orpheus016/sg13cmos5l_spma_ip__instramp/xschem/gain_network/README.md

# coarse_gain

<!-- AUTO:schematic:gain_network -->
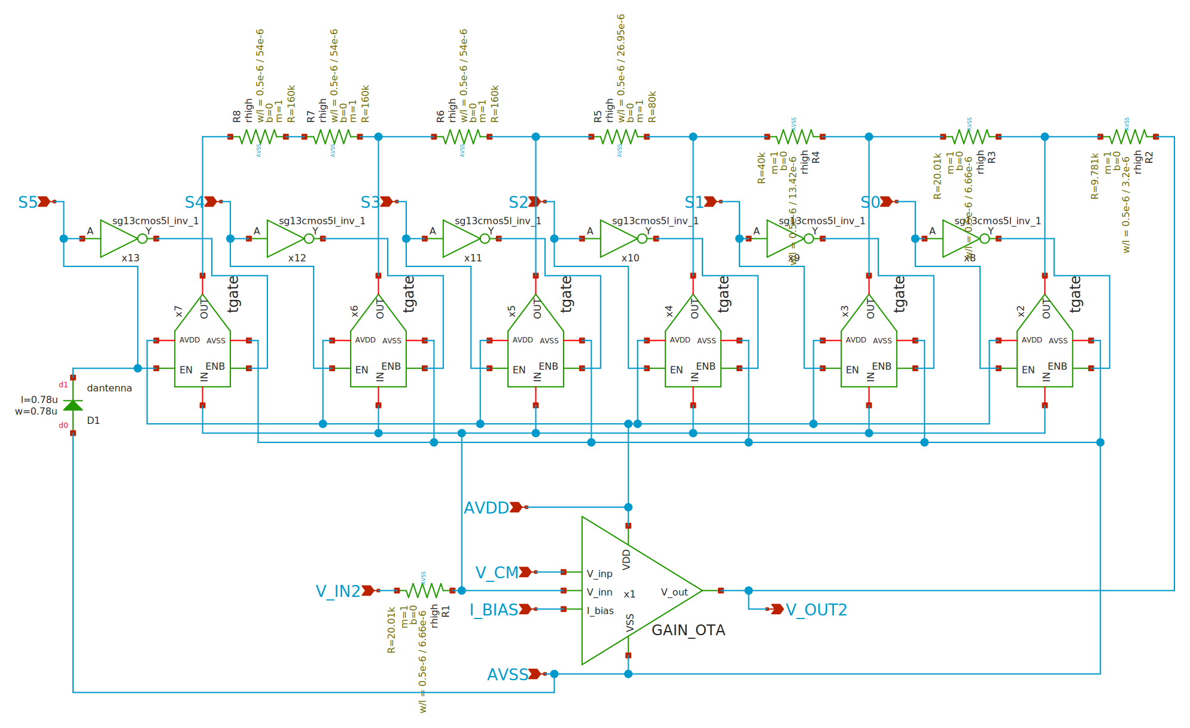
[picture p7: docs/gain_network/media/gain_network_schematic.png]
gain_network schematic

<!-- /AUTO -->

<!-- AUTO:schematic:coarse_gain -->
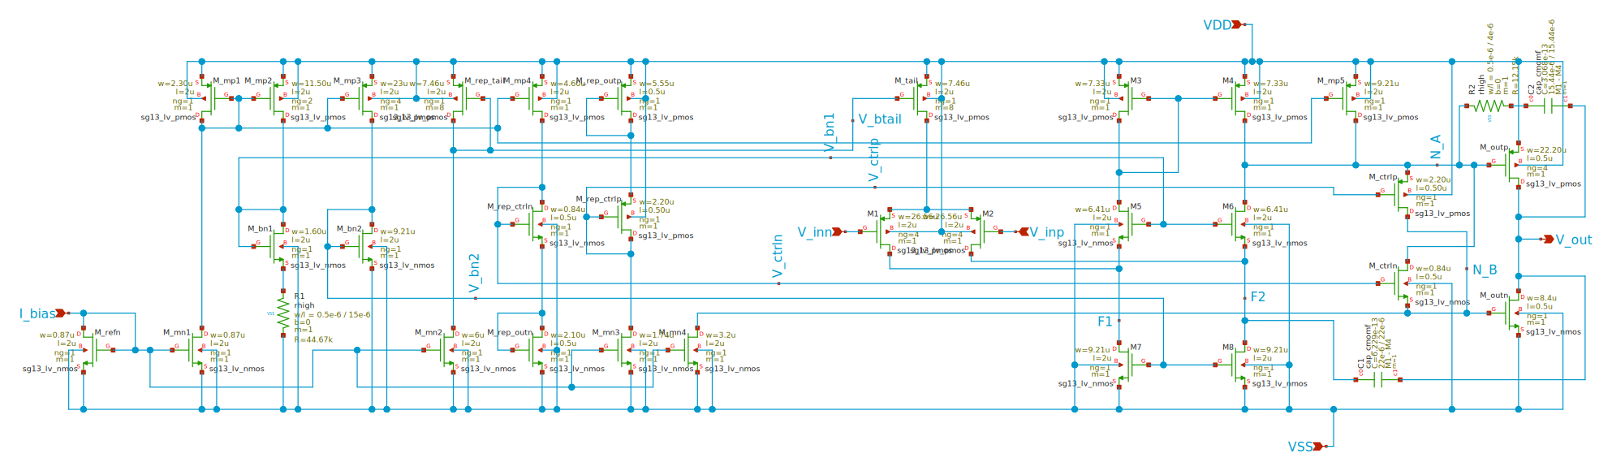
[picture p8: docs/coarse_gain/media/coarse_gain_schematic.png]
coarse_gain schematic


coarse_gain cg_network
<!-- /AUTO -->
