orpheus016/sg13cmos5l_spma_ip__instramp/xschem/gain_ota/README.md

# gain_ota

<!-- AUTO:schematic:gain_ota -->
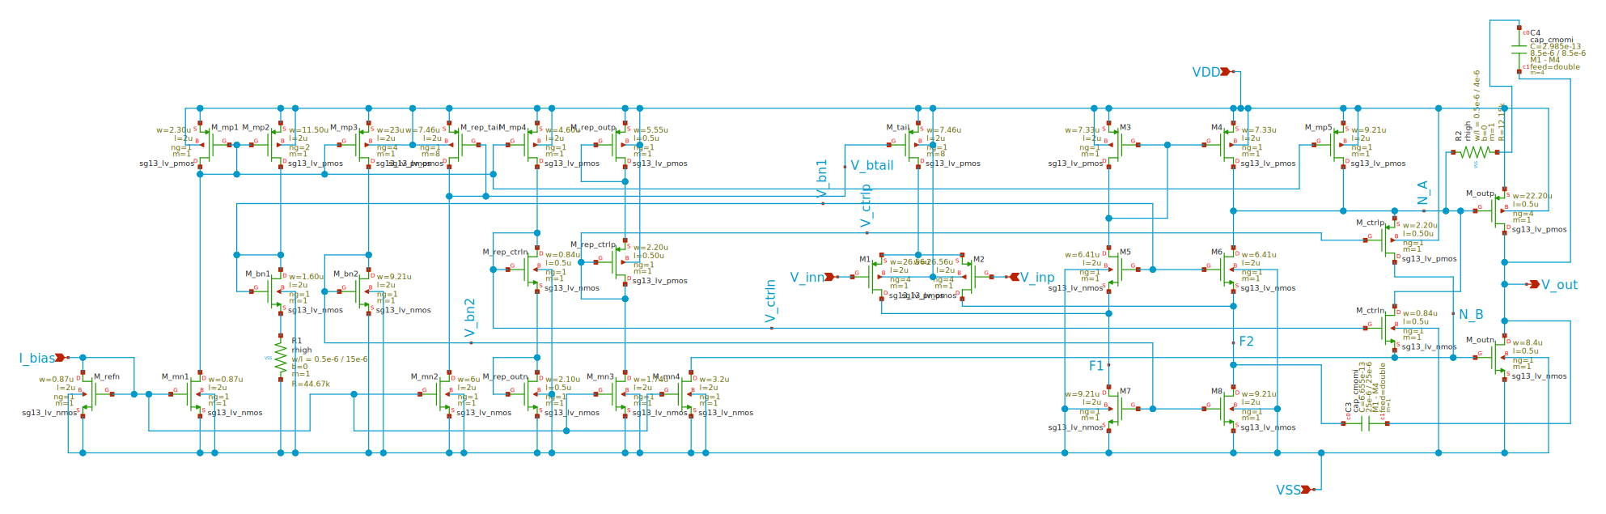
[picture p9: docs/gain_ota/media/gain_ota_schematic.png]
gain_ota schematic

<!-- /AUTO -->
