orpheus016/sg13cmos5l_spma_ip__instramp/docs/pgia_top/cace/README.md

# pgia_top - CACE characterisation

- Generated: 2026-11-05 21:37 by `scripts/make_readme.py` from `runs/RUN_2026-11-05_21-15-09`
- Commit: `a3285dc` (working tree dirty)
- Netlist source: schematic; datasheet: `cace/pgia_top.yaml`; reproduce with `scripts/run_cace.sh pgia_top`
- Sections marked *(CACE)* are written by CACE itself, the rest by this script (CACE has no per-corner MC statistics, worst-case conditions or unit-scaled spread plots).

## Design *(CACE)*

- Description: Top-level Programmable Gain Instrumentation Amplifier IP with 11 gain steps (8x to 8192x)
- PDK: ihp-sg13cmos5l

### Authorship

- Designer: SPMA
- Created: October 23, 2026
- License: MIT
- Company: None
- Last modified: None

### Pins

- AVDD
  + Description: Positive analog power supply (1.2V typ)
  + Type: power
  + Direction: inout
  + Vmin: 1.08
  + Vmax: 1.5
- VPWR
  + Description: Positive digital power supply for decoder (1.2V typ)
  + Type: power
  + Direction: inout
  + Vmin: 1.08
  + Vmax: 1.5
- AVSS
  + Description: Analog ground (0V)
  + Type: ground
  + Direction: inout
- VGND
  + Description: Digital ground for decoder (0V)
  + Type: ground
  + Direction: inout
- IBIAS_IA
  + Description: Bias current input = ibias0 of the harness (1.0 uA sourced into the pin; central_bias makes the IA 4.4 / buffer 1.5 / stage 1.1 uA currents)
  + Type: signal
  + Direction: input
- VINP
  + Description: Non-inverting differential analog input
  + Type: signal
  + Direction: input
- VINN
  + Description: Inverting differential analog input
  + Type: signal
  + Direction: input
- VCM
  + Description: Common-mode reference voltage (0.6V typ)
  + Type: signal
  + Direction: input
- gain_sel[0]
  + Description: Digital gain select bit 0 (LSB)
  + Type: signal
  + Direction: input
- gain_sel[1]
  + Description: Digital gain select bit 1
  + Type: signal
  + Direction: input
- gain_sel[2]
  + Description: Digital gain select bit 2
  + Type: signal
  + Direction: input
- gain_sel[3]
  + Description: Digital gain select bit 3 (MSB)
  + Type: signal
  + Direction: input
- VOUT
  + Description: Single-ended analog output
  + Type: signal
  + Direction: output

### Default Conditions

- vdd
  + Description: Analog and digital power supply voltage
  + Display: Vdd
  + Unit: V
  + Typical: 1.2
- vcm
  + Description: Common-mode voltage
  + Display: Vcm
  + Unit: V
  + Typical: 0.6
- ib_ia
  + Description: Current sourced into the single bias pin IBIAS_IA (ibias0); 0.7 .. 1.3 uA is the working window (xschem/central_bias/README.md)
  + Display: Ib_ia
  + Unit: uA
  + Typical: 1.0
- cl
  + Description: Output load capacitance
  + Display: CLoad
  + Unit: pF
  + Typical: 15
- rl
  + Description: Output load resistance
  + Display: RLoad
  + Unit: kOhm
  + Typical: 100
- cin
  + Description: Input AC coupling capacitance
  + Display: Cin
  + Unit: nF
  + Typical: 10
- vin_off
  + Description: Intentional DC offset on VINP (relative to VCM) that cancels the systematic input-referred offset of the chip. 0 = chip as built; -334.7 uV = the value of tb_pgia_top, the null of the SCHEMATIC; -903.7 uV = the null of the EXTRACTED LAYOUT (C and RC netlists). With the right null gain codes 8 to 10 (x2000 .. x8192) stay in range, without it they rail
  + Display: Vin_off
  + Unit: uV
  + Typical: 0
- gain_code
  + Description: Active 4-bit binary gain code (0 to 10 valid, 11 clamped)
  + Display: Code
  + Typical: 0
- corner
  + Description: Process corner
  + Display: Corner
  + Typical: tt
- rcorner
  + Description: Resistor corner (res_<rcorner> section of cornerRES.lib)
  + Display: Rcorner
  + Typical: typ
- temperature
  + Description: Ambient temperature
  + Display: Temp
  + Unit: °C
  + Typical: 27

### Symbol

Symbol of pgia_top

### Schematic

Schematic of pgia_top

**Parameters** (`.param` of the schematic and of the cells it instantiates; generated by `scripts/update_images.py`, do not edit)

| Source | Parameter | Value |
|---|---|---|
| ota_cmos5l (x1, x2, x3) | `temp` | `27` |
| ota_cmos5l (x1, x2, x3) | `lbias` | `0.15u` |
| ota_cmos5l (x1, x2, x3) | `wbias` | `0.15u` |
| ota_cmos5l (x1, x2, x3) | `m6` | `1` |
| ota_cmos5l (x1, x2, x3) | `m7` | `4` |
| ota_cmos5l (x1, x2, x3) | `m8` | `8` |
| ota_cmos5l (x1, x2, x3) | `linpair` | `3u` |
| ota_cmos5l (x1, x2, x3) | `winpair` | `20u` |
| ota_cmos5l (x1, x2, x3) | `lload` | `5u` |
| ota_cmos5l (x1, x2, x3) | `wload` | `10u` |
| ota_cmos5l (x1, x2, x3) | `lcs` | `3u` |
| ota_cmos5l (x1, x2, x3) | `wcs` | `20u` |
| ota_cmos5l (x1, x2, x3) | `Cc` | `2p` |

### Layout

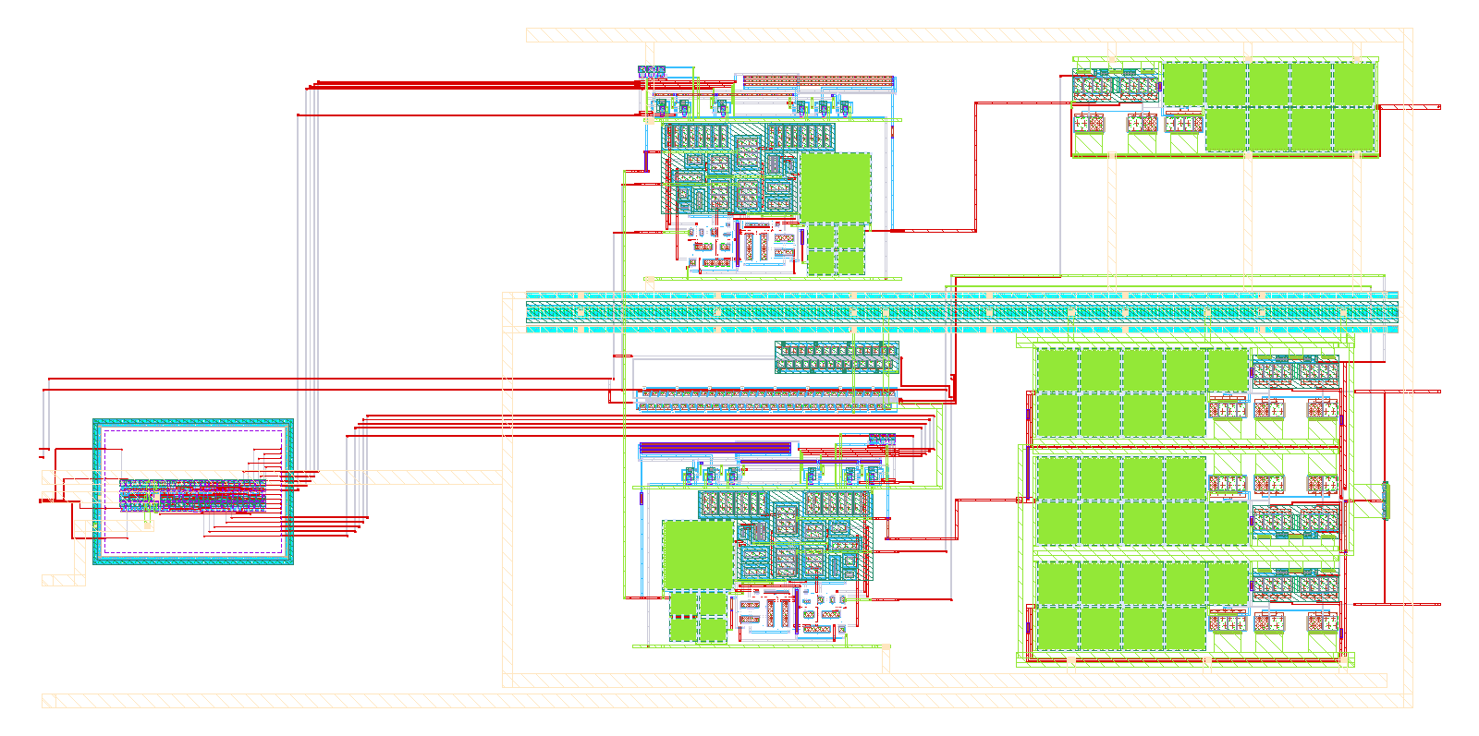
[picture p31: docs/pgia_top/media/pgia_top_layout.png]
Layout of pgia_top


**Physical size** (bounding box of `pgia_top`; generated by `scripts/update_images.py`)

| Width W | Length L | Area |
|---|---|---|
| 514.60 µm | 250.00 µm | 128650 µm² |

## Results summary *(CACE)*

min / typ / max over all conditions of a parameter; Monte Carlo parameters (`mc_*`) are min/max over all samples.

**netlist source**: schematic

| Parameter | Tool | Result | Min Limit  |  Min Value | Typ Target |  Typ Value | Max Limit  |  Max Value |  Status  |
| :--- | :--- | :--- | ---: | ---: | ---: | ---: | ---: | ---: | :---: |
| Closed-loop gain @1 kHz | ngspice | A_CL | any | -157.273 dB | 18.06 dB |  28.225 dB | any |  77.375 dB | Pass ✅ |
| Gain step error vs target | ngspice | A_ERR | any | -235.541 dB | any |  -3.185 dB | any |  23.554 dB | Pass ✅ |
| -3 dB bandwidth | ngspice | F3DB | 1000 Hz | 1421.280 Hz | any | 212798.500 Hz | any | 44479600.000 Hz | Pass ✅ |
| 0 dB frequency | ngspice | F0DB | any | 4883.770 Hz | any | 2894975.000 Hz | any | 10000000.000 Hz | Pass ✅ |
| Phase @1 kHz | ngspice | PH_1K | any | -179.920 ° | any | -0.378 ° | any |  179.972 ° | Pass ✅ |
| Input pseudo-resistor | ngspice | R_PSEUDO | 1 GOhm | 3.563 GOhm | 15 GOhm | 13.573 GOhm | any | 43.802 GOhm | Pass ✅ |
| Output offset voltage | ngspice | VOS | any | 0.026 mV | 1.08 mV |  80.184 mV | any | 661.207 mV | Pass ✅ |
| IA output DC voltage | ngspice | V_IA | any | 0.593 V | 0.6 V | 0.601 V | any | 0.610 V | Pass ✅ |
| Stage 1 output DC voltage | ngspice | V_ST1 | any | 0.273 V | 0.6 V | 0.597 V | any | 1.070 V | Pass ✅ |
| Stage 2 output DC voltage | ngspice | V_ST2 | any | 0.000 V | 0.6 V | 0.601 V | any | 1.500 V | Pass ✅ |
| DC output voltage | ngspice | VOUT | any | 0.011 V | 0.6 V | 0.600 V | any | 1.261 V | Pass ✅ |
| Analog supply current | ngspice | I_AVDD | any | 166.433 uA | 216 uA | 229.546 uA | 400 uA | 315.963 uA | Pass ✅ |
| Digital supply current | ngspice | I_VPWR | any | 0.001 uA | 0.014 uA | 0.021 uA | 1.0 uA | 0.478 uA | Pass ✅ |
| Total quiescent current | ngspice | IQ_TOT | any | 166.434 uA | 216 uA | 229.565 uA | 400 uA | 316.416 uA | Pass ✅ |
| Total DC power | ngspice | PWR | any | 179.749 uW | 260 uW | 272.885 uW | 500 uW | 474.624 uW | Pass ✅ |
| Output peak-to-peak  | ngspice | VPP_OUT | any | 0.000 mV | any | 3.800 mV | any | 544.773 mV | Pass ✅ |
| Effective voltage gain | ngspice | EFF_GAIN | any |  0.000 V/V | any | 94.990 V/V | any | 13619.300 V/V | Pass ✅ |

### Plots *(CACE)*

#### ac_gain_A_CL_vs_temperature

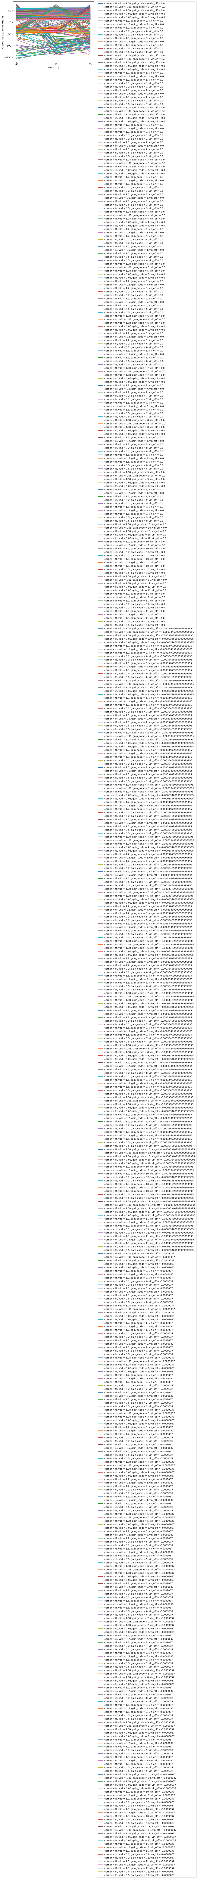
[picture p32: docs/pgia_top/cace/pgia_top/schematic/ac_gain_A_CL_vs_temperature.png]
ac_gain_A_CL_vs_temperature


#### ac_gain_F3DB_vs_temperature

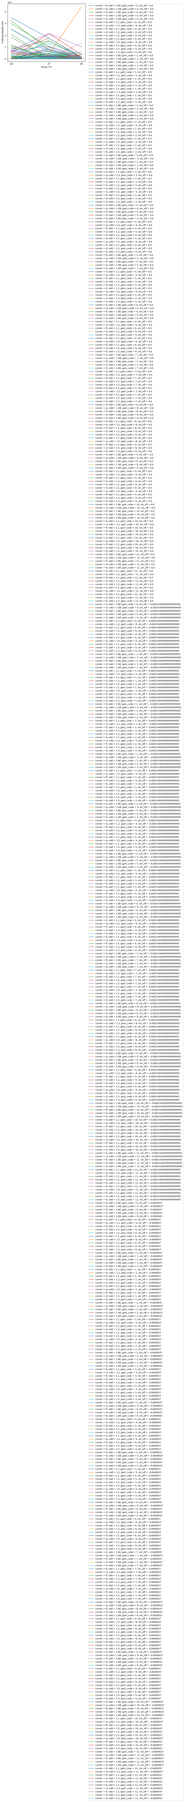
[picture p33: docs/pgia_top/cace/pgia_top/schematic/ac_gain_F3DB_vs_temperature.png]
ac_gain_F3DB_vs_temperature


#### ac_gain_A_CL_vs_gain_code

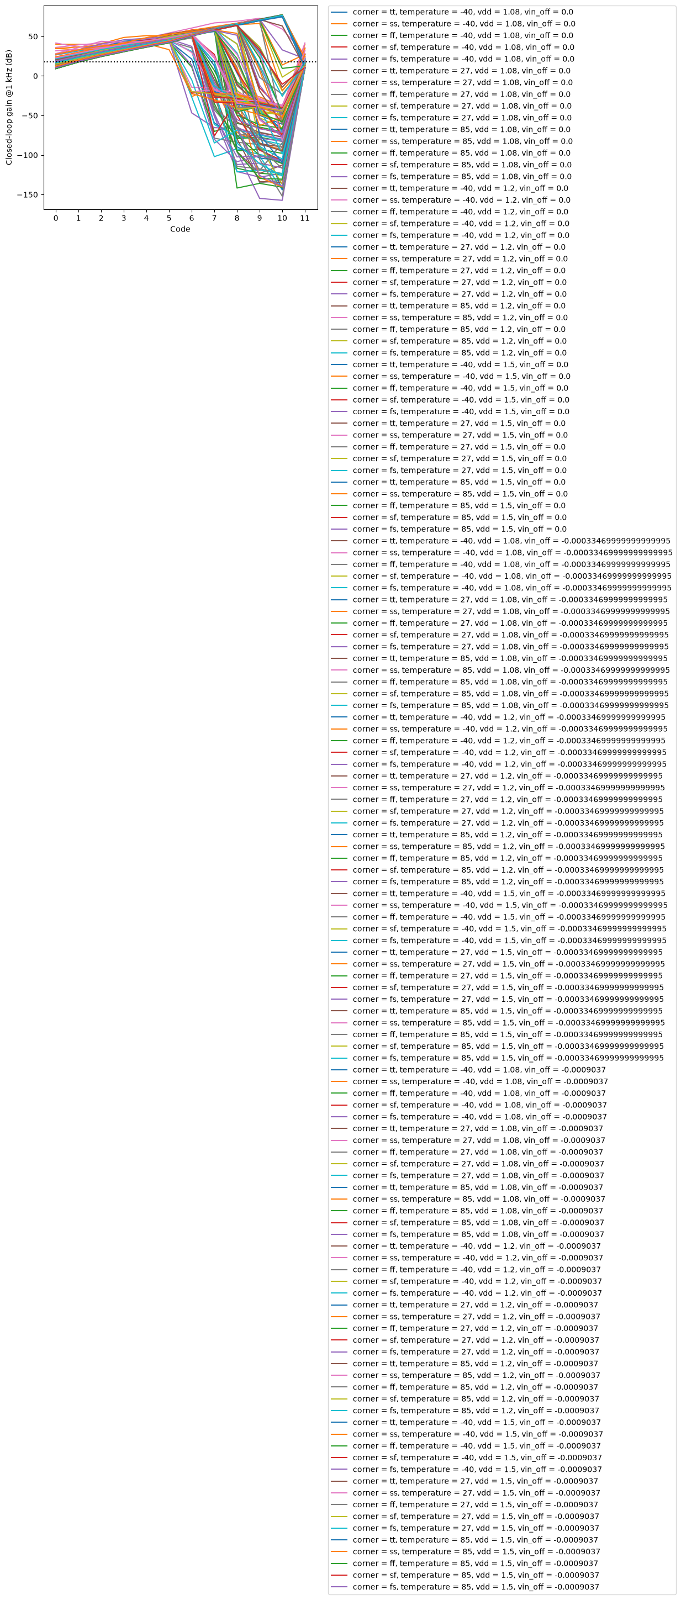
[picture p34: docs/pgia_top/cace/pgia_top/schematic/ac_gain_A_CL_vs_gain_code.png]
ac_gain_A_CL_vs_gain_code


#### ac_gain_R_PSEUDO_vs_temperature

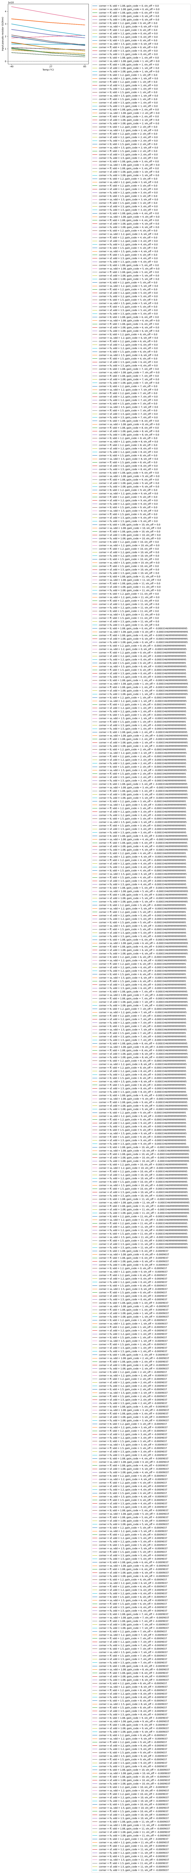
[picture p35: docs/pgia_top/cace/pgia_top/schematic/ac_gain_R_PSEUDO_vs_temperature.png]
ac_gain_R_PSEUDO_vs_temperature


#### dc_op_VOS_vs_temperature

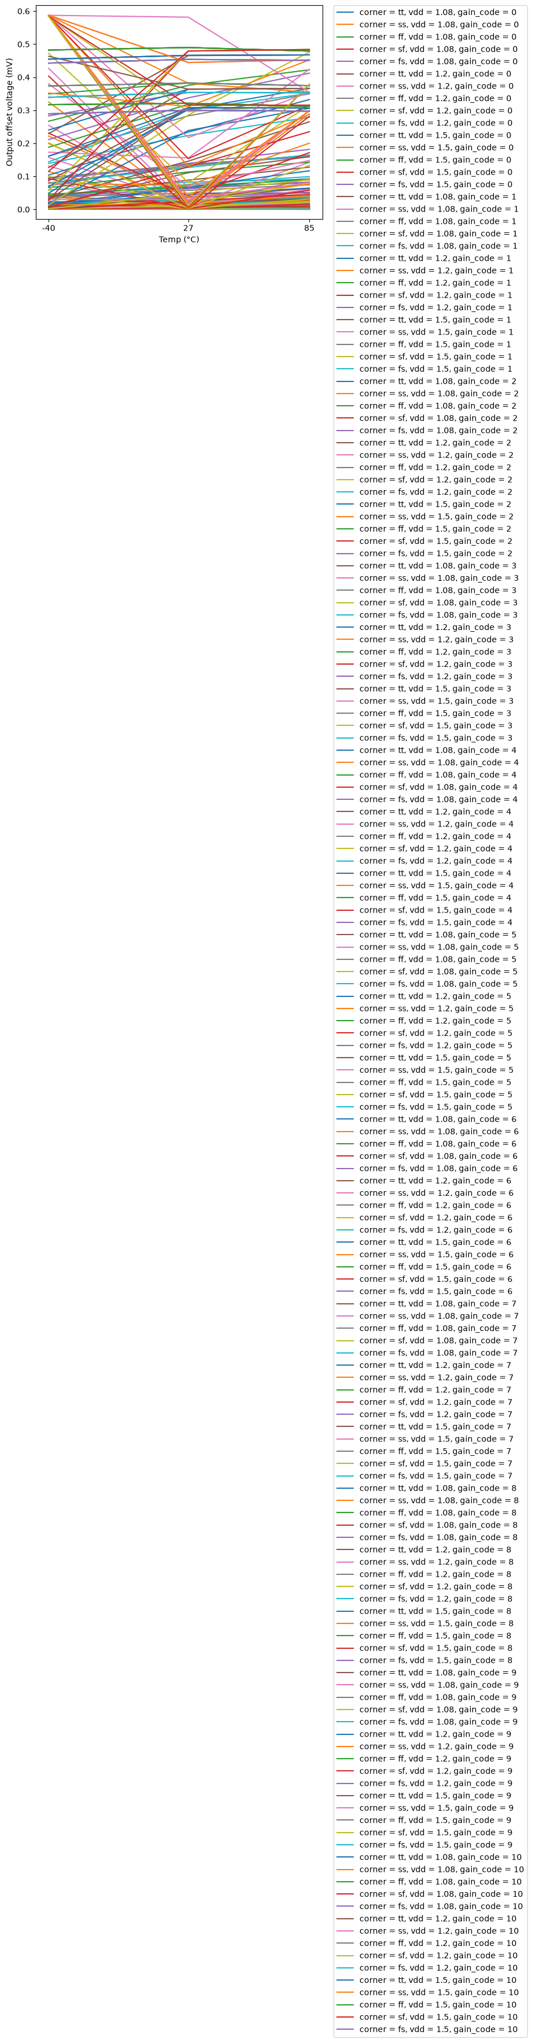
[picture p36: docs/pgia_top/cace/pgia_top/schematic/dc_op_VOS_vs_temperature.png]
dc_op_VOS_vs_temperature


#### dc_op_PWR_vs_temperature

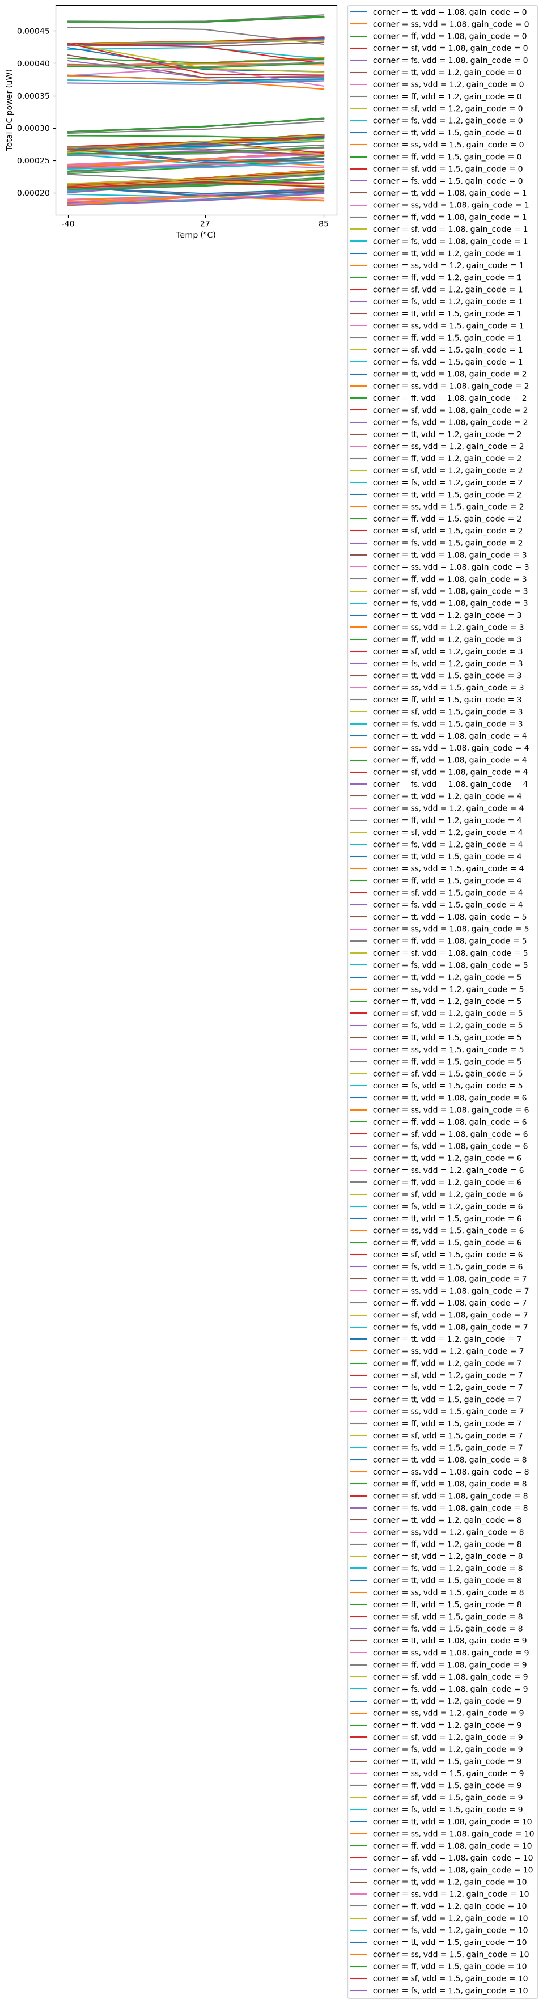
[picture p37: docs/pgia_top/cace/pgia_top/schematic/dc_op_PWR_vs_temperature.png]
dc_op_PWR_vs_temperature


#### dc_op_IQ_TOT_vs_vdd

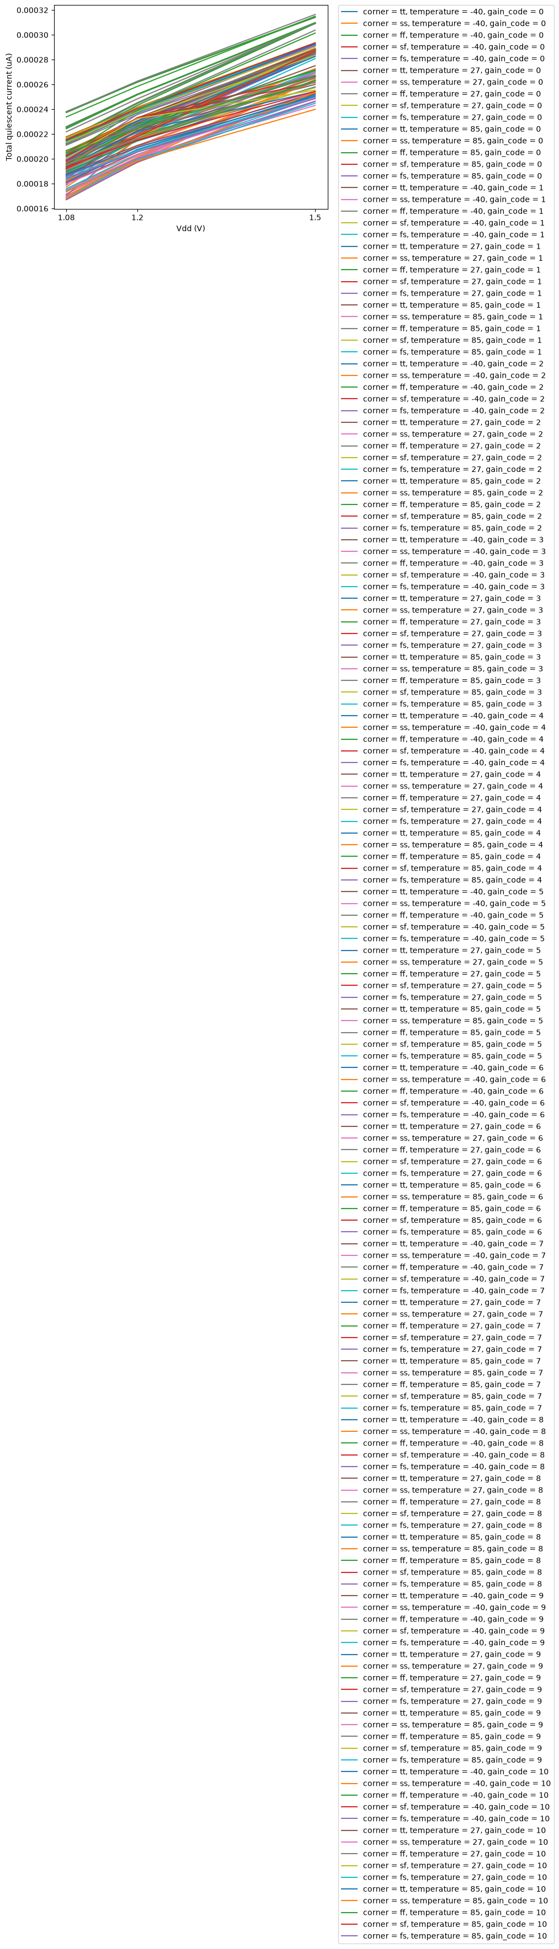
[picture p38: docs/pgia_top/cace/pgia_top/schematic/dc_op_IQ_TOT_vs_vdd.png]
dc_op_IQ_TOT_vs_vdd


#### tran_VPP_OUT_vs_gain_code

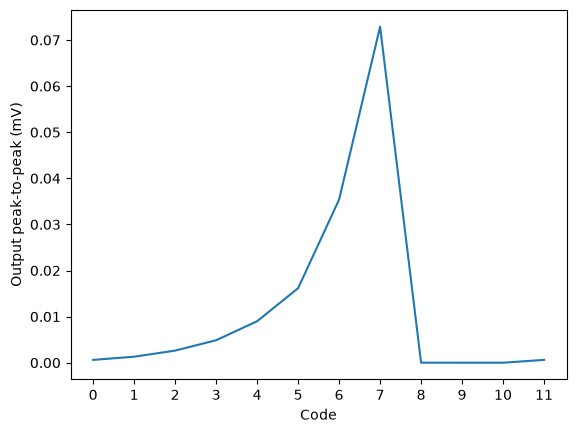
[picture p39: docs/pgia_top/cace/pgia_top/schematic/tran_VPP_OUT_vs_gain_code.png]
tran_VPP_OUT_vs_gain_code


#### tran_EFF_GAIN_vs_gain_code

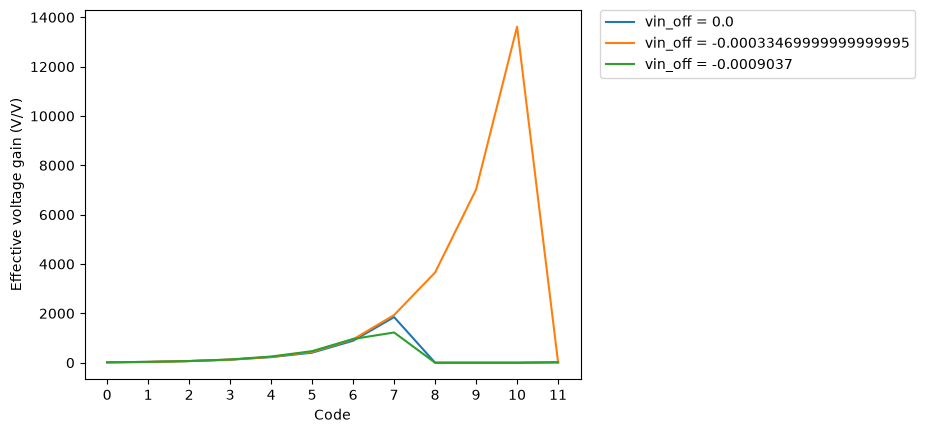
[picture p40: docs/pgia_top/cace/pgia_top/schematic/tran_EFF_GAIN_vs_gain_code.png]
tran_EFF_GAIN_vs_gain_code


## PVT worst-case conditions

Corners tt/ss/ff/sf/fs, supply and temperature as in the yaml. Values in the display unit of the yaml.

### ac_gain - Closed-loop AC gain & bandwidth

1620 runs.

| metric | min | at (corner, vdd, T) | max | at (corner, vdd, T) | spec | fails |
|---|---|---|---|---|---|---|
| A_CL [dB] | -157.3 | fs, 1.5 V, -40 C | 77.38 | tt, 1.08 V, -40 C | any | - |
| A_ERR [dB] | -235.5 | fs, 1.5 V, -40 C | 23.55 | ss, 1.08 V, -40 C | any | - |
| F3DB [Hz] | 1421 | fs, 1.08 V, -40 C | 4.448e+07 | ss, 1.5 V, 85 C | >= 1000 | 0 |
| F0DB [Hz] | 4884 | ff, 1.08 V, 27 C | 1e+07 | ss, 1.08 V, -40 C | any | - |
| PH_1K [°] | -179.9 | ss, 1.5 V, 85 C | 180 | sf, 1.2 V, 27 C | any | - |
| R_PSEUDO [GOhm] | 3.563 | ff, 1.08 V, 85 C | 43.8 | ss, 1.5 V, -40 C | >= 1 | 0 |

### dc_op - DC operating point

1485 runs.

| metric | min | at (corner, vdd, T) | max | at (corner, vdd, T) | spec | fails |
|---|---|---|---|---|---|---|
| VOS [mV] | 0.02615 | sf, 1.5 V, 27 C | 661.2 | ff, 1.5 V, 85 C | any | - |
| V_IA [V] | 0.5934 | ff, 1.5 V, -40 C | 0.61 | ss, 1.08 V, 27 C | any | - |
| V_ST1 [V] | 0.2733 | fs, 1.08 V, 85 C | 1.07 | ss, 1.08 V, -40 C | any | - |
| V_ST2 [V] | 0.0001096 | ff, 1.5 V, -40 C | 1.5 | ff, 1.5 V, -40 C | any | - |
| VOUT [V] | 0.01084 | fs, 1.08 V, -40 C | 1.261 | ff, 1.5 V, 85 C | any | - |
| I_AVDD [uA] | 166.4 | ss, 1.08 V, -40 C | 316 | ff, 1.5 V, 85 C | <= 400 | 0 |
| I_VPWR [uA] | 0.001241 | ss, 1.08 V, -40 C | 0.4783 | ff, 1.5 V, 85 C | <= 1 | 0 |
| IQ_TOT [uA] | 166.4 | ss, 1.08 V, -40 C | 316.4 | ff, 1.5 V, 85 C | <= 400 | 0 |
| PWR [uW] | 179.7 | ss, 1.08 V, -40 C | 474.6 | ff, 1.5 V, 85 C | <= 500 | 0 |

### tran - Dynamic transient response

36 runs.

| metric | min | at (corner, vdd, T) | max | at (corner, vdd, T) | spec | fails |
|---|---|---|---|---|---|---|
| VPP_OUT [mV] | 1.543e-06 | tt, 1.2 V, 27 C | 544.8 | tt, 1.2 V, 27 C | any | - |
| EFF_GAIN [V/V] | 3.857e-05 | tt, 1.2 V, 27 C | 1.362e+04 | tt, 1.2 V, 27 C | any | - |

## Monte Carlo (local mismatch)

Mismatch models only (`mos_<corner>_mismatch`, `res_typ_mismatch`; `cap_cmomi` has no characterised spread), one seed per iteration (`seed = 12345 + iteration`, **the same 50 mismatch draws are reused at every corner and temperature**, so boxes are paired comparisons and the pooled counts overstate the number of independent samples: 50, not 50 x 15). Box = interquartile range, dots = individual samples, dotted lines = spec (if any).
