orpheus016/sg13cmos5l_spma_ip__instramp/docs/pgia_top/cace/pgia_top_schematic.md

# CACE Summary for pgia_top

**netlist source**: schematic

| Parameter | Tool | Result | Min Limit  |  Min Value | Typ Target |  Typ Value | Max Limit  |  Max Value |  Status  |
| :--- | :--- | :--- | ---: | ---: | ---: | ---: | ---: | ---: | :---: |
| Closed-loop gain @1 kHz | ngspice | A_CL | any | -157.273 dB | 18.06 dB |  26.910 dB | any |  77.375 dB | Pass ✅ |
| Gain step error vs target | ngspice | A_ERR | any | -235.541 dB | any |  -3.527 dB | any |  21.937 dB | Pass ✅ |
| -3 dB bandwidth | ngspice | F3DB | 1000 Hz | 1421.280 Hz | any | 220131.000 Hz | any | 44479600.000 Hz | Pass ✅ |
| 0 dB frequency | ngspice | F0DB | any | 27614.500 Hz | any | 2838315.000 Hz | any | 10000000.000 Hz | Pass ✅ |
| Phase @1 kHz | ngspice | PH_1K | any | -179.244 ° | any | -0.377 ° | any |  179.812 ° | Pass ✅ |
| Input pseudo-resistor | ngspice | R_PSEUDO | 1 GOhm | 3.563 GOhm | 15 GOhm | 13.559 GOhm | any | 43.789 GOhm | Pass ✅ |
| Output offset voltage | ngspice | VOS | any | 0.026 mV | 1.08 mV |  81.581 mV | any | 661.207 mV | Pass ✅ |
| IA output DC voltage | ngspice | V_IA | any | 0.600 V | 0.6 V | 0.603 V | any | 0.610 V | Pass ✅ |
| Stage 1 output DC voltage | ngspice | V_ST1 | any | 0.273 V | 0.6 V | 0.565 V | any | 0.916 V | Pass ✅ |
| Stage 2 output DC voltage | ngspice | V_ST2 | any | 0.000 V | 0.6 V | 0.634 V | any | 1.500 V | Pass ✅ |
| DC output voltage | ngspice | VOUT | any | 0.012 V | 0.6 V | 0.633 V | any | 1.261 V | Pass ✅ |
| Analog supply current | ngspice | I_AVDD | any | 167.053 uA | 216 uA | 225.907 uA | 400 uA | 315.963 uA | Pass ✅ |
| Digital supply current | ngspice | I_VPWR | any | 0.001 uA | 0.014 uA | 0.021 uA | 1.0 uA | 0.478 uA | Pass ✅ |
| Total quiescent current | ngspice | IQ_TOT | any | 167.059 uA | 216 uA | 225.949 uA | 400 uA | 316.416 uA | Pass ✅ |
| Total DC power | ngspice | PWR | any | 180.424 uW | 260 uW | 269.308 uW | 500 uW | 474.624 uW | Pass ✅ |
| Output peak-to-peak  | ngspice | VPP_OUT | any | 0.000 mV | any | 1.969 mV | any |  73.973 mV | Pass ✅ |
| Effective voltage gain | ngspice | EFF_GAIN | any |  0.000 V/V | any | 49.237 V/V | any | 1849.330 V/V | Pass ✅ |

## Plots

## ac_gain_A_CL_vs_temperature

ac_gain_A_CL_vs_temperature

## ac_gain_F3DB_vs_temperature

ac_gain_F3DB_vs_temperature

## ac_gain_A_CL_vs_gain_code

ac_gain_A_CL_vs_gain_code

## ac_gain_R_PSEUDO_vs_temperature

ac_gain_R_PSEUDO_vs_temperature

## dc_op_VOS_vs_temperature

dc_op_VOS_vs_temperature

## dc_op_PWR_vs_temperature

dc_op_PWR_vs_temperature

## dc_op_IQ_TOT_vs_vdd

dc_op_IQ_TOT_vs_vdd

## tran_VPP_OUT_vs_gain_code

tran_VPP_OUT_vs_gain_code

## tran_EFF_GAIN_vs_gain_code

tran_EFF_GAIN_vs_gain_code
