orpheus016/sg13cmos5l_spma_ip__instramp/docs/gain_ota/status.md

# gain_ota: flow status

`scripts/flow.sh gain_ota` at 2026-11-05T21:09:51 (commit a3285dc, profile typ)

layout `gds/gain_ota/gain_ota.gds` sha1 `e2632fd500b4`, schematic `xschem/gain_ota/gain_ota.sch` sha1 `d747b5e7626f`

| Stage | Result | Time | Detail |
|---|---|---:|---|
| cace | ✅ pass | 0 s | reused RUN_2026-11-05_17-29-30: 44 rows, 0 failing |
| drc | ✅ pass | 19 s | main : 0 items [ok];antenna : 0 items [ok];density : 7 items [info, chip-level]; |
| audit | ✅ pass | 0 s |  all device Activ within the tie distance, every NWell tied; no p+/n+ abutment outside standard cells; |
| lvs | ✅ pass | 8 s | RESULT: MATCH |
| pex | ✅ pass | 14 s | gain_ota.c.spice: ports VDD V_inp V_inn V_out I_bias VSS; M=57, Rpoly=2, Rext=0, Cdev=5, Cext=182, D=0;gain_ota.rc.spice: ports VDD V_inp V_inn V_out I_bias VSS; X=59, R=2397, C=585, Cdev=5; |
| post_c | ✅ pass | 18 s | 41 parameters with a % delta, 27 flagged |
| post_rc | ✅ pass | 36 s | 41 parameters with a % delta, 22 flagged |
| images | ✅ pass | 1 s | 0 updated, 5 unchanged, 0 error(s), 0 warning(s) |
| post | ⏭ skip | 0 s | no layout |

Schematic vs post-layout (wire C only): [postlayout.md](cace/postlayout.md)

Schematic vs post-layout (wire R + C): [postlayout_rc.md](cace/postlayout_rc.md)
