orpheus016/sg13cmos5l_spma_ip__instramp/docs/decoder_top_10b/status.md

# decoder_top_10b: flow status

`scripts/flow.sh decoder_top_10b` at 2026-11-04T05:16:50 (commit 0f10340, profile typ)

layout `gds/pgia_top/decoder_top_10b.gds` sha1 `d3e6cf2b74d4`, schematic `xschem/decoder_top_10b/decoder_top_10b.sch` sha1 `None`

| Stage | Result | Time | Detail |
|---|---|---:|---|
| drc | ❌ fail | 27 s | main : 19 items [fail];antenna : 0 items [ok];density : 6 items [info, chip-level]; |
