orpheus016/sg13cmos5l_spma_ip__instramp/docs/ota_cmos5l/status.md

# ota_cmos5l: flow status

`scripts/flow.sh ota_cmos5l` at 2026-11-05T18:48:41 (commit b495d99, profile typ)

layout `gds/pgia_top/ota_cmos5l.gds` sha1 `d27c68f60025`, schematic `xschem/ota_cmos5l/ota_cmos5l.sch` sha1 `98f97e2e52a6`

| Stage | Result | Time | Detail |
|---|---|---:|---|
| cace | ✅ pass | 0 s | reused RUN_2026-11-05_17-23-53: 43 rows, 0 failing |
| drc | ✅ pass | 19 s | main : 0 items [ok];antenna : 0 items [ok];density : 6 items [info, chip-level]; |
| audit | ✅ pass | 0 s |  all device Activ within the tie distance, every NWell tied; 11 p+/n+ abutment site(s), all in the accepted baseline; |
| lvs | ✅ pass | 5 s | RESULT: MATCH |
| pex | ✅ pass | 5 s | ota_cmos5l.c.spice: ports VSS IBIAS VDD VINN VINP VOUT; M=29, Rpoly=1, Rext=0, Cdev=9, Cext=48, D=0;ota_cmos5l.rc.spice: ports VSS IBIAS VDD VINN VINP VOUT; X=30, R=273, C=116, Cdev=9; |
| post_c | ✅ pass | 13 s | 40 parameters with a % delta, 5 flagged |
| post_rc | ✅ pass | 18 s | 40 parameters with a % delta, 21 flagged |
| images | ✅ pass | 1 s | 0 updated, 5 unchanged, 0 error(s), 0 warning(s) |

Schematic vs post-layout (wire C only): [postlayout.md](cace/postlayout.md)

Schematic vs post-layout (wire R + C): [postlayout_rc.md](cace/postlayout_rc.md)
