orpheus016/sg13cmos5l_spma_ip__instramp/docs/pgia_top/cace/gain_codes.md

# pgia_top: gain per code, schematic vs post-layout

Condition: corner tt, resistor corner typ, 27 C, vdd 1.2 V, ibias0 1.0 uA (single bias pin, central_bias on chip). Differential input 1 V ac, ac gain at 1 kHz.

* schematic: `runs/RUN_2026-11-05_17-41-44`
* post-layout C (kpex wire capacitance): `runs/pex_cace/pgia_top/RUN_2026-11-05_18-39-19`
* post-layout RC (Magic wire R + C): `runs/pex_cace_rc/pgia_top/RUN_2026-11-05_18-40-35`

| Code | Target dB | A_CL schematic | A_CL C | A_CL RC | Δ C | Δ RC | F3DB schematic kHz | F3DB C kHz | F3DB RC kHz | R_pseudo schematic / C / RC GOhm |
|---:|---:|---:|---:|---:|---:|---:|---:|---:|---:|---|
| 0 | 18.06 | 17.62 | 17.62 | 17.65 | -0.01 | +0.02 | 228 | 232 | 209 | 15 / 16.9 / 17 |
| 1 | 24.08 | 24.25 | 24.20 | 24.20 | -0.05 | -0.05 | 227 | 231 | 208 | 15 / 16.9 / 17 |
| 2 | 30.10 | 30.36 | 30.23 | 30.21 | -0.13 | -0.15 | 226 | 228 | 207 | 15 / 16.9 / 17 |
| 3 | 36.12 | 35.74 | 35.46 | 35.43 | -0.28 | -0.31 | 222 | 222 | 203 | 15 / 16.9 / 17 |
| 4 | 42.14 | 41.07 | 40.47 | 40.44 | -0.60 | -0.63 | 212 | 208 | 195 | 15 / 16.9 / 17 |
| 5 | 48.16 | 46.17 | 45.02 | 44.99 | -1.15 | -1.18 | 191 | 184 | 178 | 15 / 16.9 / 17 |
| 6 | 54.19 | 52.98 | 34.97 | 36.69 | -18.00 | -16.29 | 193 | 8 | 6 | 15 / 16.9 / 16.6 |
| 7 | 60.21 | 59.33 | -81.12 | -28.70 | -140.45 | -88.03 | 168 | 4150 | 115 | 15 / 16.9 / 18.4 |
| 8 | 66.23 | -20.81 | -81.28 | -33.16 | -60.46 | -12.35 | 808 | 4158 | 126 | 15 / 16.9 / 17.8 |
| 9 | 72.25 | -92.86 | -81.15 | -37.10 | +11.71 | +55.77 | 3098 | 4132 | 160 | 15 / 16.9 / 17.5 |
| 10 | 78.27 | -110.88 | -81.08 | -40.06 | +29.80 | +70.82 | 6751 | 4118 | 236 | 15 / 16.9 / 17.3 |
| 11 | clamped | 17.62 | 17.62 | 17.65 | -0.01 | +0.02 | 228 | 232 | 209 | 15 / 16.9 / 17 |
