orpheus016/sg13cmos5l_spma_ip__instramp/docs/central_bias/report.html

# Cell report¶

Interactive results of scripts/flow.sh <cell>: schematic CACE run (PVT and Monte Carlo), DRC / antenna / LVS, extraction and the schematic vs post-layout comparison (wire C only, and wire R + C). Generated by scripts/build_report.sh; the cell comes from the environment variable CELL (default ota_cmos5l). Every plot is interactive: hover for values, drag to zoom, double-click to reset, click a legend entry to hide it, use the drop-down to change the variable.

## central_bias¶

schematic run: runs/RUN_2026-11-05_21-13-38, flow run 2026-11-05T21:15:08 (commit a3285dc)

## Status¶

name | result | seconds | detail
cace | ✅ pass | 73 | /foss/designs/sg13cmos5l_spma_ip__instramp/runs/RUN_2026-11-05_21-13-38: 17 rows
drc | ✅ pass | 13 | main : 0 items [ok];antenna : 0 items [ok];density : 6 items [info, chip-level];
audit | ✅ pass | 0 | all device Activ within the tie distance, every NWell tied; no p+/n+ abutment outside standard cells;
lvs | ✅ pass | 4 | RESULT: MATCH
pex | ✅ pass | 13 | central_bias.c.spice: ports IB_IN IB_IA IB_BUF IB_G1 IB_G2 AVDD AVSS; M=90, Rpoly=0, Rext=0, Cdev=0, Cext=27, D=0;central_bias.rc.spice: ports IB_IN IB_IA IB_BUF IB_G1 IB_G2 AVDD AVSS; X=90, R=488, C=
post_c | ✅ pass | 8 | 8 parameters with a % delta, 0 flagged
post_rc | ✅ pass | 5 | 8 parameters with a % delta, 0 flagged
images | ✅ pass | 1 | 0 updated, 5 unchanged, 0 error(s), 0 warning(s)
post | ⛔ blocked | 0 | pex stage: error

## Schematic and layout¶

Circuit only (SPICE code blocks removed), light colour scheme; pictures are regenerated by scripts/update_images.py. The schematic is a vector drawing: use the browser zoom (Ctrl +) or open it in a new tab to read small text.

### Schematic¶

### Layout¶

No description has been provided for this image

Physical size (bounding box of central_bias)

Width W [µm] | Length L [µm] | Area [µm²]
99.68 | 26.34 | 2625.60

## Specification table (schematic, over PVT)¶

parameter | variable | min_limit | min_value | typ_value | max_limit | max_value | pass
Current into the instrumentation amplifier (sink) | I_IA | any | 2.611 uA | 4.444 uA | any | 6.782 uA | ✅
Current into the output buffer (sink) | I_BUF | any | 0.870 uA | 1.481 uA | any | 2.261 uA | ✅
Current into gain stage 1 (source) | I_G1 | any | 0.664 uA | 1.080 uA | any | 1.618 uA | ✅
Current into gain stage 2 (source) | I_G2 | any | 0.664 uA | 1.080 uA | any | 1.618 uA | ✅
Ratio I_IA / ibias0 | R_IA | 3.1 A/A | 3.547 A/A | 4.461 A/A | 5.7 A/A | 5.678 A/A | ✅
Ratio I_BUF / ibias0 | R_BUF | 1.0 A/A | 1.182 A/A | 1.487 A/A | 1.9 A/A | 1.893 A/A | ✅
Ratio I_G / ibias0 (mean of the two stages) | R_G | 0.75 A/A | 0.908 A/A | 1.096 A/A | 1.4 A/A | 1.344 A/A | ✅
Stage 1 / stage 2 current difference | ERR_G | -3 % | -0.000 % | 0.000 % | 3 % | 0.000 % | ✅
Supply power of the block (with the loads) | PWR | any | 5.979 uW | 11.391 uW | any | 21.038 uW | ✅
Current into the instrumentation amplifier (sink) | I_IA | any | 3.623 uA | 4.409 uA | any | 5.059 uA | ✅
Current into the output buffer (sink) | I_BUF | any | 1.195 uA | 1.461 uA | any | 1.736 uA | ✅
Current into gain stage 1 (source) | I_G1 | any | 0.893 uA | 1.083 uA | any | 1.235 uA | ✅
Current into gain stage 2 (source) | I_G2 | any | 0.886 uA | 1.080 uA | any | 1.237 uA | ✅
Ratio I_IA / ibias0 | R_IA | any | 3.623 A/A | 4.409 A/A | any | 5.059 A/A | ✅
Ratio I_BUF / ibias0 | R_BUF | any | 1.195 A/A | 1.461 A/A | any | 1.736 A/A | ✅
Ratio I_G / ibias0 (mean of the two stages) | R_G | any | 0.889 A/A | 1.081 A/A | any | 1.232 A/A | ✅
Stage 1 / stage 2 current difference | ERR_G | any | -224.432 % | 28.986 % | any | 272.332 % | ✅

## PVT explorer¶

Each marker is one CACE run (corner = colour, supply = marker shape). Dashed lines are the specification limits of the datasheet.

### Worst cases over PVT¶

variable | unit | min | min_at | max | max_at | spec_min | spec_max | violations
I_IA | uA | 2.611 | ss, 1.08 V, -40 °C | 6.7822 | ff, 1.5 V, 85 °C | any | any | 0/135
I_BUF | uA | 0.87033 | ss, 1.08 V, -40 °C | 2.2607 | ff, 1.5 V, 85 °C | any | any | 0/135
I_G1 | uA | 0.66366 | ss, 1.08 V, -40 °C | 1.6184 | ff, 1.5 V, 85 °C | any | any | 0/135
I_G2 | uA | 0.66366 | ss, 1.08 V, -40 °C | 1.6184 | ff, 1.5 V, 85 °C | any | any | 0/135
R_IA | A/A | 3.5465 | ss, 1.08 V, -40 °C | 5.6783 | ff, 1.5 V, 85 °C | 3.1 | 5.7 | 0/135
R_BUF | A/A | 1.1822 | ss, 1.08 V, -40 °C | 1.8928 | ff, 1.5 V, 85 °C | 1 | 1.9 | 0/135
R_G | A/A | 0.90756 | ss, 1.08 V, -40 °C | 1.3443 | ff, 1.5 V, 85 °C | 0.75 | 1.4 | 0/135
ERR_G | % | -3.1557e-10 | sf, 1.2 V, -40 °C | 5.3691e-10 | ss, 1.2 V, -40 °C | -3 | 3 | 0/135
PWR | uW | 5.9793 | ss, 1.08 V, -40 °C | 21.038 | ff, 1.5 V, 85 °C | any | any | 0/135

## Monte Carlo (mismatch)¶

variable | corner | count | mean | std | min | max | mean-3σ | mean+3σ
ERR_G | ff | 150 | 31.479 | 103.06 | -222.05 | 267.99 | -277.71 | 340.67
ERR_G | fs | 150 | 31.295 | 103.59 | -222.39 | 269.17 | -279.48 | 342.07
ERR_G | sf | 150 | 31.61 | 103.9 | -223.6 | 270.3 | -280.08 | 343.3
ERR_G | ss | 150 | 31.496 | 104.48 | -224.43 | 272.33 | -281.96 | 344.95
ERR_G | tt | 150 | 31.425 | 103.74 | -222.83 | 269.31 | -279.81 | 342.66
I_BUF | ff | 150 | 1.5635 | 0.063822 | 1.3986 | 1.7359 | 1.372 | 1.755
I_BUF | fs | 150 | 1.447 | 0.061733 | 1.2873 | 1.6119 | 1.2618 | 1.6322
I_BUF | sf | 150 | 1.4719 | 0.062645 | 1.3059 | 1.6383 | 1.2839 | 1.6598
I_BUF | ss | 150 | 1.3569 | 0.062043 | 1.1954 | 1.5193 | 1.1707 | 1.543
I_BUF | tt | 150 | 1.4585 | 0.062003 | 1.2959 | 1.6236 | 1.2725 | 1.6445
I_G1 | ff | 150 | 1.1341 | 0.049872 | 0.99714 | 1.235 | 0.98447 | 1.2837
I_G1 | fs | 150 | 1.0814 | 0.048753 | 0.94663 | 1.1804 | 0.93511 | 1.2276
I_G1 | sf | 150 | 1.0798 | 0.048885 | 0.94351 | 1.1787 | 0.93317 | 1.2265
I_G1 | ss | 150 | 1.028 | 0.049021 | 0.89278 | 1.1278 | 0.88095 | 1.1751
I_G1 | tt | 150 | 1.0807 | 0.048698 | 0.9453 | 1.1793 | 0.93456 | 1.2268
I_G2 | ff | 150 | 1.1305 | 0.049156 | 0.98925 | 1.2374 | 0.98302 | 1.278
I_G2 | fs | 150 | 1.078 | 0.048107 | 0.93909 | 1.1824 | 0.93364 | 1.2223
I_G2 | sf | 150 | 1.0764 | 0.048221 | 0.93602 | 1.1812 | 0.93172 | 1.221
I_G2 | ss | 150 | 1.0248 | 0.048452 | 0.88563 | 1.1301 | 0.8794 | 1.1701
I_G2 | tt | 150 | 1.0772 | 0.048041 | 0.93778 | 1.1816 | 0.93312 | 1.2214
I_IA | ff | 150 | 4.7115 | 0.17318 | 4.2041 | 5.0589 | 4.192 | 5.2311
I_IA | fs | 150 | 4.3622 | 0.16903 | 3.8756 | 4.6972 | 3.8551 | 4.8693
I_IA | sf | 150 | 4.4372 | 0.17117 | 3.9507 | 4.7743 | 3.9237 | 4.9507
I_IA | ss | 150 | 4.0922 | 0.17164 | 3.6226 | 4.4272 | 3.5773 | 4.6071
I_IA | tt | 150 | 4.3969 | 0.16954 | 3.9109 | 4.7315 | 3.8883 | 4.9056
R_BUF | ff | 150 | 1.5635 | 0.063822 | 1.3986 | 1.7359 | 1.372 | 1.755
R_BUF | fs | 150 | 1.447 | 0.061733 | 1.2873 | 1.6119 | 1.2618 | 1.6322
R_BUF | sf | 150 | 1.4719 | 0.062645 | 1.3059 | 1.6383 | 1.2839 | 1.6598
R_BUF | ss | 150 | 1.3569 | 0.062043 | 1.1954 | 1.5193 | 1.1707 | 1.543
R_BUF | tt | 150 | 1.4585 | 0.062003 | 1.2959 | 1.6236 | 1.2725 | 1.6445
R_G | ff | 150 | 1.1323 | 0.049175 | 0.99319 | 1.2319 | 0.98476 | 1.2798
R_G | fs | 150 | 1.0797 | 0.048112 | 0.94286 | 1.177 | 0.93533 | 1.224
R_G | sf | 150 | 1.0781 | 0.048235 | 0.93976 | 1.1759 | 0.9334 | 1.2228
R_G | ss | 150 | 1.0264 | 0.048447 | 0.8892 | 1.1249 | 0.88105 | 1.1717
R_G | tt | 150 | 1.0789 | 0.048051 | 0.94154 | 1.1762 | 0.93479 | 1.2231
R_IA | ff | 150 | 4.7115 | 0.17318 | 4.2041 | 5.0589 | 4.192 | 5.2311
R_IA | fs | 150 | 4.3622 | 0.16903 | 3.8756 | 4.6972 | 3.8551 | 4.8693
R_IA | sf | 150 | 4.4372 | 0.17117 | 3.9507 | 4.7743 | 3.9237 | 4.9507
R_IA | ss | 150 | 4.0922 | 0.17164 | 3.6226 | 4.4272 | 3.5773 | 4.6071
R_IA | tt | 150 | 4.3969 | 0.16954 | 3.9109 | 4.7315 | 3.8883 | 4.9056

## Schematic vs post-layout¶

Two extractions of the same layout: C = kpex wire capacitance only, RC = Magic wire resistance + capacitance (the difference of the two is the cost of the wiring resistance). Bars are the change of the typical value in % relative to the schematic; red = above the flag threshold.

var | name | unit | schematic | post c | Δ% c | post rc | Δ% rc
I_IA | Current into the instrumentation amplifier (sink) | uA | 4.444 | 4.397 | -1.0576 | 4.396 | -1.0801
I_BUF | Current into the output buffer (sink) | uA | 1.481 | 1.466 | -1.0128 | 1.465 | -1.0804
I_G1 | Current into gain stage 1 (source) | uA | 1.08 | 1.08 | 0 | 1.08 | 0
I_G2 | Current into gain stage 2 (source) | uA | 1.08 | 1.08 | 0 | 1.08 | 0
R_IA | Ratio I_IA / ibias0 | A/A | 4.461 | 4.397 | -1.4347 | 4.396 | -1.4571
R_BUF | Ratio I_BUF / ibias0 | A/A | 1.487 | 1.466 | -1.4122 | 1.465 | -1.4795
R_G | Ratio I_G / ibias0 (mean of the two stages) | A/A | 1.096 | 1.08 | -1.4599 | 1.08 | -1.4599
ERR_G | Stage 1 / stage 2 current difference | % | 0 | 0 | | -0.181
PWR | Supply power of the block (with the loads) | uW | 11.391 | 11.037 | -3.1077 | 11.034 | -3.1341

## Provenance¶

{
 "cell": "central_bias",
 "schematic run": "/foss/designs/sg13cmos5l_spma_ip__instramp/runs/RUN_2026-11-05_21-13-38",
 "flow": {
  "generated": "2026-11-05T21:15:08",
  "commit": "a3285dc",
  "profile": "typ",
  "gds": {
   "path": "gds/central_bias/central_bias.gds",
   "sha1": "88df2e3b647e"
  },
  "schematic": {
   "path": "xschem/central_bias/central_bias.sch",
   "sha1": "3440a6dc3269"
  }
 },
 "post-layout run (c)": "/foss/designs/sg13cmos5l_spma_ip__instramp/runs/pex_cace/central_bias/RUN_2026-11-05_18-12-00",
 "post-layout run (rc)": "/foss/designs/sg13cmos5l_spma_ip__instramp/runs/pex_cace_rc/central_bias/RUN_2026-11-05_18-12-08"
}
