orpheus016/sg13cmos5l_spma_ip__instramp/docs/decoder_top_10b/report.html

# Decoder (decoder_top_10b)

LEGACY 10-bit decoder, replaced by gain_decoder_4b (not used by pgia_top); its DRC fails (19 items, e.g. FORB.Metal5) so it is not checked. Was digital (standard cells, librelane flow in xschem/decoder_top_10b/librelane); LVS and timing belong to that flow

## Flow stages

scripts/flow.sh, 2026-11-04T05:16:50, commit 0f10340, layout sha1 d3e6cf2b74d4, schematic sha1 None

Stage | Result | Time | Detail
drc | fail | 27 s | main : 19 items [fail];antenna : 0 items [ok];density : 6 items [info, chip-level];

## Layout and schematic

generated 2026-11-05T21:41:51 by scripts/build_chip_report.py
