orpheus016/sg13cmos5l_spma_ip__instramp/docs/ota_cmos5l/report.html

# Cell report¶

Interactive results of scripts/flow.sh <cell>: schematic CACE run (PVT and Monte Carlo), DRC / antenna / LVS, extraction and the schematic vs post-layout comparison (wire C only, and wire R + C). Generated by scripts/build_report.sh; the cell comes from the environment variable CELL (default ota_cmos5l). Every plot is interactive: hover for values, drag to zoom, double-click to reset, click a legend entry to hide it, use the drop-down to change the variable.

## ota_cmos5l¶

schematic run: runs/RUN_2026-11-05_17-23-53, flow run 2026-11-05T21:07:39 (commit a3285dc)

## Status¶

name | result | seconds | detail
cace | ✅ pass | 0 | reused RUN_2026-11-05_17-23-53: 43 rows, 0 failing
drc | ✅ pass | 19 | main : 0 items [ok];antenna : 0 items [ok];density : 6 items [info, chip-level];
audit | ✅ pass | 0 | all device Activ within the tie distance, every NWell tied; 11 p+/n+ abutment site(s), all in the accepted baseline;
lvs | ✅ pass | 8 | RESULT: MATCH
pex | ✅ pass | 5 | ota_cmos5l.c.spice: ports VSS IBIAS VDD VINN VINP VOUT; M=29, Rpoly=1, Rext=0, Cdev=9, Cext=48, D=0;ota_cmos5l.rc.spice: ports VSS IBIAS VDD VINN VINP VOUT; X=30, R=273, C=116, Cdev=9;
post_c | ✅ pass | 13 | 40 parameters with a % delta, 5 flagged
post_rc | ✅ pass | 18 | 40 parameters with a % delta, 21 flagged
images | ✅ pass | 1 | 0 updated, 5 unchanged, 0 error(s), 0 warning(s)

## Schematic and layout¶

Circuit only (SPICE code blocks removed), light colour scheme; pictures are regenerated by scripts/update_images.py. The schematic is a vector drawing: use the browser zoom (Ctrl +) or open it in a new tab to read small text.

### Schematic¶

Schematic parameters (.param, read from the schematic by scripts/update_images.py)

parameter | value
temp | 27
lbias | 0.15u
wbias | 0.15u
m6 | 1
m7 | 4
m8 | 8
linpair | 3u
winpair | 20u
lload | 5u
wload | 10u
lcs | 3u
wcs | 20u
Cc | 2p

### Layout¶

No description has been provided for this image

Physical size (bounding box of ota_cmos5l)

Width W [µm] | Length L [µm] | Area [µm²]
112.21 | 37.41 | 4197.80

## Specification table (schematic, over PVT)¶

parameter | variable | min_limit | min_value | typ_value | max_limit | max_value | pass
DC gain | A0 | 50 dB | 55.594 dB | 57.873 dB | any | 59.484 dB | ✅
-3 dB frequency | F3DB | any | 3075.780 Hz | 3697.540 Hz | any | 4351.160 Hz | ✅
Unity-gain frequency | UGF | 1000000.0 Hz | 2109530.000 Hz | 2699830.000 Hz | any | 3445080.000 Hz | ✅
Phase margin | PM | 50 ° | 55.635 ° | 60.647 ° | any | 66.901 ° | ✅
Gain margin | GM | any | 14.131 dB | 17.161 dB | any | 21.660 dB | ✅
Gain-bandwidth product (A0 x f3dB) | GBW | any | 2259320.000 Hz | 2861650.000 Hz | any | 3610750.000 Hz | ✅
Input noise @100 Hz | IRN_100 | any | 505.113 nV/rtHz | 610.251 nV/rtHz | any | 708.507 nV/rtHz | ✅
Input noise @1 kHz | IRN_1K | any | 163.111 nV/rtHz | 197.006 nV/rtHz | any | 228.600 nV/rtHz | ✅
Input noise @10 kHz | IRN_10K | any | 61.334 nV/rtHz | 74.134 nV/rtHz | any | 86.597 nV/rtHz | ✅
Input noise @1 MHz | IRN_1M | any | 45.977 nV/rtHz | 66.977 nV/rtHz | any | 98.969 nV/rtHz | ✅
Output noise @1 kHz | ORN_1K | any | 163.121 nV/rtHz | 197.268 nV/rtHz | any | 228.444 nV/rtHz | ✅
Integrated input noise | INOISE_TOT | any | 2675.580 uV-rms | 2863.530 uV-rms | any | 3030.460 uV-rms | ✅
Integrated output noise | ONOISE_TOT | any | 224.287 uV-rms | 290.224 uV-rms | any | 357.332 uV-rms | ✅
Input offset voltage | VOS | -1 mV | -0.553 mV | -0.213 mV | 1 mV | -0.046 mV | ✅
Quiescent current | IQ | any | 16.008 uA | 18.300 uA | any | 19.919 uA | ✅
Quiescent power | PWR | any | 19.209 uW | 24.705 uW | 50 uW | 29.878 uW | ✅
Output voltage | VOUT | any | 0.600 V | 0.600 V | any | 0.601 V | ✅
Gain error (1 - dVout/dVin) | GAIN_ERR | any | -0.218 % | 0.048 % | any | 0.084 % | ✅
Gain tempco (ppm per °C) | GAIN_TC | any | 0.480 ppm | 1.301 ppm | any | 2.043 ppm | ✅
Mean follower gain | G_MEAN | any | 0.999 V/V | 1.000 V/V | any | 1.002 V/V | ✅
CMRR @10 Hz | CMRR_DC | any | 53.977 dB | 64.868 dB | any | 84.357 dB | ✅
CMRR @100 kHz | CMRR_100K | any | 27.317 dB | 29.294 dB | any | 31.224 dB | ✅
CMRR @1 MHz | CMRR_1M | any | 6.976 dB | 9.152 dB | any | 11.236 dB | ✅
PSRR @10 Hz | PSRR_DC | any | 51.479 dB | 73.886 dB | any | 105.355 dB | ✅
PSRR @100 kHz | PSRR_100K | any | 51.349 dB | 62.907 dB | any | 66.926 dB | ✅
PSRR @1 MHz | PSRR_1M | any | 41.813 dB | 44.032 dB | any | 48.104 dB | ✅
Lower ICMR bound | ICMR_MIN | any | 0.060 V | 0.078 V | any | 0.096 V | ✅
Upper ICMR bound | ICMR_MAX | any | 0.991 V | 1.180 V | any | 1.369 V | ✅
ICMR span | ICMR_SPAN | any | 0.900 V | 1.103 V | any | 1.297 V | ✅
Delay (50 %) | T_DELAY | any | 50.698 ns | 67.558 ns | any | 86.179 ns | ✅
Rise time (10-90 %) | T_RISE | any | 65.799 ns | 79.484 ns | any | 94.454 ns | ✅
Overshoot | OVERSHOOT | any | 4.413 % | 9.871 % | any | 14.731 % | ✅
Settling time 1 % | TS_1PCT | any | 100.072 ns | 123.057 ns | any | 388.205 ns | ✅
Settling time 0.1 % | TS_01PCT | any | 102.145 ns | 365.746 ns | any | 455.678 ns | ✅
Positive slew rate | SR_POS | any | 314969.000 V/s | 1945800.000 V/s | any | 2239030.000 V/s | ✅
Negative slew rate | SR_NEG | any | 2151750.000 V/s | 2430550.000 V/s | any | 2678630.000 V/s | ✅
Rise time (10-90 %) | T_RISE | any | 214.378 ns | 246.686 ns | any | 1523.960 ns | ✅
Fall time (90-10 %) | T_FALL | any | 179.196 ns | 197.486 ns | any | 223.074 ns | ✅
Propagation delay tpLH | T_PLH | any | 153.223 ns | 182.425 ns | any | 208.091 ns | ✅
Propagation delay tpHL | T_PHL | any | 121.785 ns | 141.944 ns | any | 161.902 ns | ✅
Input offset voltage | VOS | any | -1.867 mV | -0.066 mV | any | 2.551 mV | ✅
CMRR @10 Hz | CMRR_DC | any | 48.051 dB | 63.006 dB | any | 108.395 dB | ✅
PSRR @10 Hz | PSRR_DC | any | 46.691 dB | 57.302 dB | any | 75.805 dB | ✅

## PVT explorer¶

Each marker is one CACE run (corner = colour, supply = marker shape). Dashed lines are the specification limits of the datasheet.

### Worst cases over PVT¶

variable | unit | min | min_at | max | max_at | spec_min | spec_max | violations
A0 | dB | 55.594 | ff, 1.2 V, 85 °C | 59.484 | ss, 1.5 V, -40 °C | 50 | any | 0/45
F3DB | Hz | 3075.8 | ss, 1.2 V, -40 °C | 4351.2 | ff, 1.5 V, 85 °C | any | any | 0/45
UGF | Hz | 2.1095e+06 | ss, 1.2 V, 85 °C | 3.4451e+06 | ff, 1.5 V, -40 °C | 1e+06 | any | 0/45
PM | ° | 55.635 | sf, 1.35 V, 85 °C | 66.901 | fs, 1.5 V, -40 °C | 50 | any | 0/45
GM | dB | 14.131 | sf, 1.2 V, 85 °C | 21.66 | fs, 1.5 V, -40 °C | any | any | 0/45
GBW | Hz | 2.2593e+06 | ss, 1.2 V, 85 °C | 3.6108e+06 | ff, 1.5 V, -40 °C | any | any | 0/45
IRN_100 | nV/rtHz | 505.11 | ff, 1.2 V, -40 °C | 708.51 | ss, 1.5 V, 85 °C | any | any | 0/45
IRN_1K | nV/rtHz | 163.11 | ff, 1.2 V, -40 °C | 228.6 | ss, 1.5 V, 85 °C | any | any | 0/45
IRN_10K | nV/rtHz | 61.334 | ff, 1.2 V, -40 °C | 86.597 | ss, 1.2 V, 85 °C | any | any | 0/45
IRN_1M | nV/rtHz | 45.977 | ff, 1.5 V, -40 °C | 98.969 | ss, 1.2 V, 85 °C | any | any | 0/45
ORN_1K | nV/rtHz | 163.12 | ff, 1.2 V, -40 °C | 228.44 | ss, 1.5 V, 85 °C | any | any | 0/45
INOISE_TOT | uV-rms | 2675.6 | ff, 1.2 V, -40 °C | 3030.5 | ss, 1.5 V, 27 °C | any | any | 0/45
ONOISE_TOT | uV-rms | 224.29 | ff, 1.2 V, -40 °C | 357.33 | ss, 1.2 V, 85 °C | any | any | 0/45
VOS | mV | -0.55306 | ss, 1.2 V, 85 °C | -0.046214 | ff, 1.5 V, -40 °C | -1 | 1 | 0/45
IQ | uA | 16.008 | ss, 1.2 V, -40 °C | 19.919 | ff, 1.5 V, 85 °C | any | any | 0/45
PWR | uW | 19.209 | ss, 1.2 V, -40 °C | 29.878 | ff, 1.5 V, 85 °C | any | 50 | 0/45
VOUT | V | 0.60005 | ff, 1.5 V, -40 °C | 0.60055 | ss, 1.2 V, 85 °C | any | any | 0/45
GAIN_ERR | % | -0.21815 | ss, 1.2 V, 27 °C | 0.083983 | ff, 1.5 V, 85 °C | any | any | 0/45
GAIN_TC | ppm | 0.48031 | ff, 1.2 V, 27 °C | 2.043 | ff, 1.5 V, 27 °C | any | any | 0/15
G_MEAN | V/V | 0.99931 | ff, 1.5 V, 27 °C | 1.0021 | ss, 1.2 V, 27 °C | any | any | 0/15
CMRR_DC | dB | 53.977 | ss, 1.2 V, 27 °C | 84.357 | ff, 1.2 V, -40 °C | any | any | 0/45
CMRR_100K | dB | 27.317 | ss, 1.2 V, 85 °C | 31.224 | ff, 1.5 V, -40 °C | any | any | 0/45
CMRR_1M | dB | 6.9764 | ss, 1.2 V, 85 °C | 11.236 | ff, 1.5 V, -40 °C | any | any | 0/45
PSRR_DC | dB | 51.479 | ss, 1.2 V, 27 °C | 105.36 | sf, 1.5 V, 27 °C | any | any | 0/45
PSRR_100K | dB | 51.349 | ss, 1.2 V, 27 °C | 66.926 | ff, 1.5 V, -40 °C | any | any | 0/45
PSRR_1M | dB | 41.813 | ss, 1.2 V, 85 °C | 48.104 | tt, 1.2 V, -40 °C | any | any | 0/45
ICMR_MIN | V | 0.060408 | fs, 1.2 V, -40 °C | 0.096157 | sf, 1.5 V, 85 °C | any | any | 0/45
ICMR_MAX | V | 0.99124 | fs, 1.2 V, 85 °C | 1.3691 | sf, 1.5 V, 27 °C | any | any | 0/45
ICMR_SPAN | V | 0.89983 | fs, 1.2 V, 85 °C | 1.2969 | sf, 1.5 V, -40 °C | any | any | 0/45
T_DELAY | ns | 50.698 | ff, 1.5 V, -40 °C | 86.179 | ss, 1.2 V, 85 °C | any | any | 0/45
T_RISE | ns | 65.799 | ff, 1.5 V, -40 °C | 1524 | ss, 1.2 V, -40 °C | any | any | 0/90
OVERSHOOT | % | 4.4132 | ss, 1.2 V, -40 °C | 14.731 | sf, 1.35 V, 85 °C | any | any | 0/45
TS_1PCT | ns | 100.07 | ff, 1.5 V, -40 °C | 388.2 | ff, 1.2 V, 85 °C | any | any | 0/45
TS_01PCT | ns | 102.14 | ff, 1.5 V, -40 °C | 455.68 | fs, 1.2 V, 85 °C | any | any | 0/45
SR_POS | V/s | 3.1497e+05 | ss, 1.2 V, -40 °C | 2.239e+06 | ff, 1.5 V, -40 °C | any | any | 0/45
SR_NEG | V/s | 2.1518e+06 | ss, 1.2 V, -40 °C | 2.6786e+06 | ff, 1.5 V, -40 °C | any | any | 0/45
T_FALL | ns | 179.2 | ff, 1.5 V, -40 °C | 223.07 | ss, 1.2 V, -40 °C | any | any | 0/45
T_PLH | ns | 153.22 | ff, 1.5 V, -40 °C | 208.09 | fs, 1.2 V, 85 °C | any | any | 0/45
T_PHL | ns | 121.78 | ff, 1.5 V, -40 °C | 161.9 | ss, 1.2 V, 85 °C | any | any | 0/45

## Monte Carlo (mismatch)¶

variable | corner | count | mean | std | min | max | mean-3σ | mean+3σ
CMRR_DC | ff | 150 | 75.372 | 10.02 | 58.88 | 108.39 | 45.312 | 105.43
CMRR_DC | fs | 150 | 59.455 | 6.6321 | 50.168 | 90.362 | 39.558 | 79.351
CMRR_DC | sf | 150 | 71.557 | 9.966 | 56.064 | 107.83 | 41.659 | 101.45
CMRR_DC | ss | 150 | 55.486 | 4.893 | 48.051 | 77.367 | 40.806 | 70.165
CMRR_DC | tt | 150 | 65.695 | 9.7009 | 52.883 | 104.58 | 36.592 | 94.798
PSRR_DC | ff | 150 | 62.988 | 4.5318 | 54.705 | 75.805 | 49.392 | 76.583
PSRR_DC | fs | 150 | 54.809 | 3.6097 | 48.493 | 67.093 | 43.98 | 65.638
PSRR_DC | sf | 150 | 60.821 | 4.1747 | 53.068 | 73.523 | 48.297 | 73.345
PSRR_DC | ss | 150 | 52.368 | 3.2992 | 46.691 | 64.032 | 42.471 | 62.266
PSRR_DC | tt | 150 | 57.794 | 3.9099 | 50.681 | 70.338 | 46.064 | 69.524
VOS | ff | 150 | -0.012505 | 0.82632 | -1.5276 | 2.5511 | -2.4915 | 2.4664
VOS | fs | 150 | -0.17376 | 0.79451 | -1.6886 | 2.208 | -2.5573 | 2.2098
VOS | sf | 150 | -0.17379 | 0.80142 | -1.6521 | 2.2876 | -2.578 | 2.2305
VOS | ss | 150 | -0.36245 | 0.77827 | -1.8667 | 1.9351 | -2.6973 | 1.9724
VOS | tt | 150 | -0.16639 | 0.79797 | -1.6622 | 2.2639 | -2.5603 | 2.2275

## Schematic vs post-layout¶

Two extractions of the same layout: C = kpex wire capacitance only, RC = Magic wire resistance + capacitance (the difference of the two is the cost of the wiring resistance). Bars are the change of the typical value in % relative to the schematic; red = above the flag threshold.

var | name | unit | schematic | post c | Δ% c | post rc | Δ% rc
A0 | DC gain | dB | 57.873 | 57.904 | 0.053566 | 57.779 | -0.16242
F3DB | -3 dB frequency | Hz | 3697.5 | 3742.9 | 1.2257 | 3407.7 | -7.8382
UGF | Unity-gain frequency | Hz | 2.6998e+06 | 2.7324e+06 | 1.2056 | 2.4836e+06 | -8.0083
PM | Phase margin | ° | 60.647 | 58.963 | -2.7767 | 61.601 | 1.573
GM | Gain margin | dB | 17.161 | 16.507 | -3.811 | 17.337 | 1.0256
GBW | Gain-bandwidth product (A0 x f3dB) | Hz | 2.8616e+06 | 2.9404e+06 | 2.7512 | 2.6387e+06 | -7.7903
IRN_100 | Input noise @100 Hz | nV/rtHz | 610.25 | 604.31 | -0.97403 | 606.73 | -0.57698
IRN_1K | Input noise @1 kHz | nV/rtHz | 197.01 | 195.07 | -0.98373 | 195.82 | -0.601
IRN_10K | Input noise @10 kHz | nV/rtHz | 74.134 | 73.211 | -1.245 | 73.465 | -0.90242
IRN_1M | Input noise @1 MHz | nV/rtHz | 66.977 | 66.043 | -1.3945 | 71.644 | 6.9681
ORN_1K | Output noise @1 kHz | nV/rtHz | 197.27 | 194.96 | -1.1705 | 195.71 | -0.79131
INOISE_TOT | Integrated input noise | uV-rms | 2863.5 | 2853.9 | -0.3363 | 3085.7 | 7.759
ONOISE_TOT | Integrated output noise | uV-rms | 290.22 | 291.58 | 0.46585 | 291.6 | 0.47481
VOS | Input offset voltage | mV | -0.213 | -0.73 | -242.72 | -0.803 | -277
IQ | Quiescent current | uA | 18.3 | 18.324 | 0.13115 | 18.323 | 0.12568
PWR | Quiescent power | uW | 24.705 | 24.737 | 0.12953 | 24.736 | 0.12548
VOUT | Output voltage | V | 0.6 | 0.601 | 0.16667 | 0.601 | 0.16667
GAIN_ERR | Gain error (1 - dVout/dVin) | % | 0.048 | 0.059 | 22.917 | 0.062 | 29.167
GAIN_TC | Gain tempco (ppm per °C) | ppm | 1.301 | 0.788 | -39.431 | 0.909 | -30.131
G_MEAN | Mean follower gain | V/V | 1 | 0.999 | -0.1 | 0.999 | -0.1
CMRR_DC | CMRR @10 Hz | dB | 64.868 | 65.094 | 0.3484 | 64.689 | -0.27594
CMRR_100K | CMRR @100 kHz | dB | 29.294 | 29.461 | 0.57008 | 28.516 | -2.6558
CMRR_1M | CMRR @1 MHz | dB | 9.152 | 9.28 | 1.3986 | 8.389 | -8.337
PSRR_DC | PSRR @10 Hz | dB | 73.886 | 76.33 | 3.3078 | 77.849 | 5.3637
PSRR_100K | PSRR @100 kHz | dB | 62.907 | 65.52 | 4.1538 | 64.364 | 2.3161
PSRR_1M | PSRR @1 MHz | dB | 44.032 | 44.966 | 2.1212 | 43.676 | -0.8085
ICMR_MIN | Lower ICMR bound | V | 0.078 | 0.078 | 0 | 0.079 | 1.2821
ICMR_MAX | Upper ICMR bound | V | 1.18 | 1.202 | 1.8644 | 1.202 | 1.8644
ICMR_SPAN | ICMR span | V | 1.103 | 1.124 | 1.9039 | 1.123 | 1.8132
T_DELAY | Delay (50 %) | ns | 67.558 | 67.732 | 0.25756 | 72.087 | 6.7039
T_RISE | Rise time (10-90 %) | ns | 79.484 | 77.17 | -2.9113 | 85.238 | 7.2392
OVERSHOOT | Overshoot | % | 9.871 | 12.253 | 24.131 | 9.302 | -5.7644
TS_1PCT | Settling time 1 % | ns | 123.06 | 118.09 | -4.0363 | 130.31 | 5.8908
TS_01PCT | Settling time 0.1 % | ns | 365.75 | 335.12 | -8.373 | 132.15 | -63.869
SR_POS | Positive slew rate | V/s | 1.9458e+06 | 1.9976e+06 | 2.6627 | 1.8414e+06 | -5.3649
SR_NEG | Negative slew rate | V/s | 2.4306e+06 | 2.4299e+06 | -0.025097 | 2.1827e+06 | -10.197
T_RISE#2 | Rise time (10-90 %) | ns | 246.69 | 240.29 | -2.5936 | 260.67 | 5.6687
T_FALL | Fall time (90-10 %) | ns | 197.49 | 197.54 | 0.025318 | 219.91 | 11.355
T_PLH | Propagation delay tpLH | ns | 182.43 | 182.57 | 0.082226 | 194.86 | 6.8165
T_PHL | Propagation delay tpHL | ns | 141.94 | 143.71 | 1.2434 | 155.89 | 9.8229

## Provenance¶

{
 "cell": "ota_cmos5l",
 "schematic run": "/foss/designs/sg13cmos5l_spma_ip__instramp/runs/RUN_2026-11-05_17-23-53",
 "flow": {
  "generated": "2026-11-05T21:07:39",
  "commit": "a3285dc",
  "profile": "typ",
  "gds": {
   "path": "gds/pgia_top/ota_cmos5l.gds",
   "sha1": "d27c68f60025"
  },
  "schematic": {
   "path": "xschem/ota_cmos5l/ota_cmos5l.sch",
   "sha1": "98f97e2e52a6"
  }
 },
 "post-layout run (c)": "/foss/designs/sg13cmos5l_spma_ip__instramp/runs/pex_cace/ota_cmos5l/RUN_2026-11-05_17-26-42",
 "post-layout run (rc)": "/foss/designs/sg13cmos5l_spma_ip__instramp/runs/pex_cace_rc/ota_cmos5l/RUN_2026-11-05_17-26-55"
}
