orpheus016/sg13cmos5l_spma_ip__instramp/docs/gain_network/report.html

# Cell report¶

Interactive results of scripts/flow.sh <cell>: schematic CACE run (PVT and Monte Carlo), DRC / antenna / LVS, extraction and the schematic vs post-layout comparison (wire C only, and wire R + C). Generated by scripts/build_report.sh; the cell comes from the environment variable CELL (default ota_cmos5l). Every plot is interactive: hover for values, drag to zoom, double-click to reset, click a legend entry to hide it, use the drop-down to change the variable.

## gain_network¶

schematic run: runs/RUN_2026-11-05_18-50-13, flow run 2026-11-05T18:52:07 (commit b495d99)

## Status¶

name | result | seconds | detail
cace | ❌ fail | 84 | /foss/designs/sg13cmos5l_spma_ip__instramp/runs/RUN_2026-11-05_18-50-13: 35 rows, 1 failing
drc | ✅ pass | 22 | main : 0 items [ok];antenna : 0 items [ok];density : 7 items [info, chip-level];
audit | ✅ pass | 0 | all device Activ within the tie distance, every NWell tied; no p+/n+ abutment outside standard cells;
lvs | ✅ pass | 8 | RESULT: MATCH
pex | ✅ pass | 22 | gain_network.c.spice: ports S4 S5 S0 S2 S1 S3 AVDD V_CM V_IN2 V_OUT2 I_BIAS AVSS; M=81, Rpoly=10, Rext=0, Cdev=5, Cext=350, D=1;gain_network.rc.spice: ports S4 S5 S0 S2 S1 S3 AVDD V_CM V_IN2 V_OUT2 I_
post_c | ✅ pass | 12 | 34 parameters with a % delta, 29 flagged
post_rc | ✅ pass | 22 | 34 parameters with a % delta, 32 flagged
images | ✅ pass | 1 | 0 updated, 5 unchanged, 0 error(s), 0 warning(s)
post | ⛔ blocked | 0 | pex stage: error

## Schematic and layout¶

Circuit only (SPICE code blocks removed), light colour scheme; pictures are regenerated by scripts/update_images.py. The schematic is a vector drawing: use the browser zoom (Ctrl +) or open it in a new tab to read small text.

### Schematic¶

### Layout¶

No description has been provided for this image

Physical size (bounding box of gain_network)

Width W [µm] | Length L [µm] | Area [µm²]
97.45 | 76.13 | 7418.90

## Specification table (schematic, over PVT)¶

parameter | variable | min_limit | min_value | typ_value | max_limit | max_value | pass
Closed-loop gain @1 kHz | A_CL | any | -4.204 dB | 15.967 dB | any | 30.684 dB | ✅
Gain error vs target | A_ERR | any | -32.114 dB | -0.041 dB | any | 7.307 dB | ✅
-3 dB bandwidth | F3DB | 20000 Hz | 257237.000 Hz | 1925845.000 Hz | any | 17383400.000 Hz | ✅
0 dB frequency | F0DB | any | 1938000.000 Hz | 10837550.000 Hz | any | 100000000.000 Hz | ✅
Phase @0 dB | PH0 | any | -180.000 ° | 56.944 ° | any | 161.600 ° | ✅
Output offset voltage | VOS | any | -330.326 mV | -2.304 mV | any | 476.591 mV | ✅
Virtual ground error | V_VG_ERR | any | -10.412 mV | -0.680 mV | any | 19.354 mV | ✅
Quiescent current | IQ | any | 60.534 uA | 73.836 uA | 150 uA | 87.544 uA | ✅
DC power dissipation | PWR | any | 65.376 uW | 88.599 uW | 200 uW | 131.315 uW | ✅
DC output voltage | VOUT | any | 0.270 V | 0.598 V | any | 1.077 V | ✅
Input noise @10 Hz | IRN_10 | any | 5575.600 nV/rtHz | 7108.350 nV/rtHz | any | 12510.000 nV/rtHz | ✅
Input noise @100 Hz | IRN_100 | any | 1763.990 nV/rtHz | 2248.865 nV/rtHz | any | 3957.830 nV/rtHz | ✅
Input noise @1 kHz | IRN_1K | any | 560.448 nV/rtHz | 714.317 nV/rtHz | 3500 nV/rtHz | 1257.340 nV/rtHz | ✅
Input noise @10 kHz | IRN_10K | any | 185.327 nV/rtHz | 235.850 nV/rtHz | any | 415.396 nV/rtHz | ✅
Output noise @1 kHz | ORN_1K | any | 973.814 nV/rtHz | 9513.945 nV/rtHz | any | 18907.700 nV/rtHz | ✅
Integrated output noise | ONOISE_TOT | any | 583.181 uV-rms | 1477.101 uV-rms | any | 2457.040 uV-rms | ✅
In-band input noise | INOISE_EQ | any | 73.532 uV-rms | 216.744 uV-rms | any | 752.975 uV-rms | ✅
Transient step gain | TR_GAIN | any | 0.77379 | 8.49047 | any | 32.896 | ✅
Percentage overshoot | OVERSHOOT | any | 0.000 % | 0.000 % | 20 % | 9.951 % | ✅
Settling time (0.1%) | SETTLING_TIME | any | 0.085 us | 0.750 us | 5.0 us | 2.769 us | ✅
Slew rate positive | SR_POS | 1.0e6 V/s | 3200000.000 V/s | 5670040.000 V/s | any | 10394700.000 V/s | ✅
Slew rate negative | SR_NEG | 1.0e6 V/s | 1625440.000 V/s | 4064210.000 V/s | any | 7598240.000 V/s | ✅
THD in dB | THD_DB | any | -55.325 dB | -46.288 dB | -20 dB | -22.210 dB | ✅
THD in % | THD_PCT | any | 0.171 % | 0.499 % | 10 % | 7.753 % | ✅
2nd harmonic | HD2_DB | any | -57.570 dB | -46.588 dB | any | -27.479 dB | ✅
3rd harmonic | HD3_DB | any | -78.020 dB | -62.654 dB | any | -24.493 dB | ✅
Fundamental output amplitude | VO1 | any | 0.155 V | 0.206 V | any | 0.282 V | ✅
PSRR @10 Hz | PSRR_DC | 25 dB | 30.646 dB | 32.952 dB | any | 37.880 dB | ✅
PSRR @100 kHz | PSRR_100K | 25 dB | 30.490 dB | 33.041 dB | any | 38.052 dB | ✅
PSRR @1 MHz | PSRR_1M | any | 23.905 dB | 33.977 dB | any | 41.554 dB | ✅
CMRR @10 Hz | CMRR_DC | 50 dB | 34.063 dB | 58.607 dB | any | 67.565 dB | ❌
CMRR @100 kHz | CMRR_100K | 25 dB | 33.019 dB | 40.514 dB | any | 44.170 dB | ✅
CMRR @1 MHz | CMRR_1M | any | 15.640 dB | 25.909 dB | any | 32.954 dB | ✅
Max glitch voltage deviation | V_GLITCH_MAX | any | 0.086 mV | 11.831 mV | 200 mV | 51.714 mV | ✅
Gain switching settling time | T_SWITCH_SETTLE | any | 0.001 us | 0.500 us | 3.0 us | 2.112 us | ✅

## PVT explorer¶

Each marker is one CACE run (corner = colour, supply = marker shape). Dashed lines are the specification limits of the datasheet.

### Worst cases over PVT¶

variable | unit | min | min_at | max | max_at | spec_min | spec_max | violations
A_CL | dB | -4.2038 | ff, 1.5 V, -40 °C | 30.684 | ss, 1.2 V, -40 °C | any | any | 0/270
A_ERR | dB | -32.114 | ss, 1.08 V, -40 °C | 7.307 | ss, 1.2 V, -40 °C | any | any | 0/270
F3DB | Hz | 2.5724e+05 | ss, 1.08 V, 27 °C | 1.7383e+07 | sf, 1.5 V, -40 °C | 20000 | any | 0/270
F0DB | Hz | 1.938e+06 | tt, 1.2 V, 27 °C | 1e+08 | sf, 1.2 V, 27 °C | any | any | 0/270
PH0 | ° | -180 | sf, 1.2 V, 27 °C | 161.6 | tt, 1.2 V, 27 °C | any | any | 0/270
VOS | mV | -330.33 | ff, 1.5 V, 85 °C | 476.59 | ss, 1.08 V, -40 °C | any | any | 0/270
V_VG_ERR | mV | -10.412 | ff, 1.5 V, 85 °C | 19.354 | ss, 1.08 V, -40 °C | any | any | 0/270
IQ | uA | 60.533 | ss, 1.08 V, -40 °C | 87.544 | ff, 1.5 V, -40 °C | any | 150 | 0/270
PWR | uW | 65.376 | ss, 1.08 V, -40 °C | 131.32 | ff, 1.5 V, -40 °C | any | 200 | 0/270
VOUT | V | 0.26967 | ff, 1.5 V, 85 °C | 1.0766 | ss, 1.08 V, -40 °C | any | any | 0/270
IRN_10 | nV/rtHz | 5575.6 | tt, 1.2 V, 27 °C | 12510 | ff, 1.2 V, 27 °C | any | any | 0/6
IRN_100 | nV/rtHz | 1764 | tt, 1.2 V, 27 °C | 3957.8 | ff, 1.2 V, 27 °C | any | any | 0/6
IRN_1K | nV/rtHz | 560.45 | tt, 1.2 V, 27 °C | 1257.3 | ff, 1.2 V, 27 °C | any | 3500 | 0/6
IRN_10K | nV/rtHz | 185.33 | tt, 1.2 V, 27 °C | 415.4 | ff, 1.2 V, 27 °C | any | any | 0/6
ORN_1K | nV/rtHz | 973.81 | ff, 1.2 V, 27 °C | 18908 | ss, 1.2 V, 27 °C | any | any | 0/6
ONOISE_TOT | uV-rms | 583.18 | ff, 1.2 V, 27 °C | 2457 | ss, 1.2 V, 27 °C | any | any | 0/6
INOISE_EQ | uV-rms | 73.532 | ss, 1.2 V, 27 °C | 752.98 | ff, 1.2 V, 27 °C | any | any | 0/6
TR_GAIN | | 0.77379 | ff, 1.2 V, 27 °C | 32.896 | ss, 1.2 V, 27 °C | any | any | 0/9
OVERSHOOT | % | 0 | tt, 1.2 V, 27 °C | 9.951 | ff, 1.2 V, 27 °C | any | 20 | 0/9
SETTLING_TIME | us | 0.084715 | ff, 1.2 V, 27 °C | 2.7691 | ss, 1.2 V, 27 °C | any | 5 | 0/9
SR_POS | V/s | 3.2e+06 | sf, 1.5 V, -40 °C | 1.0395e+07 | ss, 1.2 V, -40 °C | 1e+06 | any | 0/45
SR_NEG | V/s | 1.6254e+06 | ss, 1.08 V, -40 °C | 7.5982e+06 | tt, 1.2 V, -40 °C | 1e+06 | any | 0/45
THD_DB | dB | -55.325 | tt, 1.2 V, 27 °C | -22.21 | ss, 1.2 V, 27 °C | any | -20 | 0/18
THD_PCT | % | 0.17129 | tt, 1.2 V, 27 °C | 7.7533 | ss, 1.2 V, 27 °C | any | 10 | 0/18
HD2_DB | dB | -57.57 | tt, 1.2 V, 27 °C | -27.479 | ss, 1.2 V, 27 °C | any | any | 0/18
HD3_DB | dB | -78.02 | tt, 1.2 V, 27 °C | -24.493 | ss, 1.2 V, 27 °C | any | any | 0/18
VO1 | V | 0.15503 | ff, 1.2 V, 27 °C | 0.28198 | ss, 1.2 V, 27 °C | any | any | 0/18
PSRR_DC | dB | 30.646 | ff, 1.2 V, 27 °C | 37.88 | ff, 1.2 V, 27 °C | 25 | any | 0/6
PSRR_100K | dB | 30.49 | ff, 1.2 V, 27 °C | 38.052 | ff, 1.2 V, 27 °C | 25 | any | 0/6
PSRR_1M | dB | 23.905 | ff, 1.2 V, 27 °C | 41.554 | ff, 1.2 V, 27 °C | any | any | 0/6
CMRR_DC | dB | 34.063 | ss, 1.2 V, 27 °C | 67.565 | tt, 1.2 V, 27 °C | 50 | any | 1/6
CMRR_100K | dB | 33.019 | ss, 1.2 V, 27 °C | 44.17 | tt, 1.2 V, 27 °C | 25 | any | 0/6
CMRR_1M | dB | 15.64 | ff, 1.2 V, 27 °C | 32.954 | ss, 1.2 V, 27 °C | any | any | 0/6
V_GLITCH_MAX | mV | 0.0864 | sf, 1.2 V, -40 °C | 51.714 | ss, 1.08 V, -40 °C | any | 200 | 0/45
T_SWITCH_SETTLE | us | 0.000865 | fs, 1.2 V, 85 °C | 2.1124 | ss, 1.2 V, 27 °C | any | 3 | 0/45

## Monte Carlo (mismatch)¶

No Monte Carlo runs in this cell's datasheet.

## Schematic vs post-layout¶

Two extractions of the same layout: C = kpex wire capacitance only, RC = Magic wire resistance + capacitance (the difference of the two is the cost of the wiring resistance). Bars are the change of the typical value in % relative to the schematic; red = above the flag threshold.

var | name | unit | schematic | post c | Δ% c | post rc | Δ% rc
A_CL | Closed-loop gain @1 kHz | dB | 15.967 | 0.149 | -99.067 | 0.172 | -98.923
A_ERR | Gain error vs target | dB | -0.041 | 0.149 | 463.41 | 0.172 | 519.51
F3DB | -3 dB bandwidth | Hz | 1.9258e+06 | 1.6762e+06 | -12.962 | 8.9024e+06 | 362.26
F0DB | 0 dB frequency | Hz | 1.0838e+07 | 3.058e+05 | -97.178 | 2.0581e+06 | -81.01
PH0 | Phase @0 dB | ° | 56.944 | 169.42 | 197.53 | 157.95 | 177.38
VOS | Output offset voltage | mV | -2.304 | 0.023 | 101 | 0.172 | 107.47
V_VG_ERR | Virtual ground error | mV | -0.68 | 0 | 100 | 0 | 100
IQ | Quiescent current | uA | 73.836 | 74.436 | 0.81261 | 61.21 | -17.1
PWR | DC power dissipation | uW | 88.599 | 89.323 | 0.81716 | 73.452 | -17.096
VOUT | DC output voltage | V | 0.598 | 0.6 | 0.33445 | 0.6 | 0.33445
IRN_10 | Input noise @10 Hz | nV/rtHz | 7108.4 | 10719 | 50.792 | 10713 | 50.706
IRN_100 | Input noise @100 Hz | nV/rtHz | 2248.9 | 3391.1 | 50.793 | 3389.2 | 50.706
IRN_1K | Input noise @1 kHz | nV/rtHz | 714.32 | 1077.2 | 50.803 | 1076.6 | 50.717
IRN_10K | Input noise @10 kHz | nV/rtHz | 235.85 | 355.58 | 50.766 | 355.4 | 50.691
ORN_1K | Output noise @1 kHz | nV/rtHz | 9513.9 | 1095.8 | -88.482 | 1098.2 | -88.457
ONOISE_TOT | Integrated output noise | uV-rms | 1477.1 | 351.35 | -76.213 | 523.62 | -64.551
INOISE_EQ | In-band input noise | uV-rms | 216.74 | 345.39 | 59.356 | 513.33 | 136.84
TR_GAIN | Transient step gain | | 8.4905 | 1.0114 | -88.087 | 1.0158 | -88.036
OVERSHOOT | Percentage overshoot | % | 0 | 0 | | 18.311
SETTLING_TIME | Settling time (0.1%) | us | 0.75 | 0.674 | -10.133 | 0.096 | -87.2
SR_POS | Slew rate positive | V/s | 5.67e+06 | 1.401e+06 | -75.291 | 6.28e+06 | 10.758
SR_NEG | Slew rate negative | V/s | 4.0642e+06 | 1.3981e+06 | -65.6 | 5.7084e+06 | 40.455
THD_DB | THD in dB | dB | -46.288 | -29.94 | 35.318 | -29.945 | 35.307
THD_PCT | THD in % | % | 0.499 | 3.184 | 538.08 | 3.182 | 537.68
HD2_DB | 2nd harmonic | dB | -46.588 | -30.328 | 34.902 | -30.329 | 34.9
HD3_DB | 3rd harmonic | dB | -62.654 | -41.598 | 33.607 | -41.653 | 33.519
VO1 | Fundamental output amplitude | V | 0.206 | 0.199 | -3.3981 | 0.2 | -2.9126
PSRR_DC | PSRR @10 Hz | dB | 32.952 | 31.323 | -4.9436 | 31.298 | -5.0194
PSRR_100K | PSRR @100 kHz | dB | 33.041 | 26.565 | -19.6 | 31.128 | -5.7898
PSRR_1M | PSRR @1 MHz | dB | 33.977 | 9.706 | -71.434 | 24.058 | -29.193
CMRR_DC | CMRR @10 Hz | dB | 58.607 | 62.726 | 7.0282 | 64.582 | 10.195
CMRR_100K | CMRR @100 kHz | dB | 40.514 | 25.706 | -36.55 | 36.625 | -9.5992
CMRR_1M | CMRR @1 MHz | dB | 25.909 | 7.108 | -72.566 | 16.652 | -35.729
V_GLITCH_MAX | Max glitch voltage deviation | mV | 11.831 | 10.181 | -13.946 | 10.078 | -14.817
T_SWITCH_SETTLE | Gain switching settling time | us | 0.5 | 0.259 | -48.2 | 0.078 | -84.4

## Provenance¶

{
 "cell": "gain_network",
 "schematic run": "/foss/designs/sg13cmos5l_spma_ip__instramp/runs/RUN_2026-11-05_18-50-13",
 "flow": {
  "generated": "2026-11-05T18:52:07",
  "commit": "b495d99",
  "profile": "typ",
  "gds": {
   "path": "gds/gain_network/gain_network.gds",
   "sha1": "d67f3975e103"
  },
  "schematic": {
   "path": "xschem/gain_network/gain_network.sch",
   "sha1": "8376509a9bdc"
  }
 },
 "post-layout run (c)": "/foss/designs/sg13cmos5l_spma_ip__instramp/runs/pex_cace/gain_network/RUN_2026-11-05_17-36-49",
 "post-layout run (rc)": "/foss/designs/sg13cmos5l_spma_ip__instramp/runs/pex_cace_rc/gain_network/RUN_2026-11-05_17-37-04"
}
