orpheus016/sg13cmos5l_spma_ip__instramp/docs/output_buffer/report.html

# Buffer (output_buffer)

no CACE datasheet yet (python3 scripts/new_cell.py output_buffer)

## Flow stages

scripts/flow.sh, 2026-11-05T18:49:42, commit b495d99, layout sha1 07214218ff5f, schematic sha1 0847913f87c3

Stage | Result | Time | Detail
drc | pass | 19 s | main : 0 items [ok];antenna : 0 items [ok];density : 6 items [info, chip-level];
audit | pass | 0 s | all device Activ within the tie distance, every NWell tied; 11 p+/n+ abutment site(s), all in the accepted baseline;
lvs | pass | 5 s | RESULT: MATCH
images | pass | 0 s | 0 updated, 5 unchanged, 0 error(s), 0 warning(s)

## Latch-up / tap audit

scripts/tap_audit.py, limit 20 µm, 16 n-tie / 3 p-tie polygons, 15 p+ and 3 n+ device Activ polygons.

Clean: every device Activ within the tie distance, every NWell tied; 11 accepted abutted-tie site(s).

## Layout and schematic

generated 2026-11-05T19:06:03 by scripts/build_chip_report.py
