orpheus016/sg13cmos5l_spma_ip__instramp/docs/pgia_top/report.html

# Cell report¶

Interactive results of scripts/flow.sh <cell>: schematic CACE run (PVT and Monte Carlo), DRC / antenna / LVS, extraction and the schematic vs post-layout comparison (wire C only, and wire R + C). Generated by scripts/build_report.sh; the cell comes from the environment variable CELL (default ota_cmos5l). Every plot is interactive: hover for values, drag to zoom, double-click to reset, click a legend entry to hide it, use the drop-down to change the variable.

## pgia_top¶

schematic run: runs/RUN_2026-11-05_18-55-13, flow run 2026-11-05T19:03:14 (commit b495d99)

## Status¶

name | result | seconds | detail
cace | ✅ pass | 401 | /foss/designs/sg13cmos5l_spma_ip__instramp/runs/RUN_2026-11-05_18-55-13: 17 rows
drc | ✅ pass | 67 | main : 0 items [ok];antenna : 0 items [ok];density : 7 items [info, chip-level];
audit | ✅ pass | 0 | all device Activ within the tie distance, every NWell tied; 44 p+/n+ abutment site(s), all in the accepted baseline;
lvs | ✅ pass | 13 | RESULT: MATCH
pex | ✅ pass | 216 | pgia_top.c.spice: ports VINP VINN VCM gain_sel[0] gain_sel[1] gain_sel[2] gain_sel[3] VOUT AVDD VPWR IBIAS_IA AVSS VGND; M=686, Rpoly=30, Rext=0, Cdev=46, Cext=2445, D=2, floating=10;pgia_top.rc.spice
post_c | ❌ fail | 76 | 8 parameters with a % delta, 8 flagged; spec failed or errors
post_rc | ❌ fail | 436 | 8 parameters with a % delta, 8 flagged; spec failed or errors
images | ✅ pass | 1 | 0 updated, 5 unchanged, 0 error(s), 0 warning(s)
post | ⛔ blocked | 0 | pex stage: error

## Schematic and layout¶

Circuit only (SPICE code blocks removed), light colour scheme; pictures are regenerated by scripts/update_images.py. The schematic is a vector drawing: use the browser zoom (Ctrl +) or open it in a new tab to read small text.

### Schematic¶

Schematic parameters (.param, read from the schematic by scripts/update_images.py)

source | parameter | value
ota_cmos5l (x1, x2, x3) | temp | 27
ota_cmos5l (x1, x2, x3) | lbias | 0.15u
ota_cmos5l (x1, x2, x3) | wbias | 0.15u
ota_cmos5l (x1, x2, x3) | m6 | 1
ota_cmos5l (x1, x2, x3) | m7 | 4
ota_cmos5l (x1, x2, x3) | m8 | 8
ota_cmos5l (x1, x2, x3) | linpair | 3u
ota_cmos5l (x1, x2, x3) | winpair | 20u
ota_cmos5l (x1, x2, x3) | lload | 5u
ota_cmos5l (x1, x2, x3) | wload | 10u
ota_cmos5l (x1, x2, x3) | lcs | 3u
ota_cmos5l (x1, x2, x3) | wcs | 20u
ota_cmos5l (x1, x2, x3) | Cc | 2p

### Layout¶

No description has been provided for this image

Physical size (bounding box of pgia_top)

Width W [µm] | Length L [µm] | Area [µm²]
514.60 | 250.00 | 128650.00

## Specification table (schematic, over PVT)¶

parameter | variable | min_limit | min_value | typ_value | max_limit | max_value | pass
Closed-loop gain @1 kHz | A_CL | any | -157.273 dB | 26.910 dB | any | 77.375 dB | ✅
Gain step error vs target | A_ERR | any | -235.541 dB | -3.527 dB | any | 21.937 dB | ✅
-3 dB bandwidth | F3DB | 1000 Hz | 1421.280 Hz | 220131.000 Hz | any | 44479600.000 Hz | ✅
0 dB frequency | F0DB | any | 27614.500 Hz | 2838315.000 Hz | any | 10000000.000 Hz | ✅
Phase @1 kHz | PH_1K | any | -179.244 ° | -0.377 ° | any | 179.812 ° | ✅
Input pseudo-resistor | R_PSEUDO | 1 GOhm | 3.563 GOhm | 13.559 GOhm | any | 43.789 GOhm | ✅
Output offset voltage | VOS | any | 0.026 mV | 81.581 mV | any | 661.207 mV | ✅
IA output DC voltage | V_IA | any | 0.600 V | 0.603 V | any | 0.610 V | ✅
Stage 1 output DC voltage | V_ST1 | any | 0.273 V | 0.565 V | any | 0.916 V | ✅
Stage 2 output DC voltage | V_ST2 | any | 0.000 V | 0.634 V | any | 1.500 V | ✅
DC output voltage | VOUT | any | 0.012 V | 0.633 V | any | 1.261 V | ✅
Analog supply current | I_AVDD | any | 167.053 uA | 225.907 uA | 400 uA | 315.963 uA | ✅
Digital supply current | I_VPWR | any | 0.001 uA | 0.021 uA | 1.0 uA | 0.478 uA | ✅
Total quiescent current | IQ_TOT | any | 167.059 uA | 225.949 uA | 400 uA | 316.416 uA | ✅
Total DC power | PWR | any | 180.424 uW | 269.308 uW | 500 uW | 474.624 uW | ✅
Output peak-to-peak | VPP_OUT | any | 0.000 mV | 1.969 mV | any | 73.973 mV | ✅
Effective voltage gain | EFF_GAIN | any | 0.000 V/V | 49.237 V/V | any | 1849.330 V/V | ✅

## PVT explorer¶

Each marker is one CACE run (corner = colour, supply = marker shape). Dashed lines are the specification limits of the datasheet.

### Worst cases over PVT¶

variable | unit | min | min_at | max | max_at | spec_min | spec_max | violations
A_CL | dB | -157.27 | fs, 1.5 V, -40 °C | 77.375 | tt, 1.08 V, -40 °C | any | any | 0/540
A_ERR | dB | -235.54 | fs, 1.5 V, -40 °C | 21.937 | ss, 1.08 V, -40 °C | any | any | 0/540
F3DB | Hz | 1421.3 | fs, 1.08 V, -40 °C | 4.448e+07 | ss, 1.5 V, 85 °C | 1000 | any | 0/540
F0DB | Hz | 27614 | tt, 1.2 V, 85 °C | 1e+07 | ff, 1.2 V, -40 °C | any | any | 0/540
PH_1K | ° | -179.24 | ss, 1.5 V, 27 °C | 179.81 | sf, 1.2 V, -40 °C | any | any | 0/540
R_PSEUDO | GOhm | 3.5631 | ff, 1.08 V, 85 °C | 43.79 | ss, 1.5 V, -40 °C | 1 | any | 0/540
VOS | mV | 0.026149 | sf, 1.5 V, 27 °C | 661.21 | ff, 1.5 V, 85 °C | any | any | 0/495
V_IA | V | 0.6005 | ff, 1.5 V, -40 °C | 0.61 | ss, 1.08 V, 27 °C | any | any | 0/495
V_ST1 | V | 0.2733 | fs, 1.08 V, 85 °C | 0.91579 | ss, 1.08 V, -40 °C | any | any | 0/495
V_ST2 | V | 0.0001108 | ss, 1.5 V, -40 °C | 1.4997 | fs, 1.5 V, -40 °C | any | any | 0/495
VOUT | V | 0.011657 | ss, 1.08 V, -40 °C | 1.2612 | ff, 1.5 V, 85 °C | any | any | 0/495
I_AVDD | uA | 167.05 | fs, 1.08 V, -40 °C | 315.96 | ff, 1.5 V, 85 °C | any | 400 | 0/495
I_VPWR | uA | 0.0012409 | ss, 1.08 V, -40 °C | 0.47835 | ff, 1.5 V, 85 °C | any | 1 | 0/495
IQ_TOT | uA | 167.06 | fs, 1.08 V, -40 °C | 316.42 | ff, 1.5 V, 85 °C | any | 400 | 0/495
PWR | uW | 180.42 | fs, 1.08 V, -40 °C | 474.62 | ff, 1.5 V, 85 °C | any | 500 | 0/495
VPP_OUT | mV | 1.5429e-06 | tt, 1.2 V, 27 °C | 73.973 | tt, 1.2 V, 27 °C | any | any | 0/12
EFF_GAIN | V/V | 3.8572e-05 | tt, 1.2 V, 27 °C | 1849.3 | tt, 1.2 V, 27 °C | any | any | 0/12

## Monte Carlo (mismatch)¶

No Monte Carlo runs in this cell's datasheet.

## Schematic vs post-layout¶

Two extractions of the same layout: C = kpex wire capacitance only, RC = Magic wire resistance + capacitance (the difference of the two is the cost of the wiring resistance). Bars are the change of the typical value in % relative to the schematic; red = above the flag threshold.

var | name | unit | schematic | post c | Δ% c | post rc | Δ% rc
A_CL | Closed-loop gain @1 kHz | dB | 26.91 | 20.909 | -22.3 | 20.922 | -22.252
A_ERR | Gain step error vs target | dB | -3.527 | -2.409 | 31.698 | -2.437 | 30.904
F3DB | -3 dB bandwidth | Hz | 2.2013e+05 | 2.3135e+05 | 5.0983 | 1.9916e+05 | -9.5271
F0DB | 0 dB frequency | Hz | 2.8383e+06 | 2.501e+06 | -11.884 | 2.4202e+06 | -14.732
PH_1K | Phase @1 kHz | ° | -0.377 | -0.439 | -16.446 | -0.457 | -21.22
R_PSEUDO | Input pseudo-resistor | GOhm | 13.559 | 16.935 | 24.899 | 16.995 | 25.341
VPP_OUT | Output peak-to-peak | mV | 1.969 | 0.952 | -51.651 | 0.953 | -51.6
EFF_GAIN | Effective voltage gain | V/V | 49.237 | 23.799 | -51.664 | 23.813 | -51.636

## Provenance¶

{
 "cell": "pgia_top",
 "schematic run": "/foss/designs/sg13cmos5l_spma_ip__instramp/runs/RUN_2026-11-05_18-55-13",
 "flow": {
  "generated": "2026-11-05T19:03:14",
  "commit": "b495d99",
  "profile": "typ",
  "gds": {
   "path": "gds/pgia_top/pgia_top.gds",
   "sha1": "9f7959ad6ff0"
  },
  "schematic": {
   "path": "xschem/pgia_top/pgia_top.sch",
   "sha1": "15d9c1d818e3"
  }
 },
 "post-layout run (c)": "/foss/designs/sg13cmos5l_spma_ip__instramp/runs/pex_cace/pgia_top/RUN_2026-11-05_18-39-19",
 "post-layout run (rc)": "/foss/designs/sg13cmos5l_spma_ip__instramp/runs/pex_cace_rc/pgia_top/RUN_2026-11-05_18-40-35"
}
