orpheus016/sg13cmos5l_spma_ip__instramp/docs/slot9_wrapper/report.html

# slot9_wrapper (slot9_wrapper)

chip level harness (slot 9 frame) that instantiates pgia_top, density rules apply

## Flow stages

scripts/flow.sh, 2026-11-05T19:04:57, commit b495d99, layout sha1 c08e77fa6619, schematic sha1 3408a0a99211

Stage | Result | Time | Detail
drc | pass | 65 s | main : 0 items [ok];antenna : 0 items [ok];density : 7 items [info, chip-level];
audit | pass | 0 s | all device Activ within the tie distance, every NWell tied; 44 p+/n+ abutment site(s), all in the accepted baseline;
drc_harness | pass | 13 s | 0 violations
lvs | pass | 9 s | RESULT: MATCH
deliver | pass | 14 s | harness_trial.sh: OK (the harness finds, accepts, places and writes back slot_9.gds);
images | pass | 1 s | 0 updated, 4 unchanged, 0 error(s), 0 warning(s)

## Latch-up / tap audit

scripts/tap_audit.py, limit 20 µm, 140 n-tie / 93 p-tie polygons, 250 p+ and 216 n+ device Activ polygons.

Clean: every device Activ within the tie distance, every NWell tied; 44 accepted abutted-tie site(s).

## Harness deliverable

The Chipalooza harness clones this repository and reads gds/slot_9.gds (top cell slot_9): 4.01 MB, sha1 2fd1189d348a.

## Layout and schematic

## Contains

pgia_top

generated 2026-11-05T19:06:03 by scripts/build_chip_report.py
