orpheus016/sg13cmos5l_spma_ip__instramp/docs/instramp_cmos5l/report.html

# Cell report¶

Interactive results of scripts/flow.sh <cell>: schematic CACE run (PVT and Monte Carlo), DRC / antenna / LVS, extraction and the schematic vs post-layout comparison (wire C only, and wire R + C). Generated by scripts/build_report.sh; the cell comes from the environment variable CELL (default ota_cmos5l). Every plot is interactive: hover for values, drag to zoom, double-click to reset, click a legend entry to hide it, use the drop-down to change the variable.

## instramp_cmos5l¶

schematic run: runs/RUN_2026-10-15_18-01-47, flow run 2026-10-15T18:04:25 (commit 7cec125)

## Status¶

name | result | seconds | detail
cace | ✅ pass | 0 | reused RUN_2026-10-15_18-01-47: 31 rows, 0 failing
drc | ✅ pass | 40 | main : 0 items [ok];antenna : 0 items [ok];density : 6 items [info, chip-level];
lvs | ✅ pass | 13 | RESULT: MATCH
pex | ✅ pass | 12 | instramp_cmos5l.c.spice: ports VSS VDD IBIAS VINN VOUT VINP CM; M=87, Rpoly=9, Rext=0, Cdev=27, Cext=154;instramp_cmos5l.rc.spice: ports VSS VDD IBIAS VINN VOUT VINP CM; X=96, R=608, C=389, Cdev=27;
post_c | ✅ pass | 16 | 30 parameters with a % delta, 2 flagged
post_rc | ✅ pass | 15 | 30 parameters with a % delta, 5 flagged
images | ✅ pass | 1 | 0 updated, 5 unchanged, 0 error(s), 0 warning(s)

## Schematic and layout¶

Circuit only (SPICE code blocks removed), light colour scheme; pictures are regenerated by scripts/update_images.py. The schematic is a vector drawing: use the browser zoom (Ctrl +) or open it in a new tab to read small text.

### Schematic¶

Schematic parameters (.param, read from the schematic by scripts/update_images.py)

source | parameter | value
ota_cmos5l (x1, x2, x3) | temp | 27
ota_cmos5l (x1, x2, x3) | lbias | 0.15u
ota_cmos5l (x1, x2, x3) | wbias | 0.15u
ota_cmos5l (x1, x2, x3) | m6 | 1
ota_cmos5l (x1, x2, x3) | m7 | 4
ota_cmos5l (x1, x2, x3) | m8 | 8
ota_cmos5l (x1, x2, x3) | linpair | 3u
ota_cmos5l (x1, x2, x3) | winpair | 20u
ota_cmos5l (x1, x2, x3) | lload | 5u
ota_cmos5l (x1, x2, x3) | wload | 10u
ota_cmos5l (x1, x2, x3) | lcs | 3u
ota_cmos5l (x1, x2, x3) | wcs | 20u
ota_cmos5l (x1, x2, x3) | Cc | 2p

### Layout¶

No description has been provided for this image

Physical size (bounding box of instramp_cmos5l)

Width W [µm] | Length L [µm] | Area [µm²]
124.25 | 122.79 | 15256.70

## Specification table (schematic, over PVT)¶

parameter | variable | min_limit | min_value | typ_value | max_limit | max_value | pass
Closed-loop gain at 1 Hz | A_CL | any | 17.765 dB | 18.061 dB | any | 18.262 dB | ✅
Gain error vs 8 V/V | A_ERR | any | -0.297 dB | -0.000 dB | any | 0.200 dB | ✅
-3 dB bandwidth | F3DB | any | 208894.000 Hz | 279254.000 Hz | any | 361657.000 Hz | ✅
0 dB frequency | F0DB | any | 1506090.000 Hz | 1987590.000 Hz | any | 2539050.000 Hz | ✅
Closed-loop phase at 0 dB | PH0 | any | -143.186 ° | -139.829 ° | any | -134.184 ° | ✅
THD | THD_DB | any | -72.538 dB | -63.520 dB | any | -46.170 dB | ✅
THD | THD_PCT | any | 0.024 % | 0.067 % | any | 0.491 % | ✅
2nd harmonic | HD2_DB | any | -80.791 dB | -64.979 dB | any | -48.314 dB | ✅
3rd harmonic | HD3_DB | any | -76.241 dB | -69.230 dB | any | -50.352 dB | ✅
Output fundamental amplitude | VO1 | any | 0.192 V | 0.200 V | any | 0.204 V | ✅
Differential gain @10 Hz | ADM_DC | any | 17.735 dB | 18.039 dB | any | 18.241 dB | ✅
CMRR @10 Hz | CMRR_DC | any | 41.798 dB | 47.694 dB | any | 52.303 dB | ✅
CMRR @100 kHz | CMRR_100K | any | 38.520 dB | 44.356 dB | any | 49.510 dB | ✅
CMRR @1 MHz | CMRR_1M | any | 21.311 dB | 27.278 dB | any | 32.934 dB | ✅
Differential gain @10 Hz | ADM_DC | any | 17.735 dB | 18.039 dB | any | 18.241 dB | ✅
PSRR @10 Hz | PSRR_DC | any | 50.403 dB | 72.884 dB | any | 102.125 dB | ✅
PSRR @100 kHz | PSRR_100K | any | 50.344 dB | 62.056 dB | any | 66.067 dB | ✅
PSRR @1 MHz | PSRR_1M | any | 41.461 dB | 44.243 dB | any | 50.529 dB | ✅
Input noise @10 Hz | IRN_10 | any | 2859.500 nV/rtHz | 3453.580 nV/rtHz | any | 4016.520 nV/rtHz | ✅
Input noise @100 Hz | IRN_100 | any | 906.405 nV/rtHz | 1094.970 nV/rtHz | any | 1272.920 nV/rtHz | ✅
Input noise @1 kHz | IRN_1K | any | 293.349 nV/rtHz | 354.553 nV/rtHz | any | 411.250 nV/rtHz | ✅
Input noise @10 kHz | IRN_10K | any | 111.854 nV/rtHz | 134.681 nV/rtHz | any | 155.093 nV/rtHz | ✅
Output noise @1 kHz | ORN_1K | any | 2392.110 nV/rtHz | 2837.670 nV/rtHz | any | 3213.450 nV/rtHz | ✅
Integrated output noise | ONOISE_TOT | any | 482.778 uV-rms | 544.195 uV-rms | any | 593.505 uV-rms | ✅
In-band input-referred noise (Vn_out / gain) | INOISE_EQ | any | 59.204 uV-rms | 67.899 uV-rms | any | 75.955 uV-rms | ✅
Output offset (Vcm - Vout) | VOS | any | -4.870 mV | -1.933 mV | any | -0.436 mV | ✅
Output voltage | VOUT | any | 0.600 V | 0.602 V | any | 0.605 V | ✅
Quiescent current | IQ | any | 48.004 uA | 54.873 uA | any | 59.750 uA | ✅
Quiescent power | PWR | any | 57.605 uW | 74.078 uW | any | 89.625 uW | ✅
Small-signal gain (transient) | TR_GAIN | any | 7.73174 | 7.99991 | any | 8.18701 | ✅
Mean output level | TR_VOUT_AVG | any | 0.600 V | 0.602 V | any | 0.605 V | ✅

## PVT explorer¶

Each marker is one CACE run (corner = colour, supply = marker shape). Dashed lines are the specification limits of the datasheet.

### Worst cases over PVT¶

variable | unit | min | min_at | max | max_at | spec_min | spec_max | violations
A_CL | dB | 17.765 | ff, 1.2 V, 85 °C | 18.262 | ss, 1.2 V, -40 °C | None | None | 0/45
A_ERR | dB | -0.29672 | ff, 1.2 V, 85 °C | 0.20016 | ss, 1.2 V, -40 °C | None | None | 0/45
F3DB | Hz | 2.0889e+05 | ss, 1.2 V, 85 °C | 3.6166e+05 | ff, 1.5 V, -40 °C | None | None | 0/45
F0DB | Hz | 1.5061e+06 | ss, 1.2 V, 85 °C | 2.539e+06 | ff, 1.5 V, -40 °C | None | None | 0/45
PH0 | ° | -143.19 | ff, 1.5 V, 85 °C | -134.18 | ss, 1.2 V, -40 °C | None | None | 0/45
THD_DB | dB | -72.538 | ss, 1.2 V, -40 °C | -46.17 | ff, 1.2 V, 85 °C | None | None | 0/45
THD_PCT | % | 0.023609 | ss, 1.2 V, -40 °C | 0.49146 | ff, 1.2 V, 85 °C | None | None | 0/45
HD2_DB | dB | -80.791 | ss, 1.2 V, -40 °C | -48.314 | ff, 1.2 V, 85 °C | None | None | 0/45
HD3_DB | dB | -76.241 | ff, 1.5 V, -40 °C | -50.352 | ff, 1.2 V, 85 °C | None | None | 0/45
VO1 | V | 0.19164 | ff, 1.2 V, 85 °C | 0.20448 | ss, 1.2 V, -40 °C | None | None | 0/45
ADM_DC | dB | 17.735 | ff, 1.2 V, 85 °C | 18.241 | ss, 1.2 V, -40 °C | None | None | 0/90
CMRR_DC | dB | 41.798 | ss, 1.2 V, 85 °C | 52.303 | sf, 1.5 V, -40 °C | None | None | 0/45
CMRR_100K | dB | 38.52 | ss, 1.2 V, 85 °C | 49.51 | ff, 1.5 V, -40 °C | None | None | 0/45
CMRR_1M | dB | 21.311 | ss, 1.2 V, 85 °C | 32.934 | ff, 1.5 V, -40 °C | None | None | 0/45
PSRR_DC | dB | 50.403 | ss, 1.2 V, 27 °C | 102.12 | sf, 1.5 V, 27 °C | None | None | 0/45
PSRR_100K | dB | 50.344 | ss, 1.2 V, 27 °C | 66.067 | ff, 1.5 V, -40 °C | None | None | 0/45
PSRR_1M | dB | 41.461 | ss, 1.5 V, 85 °C | 50.529 | fs, 1.2 V, -40 °C | None | None | 0/45
IRN_10 | nV/rtHz | 2859.5 | ff, 1.2 V, -40 °C | 4016.5 | ss, 1.5 V, 85 °C | None | None | 0/45
IRN_100 | nV/rtHz | 906.4 | ff, 1.2 V, -40 °C | 1272.9 | ss, 1.5 V, 85 °C | None | None | 0/45
IRN_1K | nV/rtHz | 293.35 | ff, 1.2 V, -40 °C | 411.25 | ss, 1.5 V, 85 °C | None | None | 0/45
IRN_10K | nV/rtHz | 111.85 | ff, 1.2 V, -40 °C | 155.09 | ss, 1.35 V, 85 °C | None | None | 0/45
ORN_1K | nV/rtHz | 2392.1 | ff, 1.2 V, -40 °C | 3213.4 | ss, 1.5 V, 85 °C | None | None | 0/45
ONOISE_TOT | uV-rms | 482.78 | ff, 1.2 V, -40 °C | 593.5 | ss, 1.5 V, 85 °C | None | None | 0/45
INOISE_EQ | uV-rms | 59.204 | ff, 1.2 V, -40 °C | 75.955 | ss, 1.5 V, 85 °C | None | None | 0/45
VOS | mV | -4.87 | ss, 1.2 V, 85 °C | -0.43591 | ff, 1.5 V, -40 °C | None | None | 0/45
VOUT | V | 0.60044 | ff, 1.5 V, -40 °C | 0.60487 | ss, 1.2 V, 85 °C | None | None | 0/45
IQ | uA | 48.004 | ss, 1.2 V, -40 °C | 59.75 | ff, 1.5 V, 85 °C | None | None | 0/45
PWR | uW | 57.605 | ss, 1.2 V, -40 °C | 89.625 | ff, 1.5 V, 85 °C | None | None | 0/45
TR_GAIN | | 7.7317 | ff, 1.2 V, 85 °C | 8.187 | ss, 1.2 V, -40 °C | None | None | 0/45
TR_VOUT_AVG | V | 0.60044 | ff, 1.5 V, -40 °C | 0.60487 | ss, 1.2 V, 85 °C | None | None | 0/45

## Monte Carlo (mismatch)¶

No Monte Carlo runs in this cell's datasheet.

## Schematic vs post-layout¶

Two extractions of the same layout: C = kpex wire capacitance only, RC = Magic wire resistance + capacitance (the difference of the two is the cost of the wiring resistance). Bars are the change of the typical value in % relative to the schematic; red = above the flag threshold.

var | name | unit | schematic | post c | Δ% c | post rc | Δ% rc
A_CL | Closed-loop gain at 1 Hz | dB | 18.061 | 18.06 | -0.0055368 | 18.008 | -0.29345
A_ERR | Gain error vs 8 V/V | dB | -0 | -0.002 | | -0.054
F3DB | -3 dB bandwidth | Hz | 2.7925e+05 | 2.8482e+05 | 1.9935 | 2.8598e+05 | 2.4093
F0DB | 0 dB frequency | Hz | 1.9876e+06 | 2.0432e+06 | 2.8004 | 2.0387e+06 | 2.5715
PH0 | Closed-loop phase at 0 dB | ° | -139.83 | -142.71 | -2.0575 | -142.71 | -2.0604
THD_DB | THD | dB | -63.52 | -62.618 | 1.42 | -62.695 | 1.2988
THD_PCT | THD | % | 0.067 | 0.074 | 10.448 | 0.073 | 8.9552
HD2_DB | 2nd harmonic | dB | -64.979 | -63.677 | 2.0037 | -63.727 | 1.9268
HD3_DB | 3rd harmonic | dB | -69.23 | -69.281 | -0.073667 | -69.461 | -0.33367
VO1 | Output fundamental amplitude | V | 0.2 | 0.2 | 0 | 0.199 | -0.5
ADM_DC | Differential gain @10 Hz | dB | 18.039 | 18.044 | 0.027718 | 17.994 | -0.24946
CMRR_DC | CMRR @10 Hz | dB | 47.694 | 48.397 | 1.474 | 49.578 | 3.9502
CMRR_100K | CMRR @100 kHz | dB | 44.356 | 44.854 | 1.1227 | 45.465 | 2.5002
CMRR_1M | CMRR @1 MHz | dB | 27.278 | 27.391 | 0.41425 | 27.614 | 1.2318
ADM_DC#2 | Differential gain @10 Hz | dB | 18.039 | 18.044 | 0.027718 | 17.994 | -0.24946
PSRR_DC | PSRR @10 Hz | dB | 72.884 | 75.594 | 3.7182 | 76.708 | 5.2467
PSRR_100K | PSRR @100 kHz | dB | 62.056 | 64.595 | 4.0915 | 64.768 | 4.3702
PSRR_1M | PSRR @1 MHz | dB | 44.243 | 44.684 | 0.99677 | 44.703 | 1.0397
IRN_10 | Input noise @10 Hz | nV/rtHz | 3453.6 | 3423.4 | -0.87301 | 3414.2 | -1.1403
IRN_100 | Input noise @100 Hz | nV/rtHz | 1095 | 1085.1 | -0.90505 | 1082.2 | -1.1708
IRN_1K | Input noise @1 kHz | nV/rtHz | 354.55 | 350.86 | -1.0407 | 349.99 | -1.2881
IRN_10K | Input noise @10 kHz | nV/rtHz | 134.68 | 133.04 | -1.2155 | 132.87 | -1.3447
ORN_1K | Output noise @1 kHz | nV/rtHz | 2837.7 | 2806.4 | -1.1034 | 2782.6 | -1.941
ONOISE_TOT | Integrated output noise | uV-rms | 544.2 | 543.41 | -0.14425 | 541.57 | -0.482
INOISE_EQ | In-band input-referred noise (Vn_out / gain) | uV-rms | 67.899 | 67.939 | 0.058911 | 68.117 | 0.32107
VOS | Output offset (Vcm - Vout) | mV | -1.933 | -6.597 | -241.28 | -6.613 | -242.11
VOUT | Output voltage | V | 0.602 | 0.607 | 0.83056 | 0.607 | 0.83056
IQ | Quiescent current | uA | 54.873 | 54.93 | 0.10388 | 74.385 | 35.558
PWR | Quiescent power | uW | 74.078 | 74.155 | 0.10394 | 100.42 | 35.56
TR_GAIN | Small-signal gain (transient) | | 7.9999 | 7.9989 | -0.012125 | 7.9514 | -0.60613
TR_VOUT_AVG | Mean output level | V | 0.602 | 0.607 | 0.83056 | 0.607 | 0.83056

## Provenance¶

{
 "cell": "instramp_cmos5l",
 "schematic run": "/foss/designs/sg13cmos5l_spma_ip__instramp/runs/RUN_2026-10-15_18-01-47",
 "flow": {
  "generated": "2026-10-15T18:04:25",
  "commit": "7cec125",
  "profile": "typ",
  "gds": {
   "path": "gds/pgia_top/instramp_cmos5l.gds",
   "sha1": "50fa4fd017b1"
  },
  "schematic": {
   "path": "xschem/instramp_cmos5l/instramp_cmos5l.sch",
   "sha1": "a36a205bb1f7"
  }
 },
 "post-layout run (c)": "/foss/designs/sg13cmos5l_spma_ip__instramp/runs/pex_cace/instramp_cmos5l/RUN_2026-10-15_18-03-54",
 "post-layout run (rc)": "/foss/designs/sg13cmos5l_spma_ip__instramp/runs/pex_cace_rc/instramp_cmos5l/RUN_2026-10-15_18-04-10"
}
