orpheus016/sg13cmos5l_spma_ip__instramp/gds/pgia_top/README.md

# Layout

## Top-Level
<!-- AUTO:layout:pgia_top -->
pgia_top layout
<!-- /AUTO -->

### Physical Spec
<!-- AUTO:dims:pgia_top -->
```bash
W = 514.60um
L = 250.00um
```
<!-- /AUTO -->

### Post-Layout Metrics
- Insert metrics
  
## Cells

### Static Instrumentation Amplifier
<!-- AUTO:layout:instramp_cmos5l -->
instramp_cmos5l layout
<!-- /AUTO -->

Dimension:
<!-- AUTO:dims:instramp_cmos5l -->
```bash
W = 124.25um
L = 122.79um
```
<!-- /AUTO -->

### OTA_CMOS5L
<!-- AUTO:layout:ota_cmos5l -->
ota_cmos5l layout
<!-- /AUTO -->

Dimension:
<!-- AUTO:dims:ota_cmos5l -->
```bash
W = 112.21um
L = 37.41um
```
<!-- /AUTO -->

### Decoder
<!-- AUTO:layout:decoder_top_10b -->
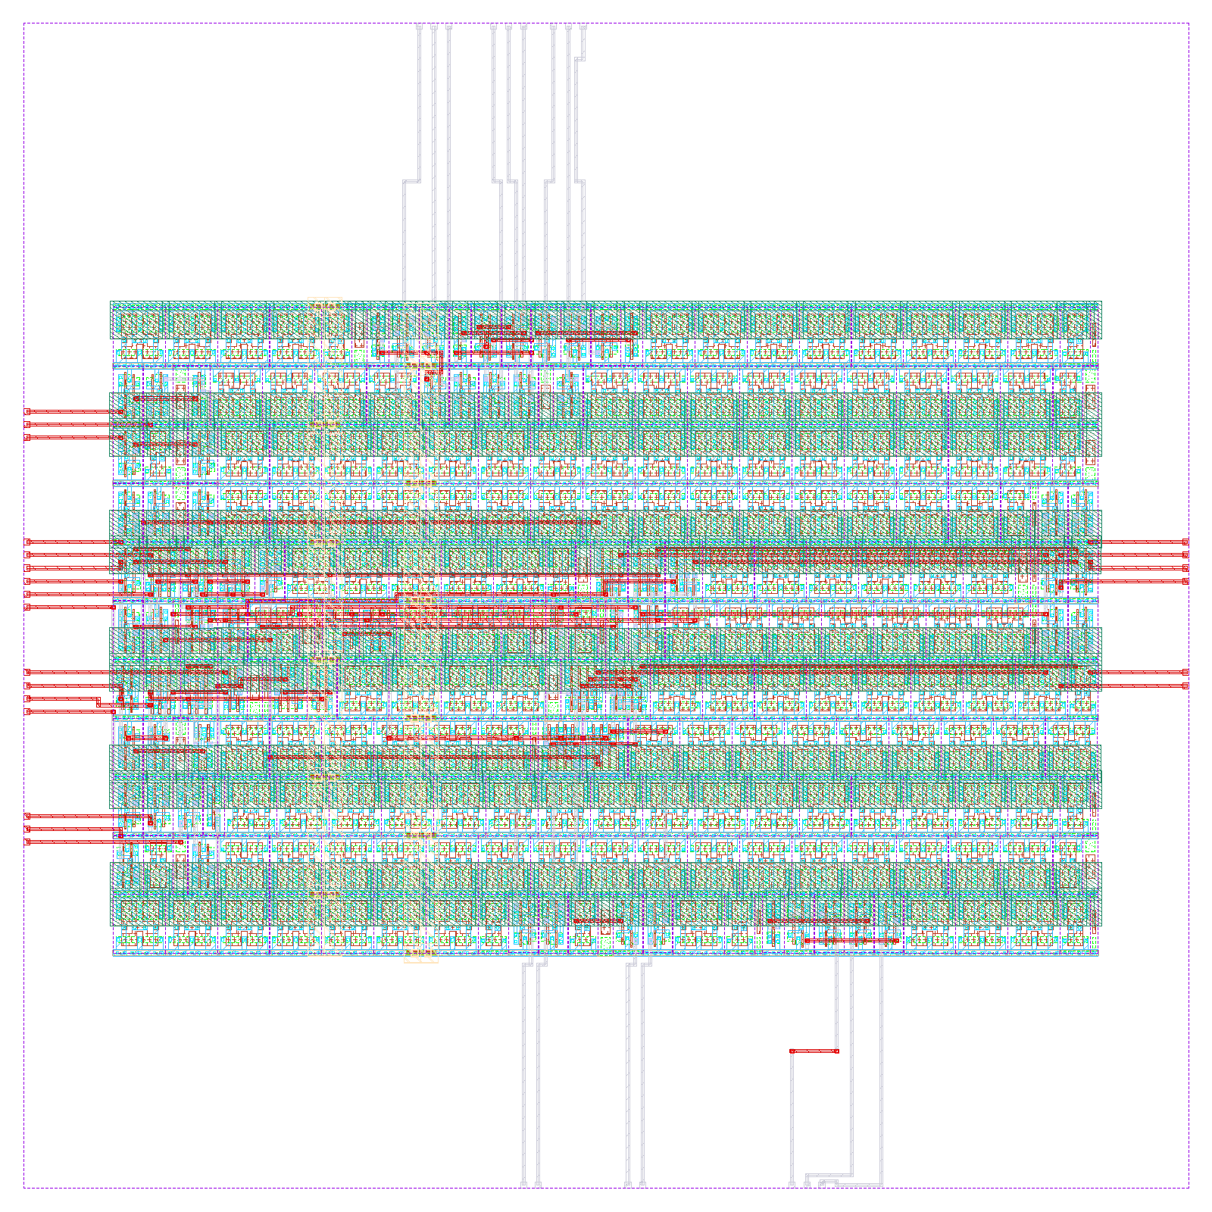
[picture p100: docs/decoder_top_10b/media/decoder_top_10b_layout.png]
decoder_top_10b layout

<!-- /AUTO -->

Dimension:
<!-- AUTO:dims:decoder_top_10b -->
```bash
W = 75.00um
L = 75.00um
```
<!-- /AUTO -->

### Buffer
<!-- AUTO:layout:output_buffer -->
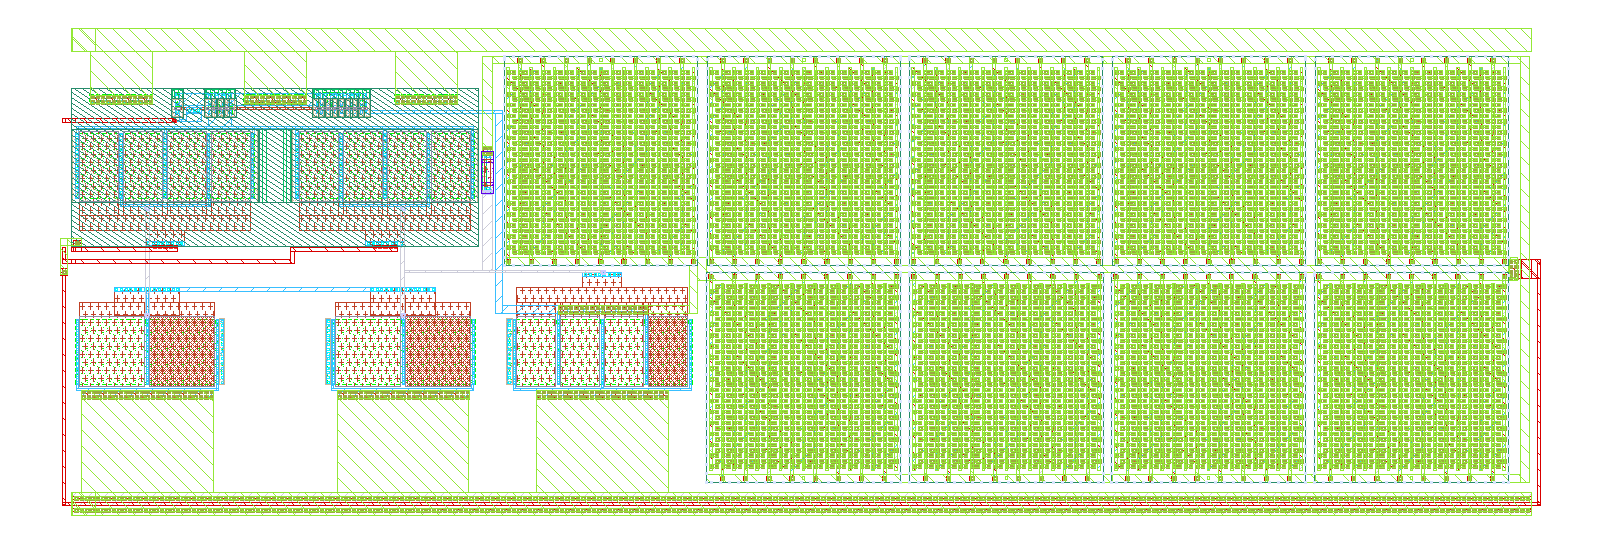
[picture p101: docs/output_buffer/media/output_buffer_layout.png]
output_buffer layout

<!-- /AUTO -->

Dimension:
<!-- AUTO:dims:output_buffer -->
```bash
W = 113.70um
L = 37.41um
```
<!-- /AUTO -->
