orpheus016/sg13cmos5l_spma_ip__instramp/docs/ota_cmos5l/cace/postlayout_rc.md

# Schematic vs post-layout

* schematic run: `/foss/designs/sg13cmos5l_spma_ip__instramp/runs/RUN_2026-10-21_09-59-13` (netlist source: schematic)
* post-layout run: `/foss/designs/sg13cmos5l_spma_ip__instramp/runs/pex_cace_rc/ota_cmos5l/RUN_2026-10-21_10-02-26` (netlist source: pex)
* flag threshold: 5 % on the typical value; units as in the CACE summary

| Parameter | Var | Unit | Schematic min / typ / max | Post-layout min / typ / max | Δ typ | Δ typ % | Status | Flag |
|---|---|---|---|---|---:|---:|---|---|
| DC gain | A0 | dB | 55.594 / 57.873 / 59.484 | 57.779 / 57.779 / 57.779 | -0.094 | -0.16 | Pass → Pass |  |
| -3 dB frequency | F3DB | Hz | 3075.8 / 3697.5 / 4351.2 | 3407.7 / 3407.7 / 3407.7 | -289.8 | -7.84 | Pass → Pass | Δ |
| Unity-gain frequency | UGF | Hz | 2.1095e+06 / 2.6998e+06 / 3.4451e+06 | 2.4836e+06 / 2.4836e+06 / 2.4836e+06 | -2.162e+05 | -8.01 | Pass → Pass | Δ |
| Phase margin | PM | ° | 55.635 / 60.647 / 66.901 | 61.601 / 61.601 / 61.601 | +0.954 | +1.57 | Pass → Pass |  |
| Gain margin | GM | dB | 14.131 / 17.161 / 21.66 | 17.337 / 17.337 / 17.337 | +0.176 | +1.03 | Pass → Pass |  |
| Gain-bandwidth product (A0 x f3dB) | GBW | Hz | 2.2593e+06 / 2.8616e+06 / 3.6108e+06 | 2.6387e+06 / 2.6387e+06 / 2.6387e+06 | -2.229e+05 | -7.79 | Pass → Pass | Δ |
| Input noise @100 Hz | IRN_100 | nV/rtHz | 505.11 / 610.25 / 708.51 | 606.73 / 606.73 / 606.73 | -3.521 | -0.58 | Pass → Pass |  |
| Input noise @1 kHz | IRN_1K | nV/rtHz | 163.11 / 197.01 / 228.6 | 195.82 / 195.82 / 195.82 | -1.184 | -0.60 | Pass → Pass |  |
| Input noise @10 kHz | IRN_10K | nV/rtHz | 61.334 / 74.134 / 86.597 | 73.465 / 73.465 / 73.465 | -0.669 | -0.90 | Pass → Pass |  |
| Input noise @1 MHz | IRN_1M | nV/rtHz | 45.977 / 66.977 / 98.969 | 71.644 / 71.644 / 71.644 | +4.667 | +6.97 | Pass → Pass | Δ |
| Output noise @1 kHz | ORN_1K | nV/rtHz | 163.12 / 197.27 / 228.44 | 195.71 / 195.71 / 195.71 | -1.561 | -0.79 | Pass → Pass |  |
| Integrated input noise | INOISE_TOT | uV-rms | 2675.6 / 2863.5 / 3030.5 | 3085.7 / 3085.7 / 3085.7 | +222.2 | +7.76 | Pass → Pass | Δ |
| Integrated output noise | ONOISE_TOT | uV-rms | 224.29 / 290.22 / 357.33 | 291.6 / 291.6 / 291.6 | +1.378 | +0.47 | Pass → Pass |  |
| Input offset voltage | VOS | mV | -0.553 / -0.213 / -0.046 | -0.803 / -0.803 / -0.803 | -0.59 | -277.00 | Pass → Pass | Δ |
| Quiescent current | IQ | uA | 16.008 / 18.3 / 19.919 | 18.323 / 18.323 / 18.323 | +0.023 | +0.13 | Pass → Pass |  |
| Quiescent power | PWR | uW | 19.209 / 24.705 / 29.878 | 24.736 / 24.736 / 24.736 | +0.031 | +0.13 | Pass → Pass |  |
| Output voltage | VOUT | V | 0.6 / 0.6 / 0.601 | 0.601 / 0.601 / 0.601 | +0.001 | +0.17 | Pass → Pass |  |
| Gain error (1 - dVout/dVin) | GAIN_ERR | % | -0.218 / 0.048 / 0.084 | 0.062 / 0.062 / 0.062 | +0.014 | +29.17 | Pass → Pass | Δ |
| Gain tempco (ppm per °C) | GAIN_TC | ppm | 0.48 / 1.301 / 2.043 | 0.909 / 0.909 / 0.909 | -0.392 | -30.13 | Pass → Pass | Δ |
| Mean follower gain | G_MEAN | V/V | 0.999 / 1 / 1.002 | 0.999 / 0.999 / 0.999 | -0.001 | -0.10 | Pass → Pass |  |
| CMRR @10 Hz | CMRR_DC | dB | 53.977 / 64.868 / 84.357 | 64.689 / 64.689 / 64.689 | -0.179 | -0.28 | Pass → Pass |  |
| CMRR @100 kHz | CMRR_100K | dB | 27.317 / 29.294 / 31.224 | 28.516 / 28.516 / 28.516 | -0.778 | -2.66 | Pass → Pass |  |
| CMRR @1 MHz | CMRR_1M | dB | 6.976 / 9.152 / 11.236 | 8.389 / 8.389 / 8.389 | -0.763 | -8.34 | Pass → Pass | Δ |
| PSRR @10 Hz | PSRR_DC | dB | 51.479 / 73.886 / 105.36 | 77.849 / 77.849 / 77.849 | +3.963 | +5.36 | Pass → Pass | Δ |
| PSRR @100 kHz | PSRR_100K | dB | 51.349 / 62.907 / 66.926 | 64.364 / 64.364 / 64.364 | +1.457 | +2.32 | Pass → Pass |  |
| PSRR @1 MHz | PSRR_1M | dB | 41.813 / 44.032 / 48.104 | 43.676 / 43.676 / 43.676 | -0.356 | -0.81 | Pass → Pass |  |
| Lower ICMR bound | ICMR_MIN | V | 0.06 / 0.078 / 0.096 | 0.079 / 0.079 / 0.079 | +0.001 | +1.28 | Pass → Pass |  |
| Upper ICMR bound | ICMR_MAX | V | 0.991 / 1.18 / 1.369 | 1.202 / 1.202 / 1.202 | +0.022 | +1.86 | Pass → Pass |  |
| ICMR span | ICMR_SPAN | V | 0.9 / 1.103 / 1.297 | 1.123 / 1.123 / 1.123 | +0.02 | +1.81 | Pass → Pass |  |
| Delay (50 %) | T_DELAY | ns | 50.698 / 67.558 / 86.179 | 72.087 / 72.087 / 72.087 | +4.529 | +6.70 | Pass → Pass | Δ |
| Rise time (10-90 %) | T_RISE | ns | 65.799 / 79.484 / 94.454 | 85.238 / 85.238 / 85.238 | +5.754 | +7.24 | Pass → Pass | Δ |
| Overshoot | OVERSHOOT | % | 4.413 / 9.871 / 14.731 | 9.302 / 9.302 / 9.302 | -0.569 | -5.76 | Pass → Pass | Δ |
| Settling time 1 % | TS_1PCT | ns | 100.07 / 123.06 / 388.2 | 130.31 / 130.31 / 130.31 | +7.249 | +5.89 | Pass → Pass | Δ |
| Settling time 0.1 % | TS_01PCT | ns | 102.14 / 365.75 / 455.68 | 132.15 / 132.15 / 132.15 | -233.6 | -63.87 | Pass → Pass | Δ |
| Positive slew rate | SR_POS | V/s | 3.1497e+05 / 1.9458e+06 / 2.239e+06 | 1.8414e+06 / 1.8414e+06 / 1.8414e+06 | -1.044e+05 | -5.36 | Pass → Pass | Δ |
| Negative slew rate | SR_NEG | V/s | 2.1518e+06 / 2.4306e+06 / 2.6786e+06 | 2.1827e+06 / 2.1827e+06 / 2.1827e+06 | -2.478e+05 | -10.20 | Pass → Pass | Δ |
| Rise time (10-90 %) | T_RISE#2 | ns | 214.38 / 246.69 / 1524 | 260.67 / 260.67 / 260.67 | +13.98 | +5.67 | Pass → Pass | Δ |
| Fall time (90-10 %) | T_FALL | ns | 179.2 / 197.49 / 223.07 | 219.91 / 219.91 / 219.91 | +22.43 | +11.36 | Pass → Pass | Δ |
| Propagation delay tpLH | T_PLH | ns | 153.22 / 182.43 / 208.09 | 194.86 / 194.86 / 194.86 | +12.44 | +6.82 | Pass → Pass | Δ |
| Propagation delay tpHL | T_PHL | ns | 121.78 / 141.94 / 161.9 | 155.89 / 155.89 / 155.89 | +13.94 | +9.82 | Pass → Pass | Δ |

21 row(s) flagged.

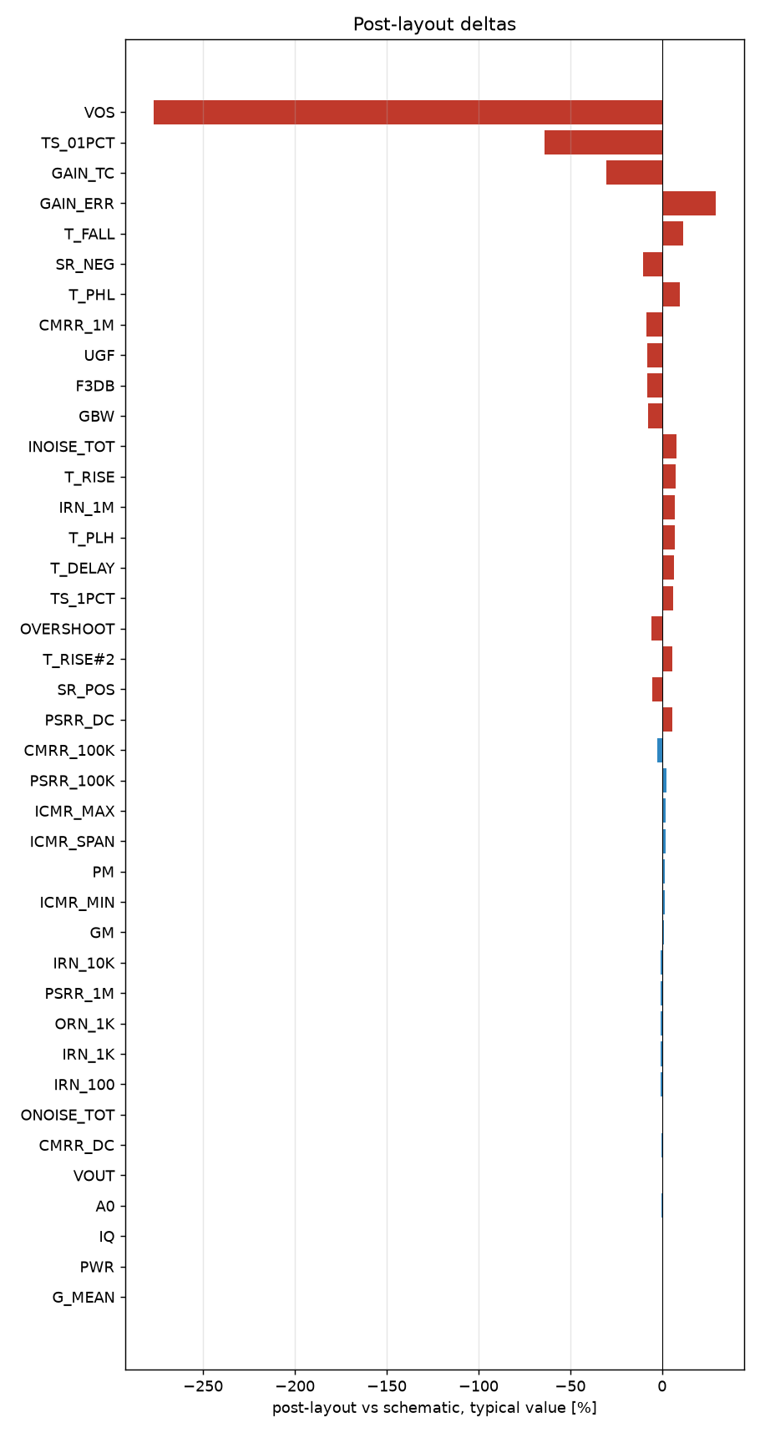
[picture p106: docs/ota_cmos5l/cace/postlayout_rc.png]
deltas
