orpheus016/sg13cmos5l_spma_ip__instramp/archives/ota_5t/README.md

# ota_5t

<!-- AUTO:schematic:ota_5t -->
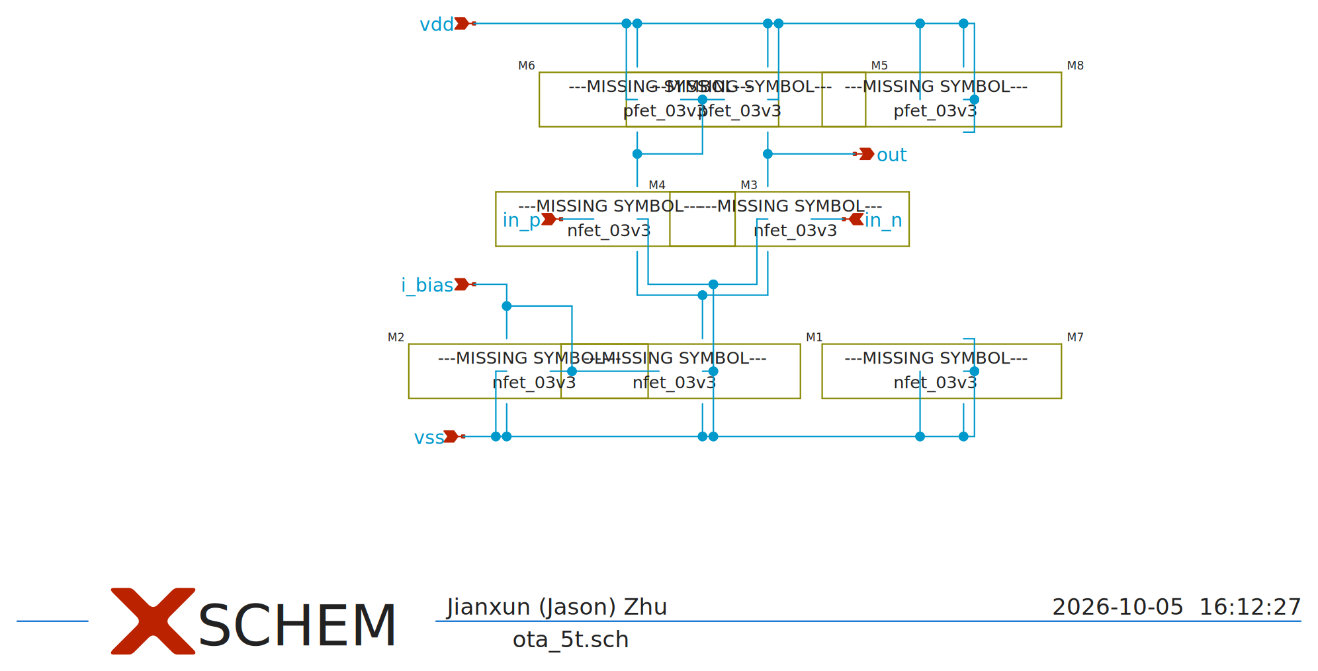
[picture p107: docs/ota_5t/media/ota_5t_schematic.png]
ota_5t schematic

<!-- /AUTO -->
