orpheus016/sg13cmos5l_spma_ip__instramp/designs/archives/inv/README.md

# inv

<!-- AUTO:schematic:inv -->
inv schematic
<!-- /AUTO -->
