orpheus016/sg13cmos5l_spma_ip__instramp/docs/central_bias/cace/postlayout_rc.png

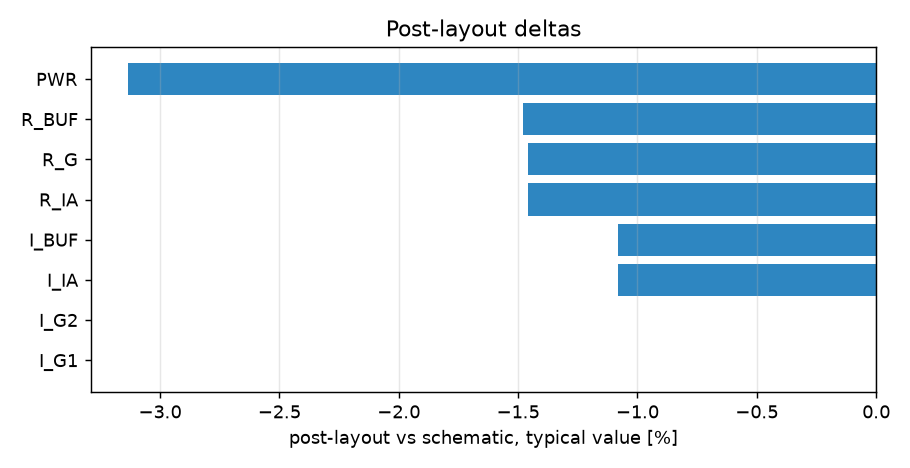
docs/central_bias/cace/postlayout_rc.png
