orpheus016/sg13cmos5l_spma_ip__instramp/docs/fine_driver_6b/media/fine_driver_6b_schematic.png

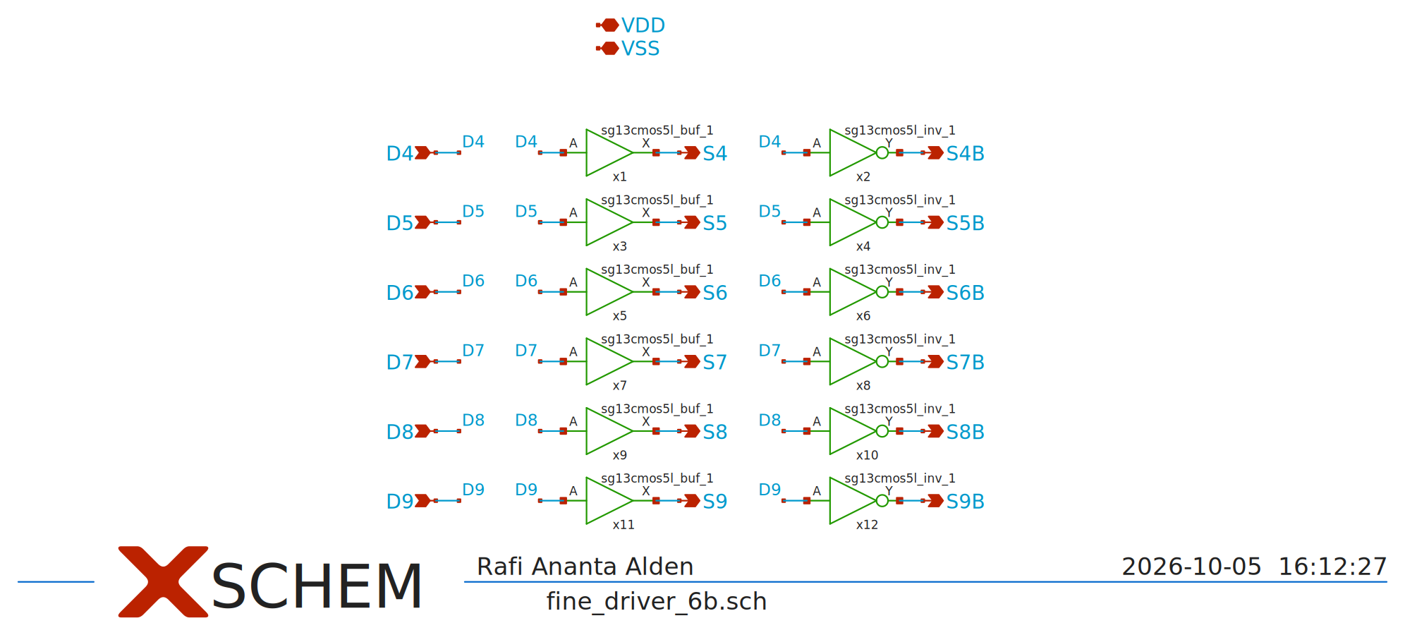
docs/fine_driver_6b/media/fine_driver_6b_schematic.png
