orpheus016/sg13cmos5l_spma_ip__instramp/docs/inv/media/inv_schematic.png

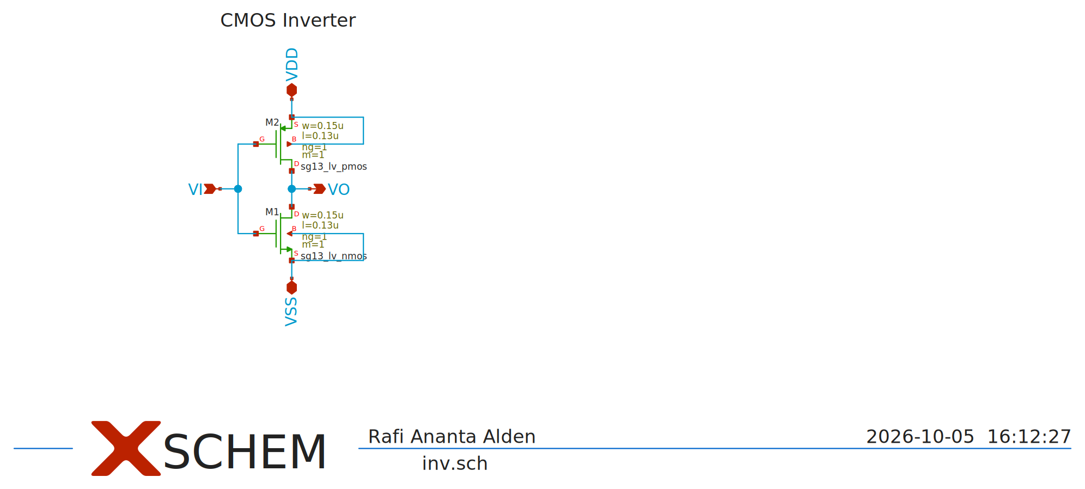
docs/inv/media/inv_schematic.png
