orpheus016/sg13cmos5l_spma_ip__instramp/docs/output_buffer/media/output_buffer_schematic.png

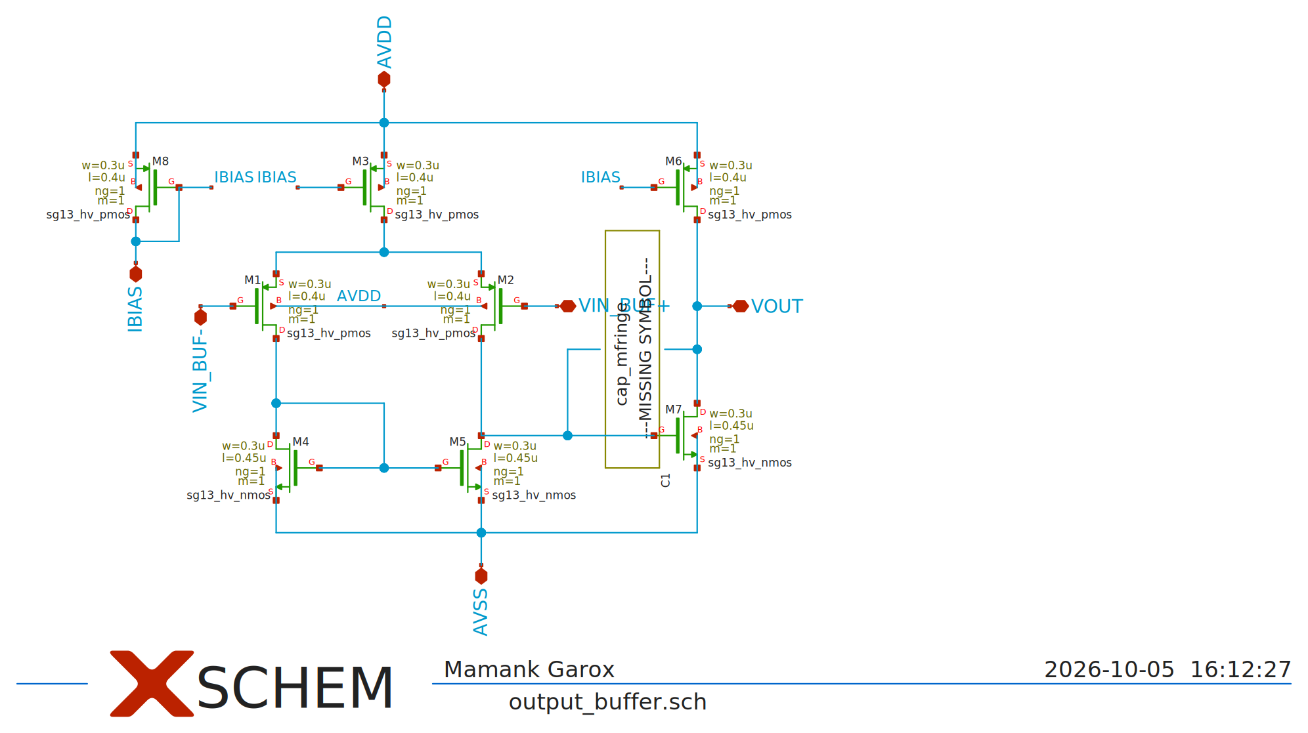
docs/output_buffer/media/output_buffer_schematic.png
