orpheus016/sg13cmos5l_spma_ip__instramp/docs/pgia_top/media/pgia_top_schematic.png

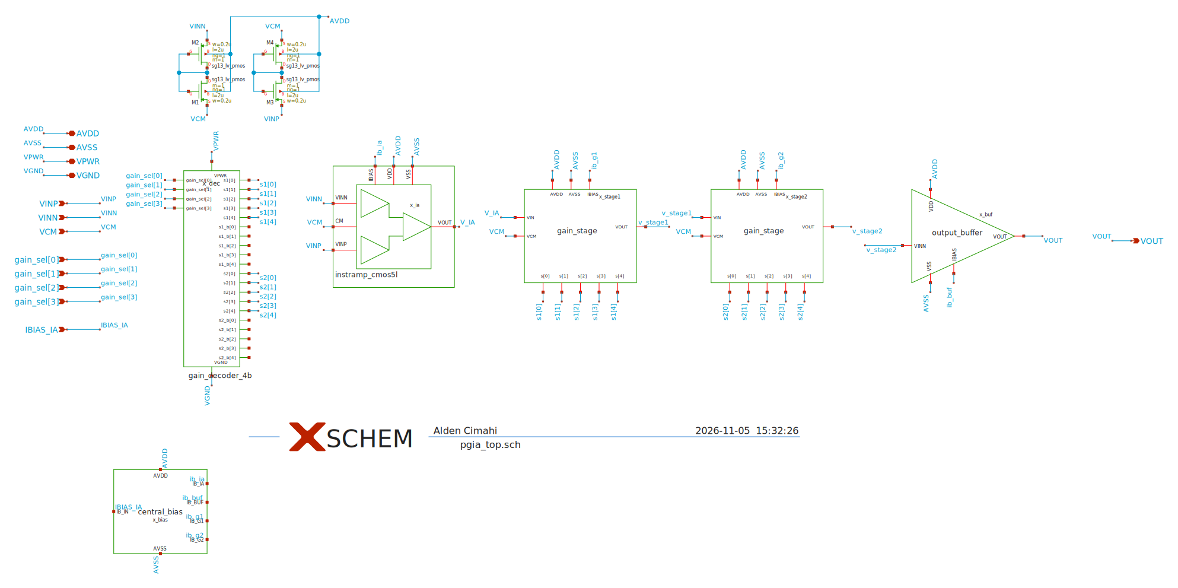
docs/pgia_top/media/pgia_top_schematic.png
