orpheus016/sg13cmos5l_spma_ip__instramp/docs/cace_ci/results_ota_cmos5l.md

# ota_cmos5l – CACE results

The results are generated, not hand-written: see **[docs/ota_cmos5l/cace/README.md](../ota_cmos5l/cace/README.md)**
(CACE results table, PVT worst-case conditions, Monte Carlo statistics + spread images).

Rebuild with `scripts/run_cace.sh ota_cmos5l` (≈ 6 min: PVT 3 × 5 × 3 + Monte Carlo 3 parameters × 5 corners × 3 temperatures × 50 seeds).
