orpheus016/sg13cmos5l_spma_ip__instramp/sim/biosignal/results/ecg_pex_c_null_c5.csv

t_s | vin_V | vout_V
0.00000 | -2.0773e-04 | 0.55279
0.00278 | -1.7773e-04 | 0.55967
0.00556 | -8.7726e-05 | 0.58000
0.00833 | 4.7274e-05 | 0.60970
0.01111 | 1.9227e-04 | 0.64060
0.01389 | 3.9227e-04 | 0.68160
0.01667 | 6.2727e-04 | 0.72733
0.01944 | 9.0727e-04 | 0.77870
0.02222 | 1.1373e-03 | 0.81883
0.02500 | 1.2723e-03 | 0.84168
0.02778 | 1.2473e-03 | 0.83752
0.03056 | 1.1023e-03 | 0.81285
0.03333 | 7.7227e-04 | 0.75437
0.03611 | 3.4727e-04 | 0.67259
0.03889 | 3.2274e-05 | 0.60649
0.04167 | -1.1773e-04 | 0.57330
0.04444 | -1.4273e-04 | 0.56763
0.04722 | -9.7726e-05 | 0.57777
0.05000 | -5.2726e-05 | 0.58779
0.05278 | -3.2726e-05 | 0.59222
0.05556 | -3.2726e-05 | 0.59222
0.05833 | -4.2726e-05 | 0.59001
0.06111 | -5.2726e-05 | 0.58780
0.06389 | -5.2726e-05 | 0.58780
0.06667 | -4.7726e-05 | 0.58891
0.06944 | -4.2726e-05 | 0.59001
0.07222 | -3.7726e-05 | 0.59112
0.07500 | -4.2726e-05 | 0.59001
0.07778 | -5.7726e-05 | 0.58669
0.08056 | -5.7726e-05 | 0.58669
0.08333 | -4.7726e-05 | 0.58890
0.08611 | -4.2726e-05 | 0.59001
0.08889 | -4.2726e-05 | 0.59001
0.09167 | -5.7726e-05 | 0.58669
0.09444 | -6.7726e-05 | 0.58447
0.09722 | -5.7726e-05 | 0.58669
0.10000 | -5.7726e-05 | 0.58669
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
