orpheus016/sg13cmos5l_spma_ip__instramp/sim/biosignal/results/ecg_pex_c_null_c6.csv

t_s | vin_V | vout_V
0.00000 | -2.0773e-04 | 0.49872
0.00278 | -1.7773e-04 | 0.51344
0.00556 | -8.7726e-05 | 0.55712
0.00833 | 4.7274e-05 | 0.62117
0.01111 | 1.9227e-04 | 0.68820
0.01389 | 3.9227e-04 | 0.77781
0.01667 | 6.2727e-04 | 0.87904
0.01944 | 9.0727e-04 | 0.98784
0.02222 | 1.1373e-03 | 0.98906
0.02500 | 1.2723e-03 | 0.98907
0.02778 | 1.2473e-03 | 0.98907
0.03056 | 1.1023e-03 | 0.98905
0.03333 | 7.7227e-04 | 0.93967
0.03611 | 3.4727e-04 | 0.75806
0.03889 | 3.2274e-05 | 0.61425
0.04167 | -1.1773e-04 | 0.54270
0.04444 | -1.4273e-04 | 0.53054
0.04722 | -9.7726e-05 | 0.55232
0.05000 | -5.2726e-05 | 0.57391
0.05278 | -3.2726e-05 | 0.58344
0.05556 | -3.2726e-05 | 0.58345
0.05833 | -4.2726e-05 | 0.57869
0.06111 | -5.2726e-05 | 0.57392
0.06389 | -5.2726e-05 | 0.57392
0.06667 | -4.7726e-05 | 0.57630
0.06944 | -4.2726e-05 | 0.57869
0.07222 | -3.7726e-05 | 0.58107
0.07500 | -4.2726e-05 | 0.57869
0.07778 | -5.7726e-05 | 0.57153
0.08056 | -5.7726e-05 | 0.57153
0.08333 | -4.7726e-05 | 0.57630
0.08611 | -4.2726e-05 | 0.57869
0.08889 | -4.2726e-05 | 0.57869
0.09167 | -5.7726e-05 | 0.57153
0.09444 | -6.7726e-05 | 0.56675
0.09722 | -5.7726e-05 | 0.57153
0.10000 | -5.7726e-05 | 0.57153
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
