orpheus016/sg13cmos5l_spma_ip__instramp/sim/biosignal/results/eeg_pex_c_null_c8.csv

t_s | vin_V | vout_V
0.00000 | -7.4483e-05 | 0.46010
0.00625 | -8.2483e-05 | 0.44538
0.01250 | -6.6483e-05 | 0.47481
0.01875 | -2.5483e-05 | 0.55012
0.02500 | 1.7517e-05 | 0.62890
0.03125 | 5.5517e-05 | 0.69843
0.03750 | 7.3517e-05 | 0.73139
0.04375 | 6.6517e-05 | 0.71858
0.05000 | 7.2517e-05 | 0.72956
0.05625 | 7.9517e-05 | 0.74238
0.06250 | 5.9517e-05 | 0.70578
0.06875 | 3.0517e-05 | 0.65272
0.07500 | -4.4828e-06 | 0.58865
0.08125 | -3.9483e-05 | 0.52445
0.08750 | -4.7483e-05 | 0.50975
0.09375 | -2.6483e-05 | 0.54829
0.10000 | 1.5172e-06 | 0.59961
0.10625 | 2.3517e-05 | 0.63989
0.11250 | 2.2517e-05 | 0.63807
0.11875 | 2.2517e-05 | 0.63807
0.12500 | 2.9517e-05 | 0.65088
0.13125 | 1.8517e-05 | 0.63075
0.13750 | -1.4483e-05 | 0.57032
0.14375 | -2.9483e-05 | 0.54280
0.15000 | -8.4828e-06 | 0.58129
0.15625 | 1.0517e-05 | 0.61610
0.16250 | 7.5172e-06 | 0.61061
0.16875 | -4.4828e-06 | 0.58864
0.17500 | -1.4483e-05 | 0.57031
0.18125 | -5.2483e-05 | 0.50057
0.18750 | -9.3483e-05 | 0.42513
0.19375 | -9.8483e-05 | 0.41590
0.20000 | -8.4483e-05 | 0.44169
0.20625 | -6.1483e-05 | 0.48401
0.21250 | -4.8483e-05 | 0.50790
0.21875 | -3.9483e-05 | 0.52443
0.22500 | -1.3483e-05 | 0.57213
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
