orpheus016/sg13cmos5l_spma_ip__instramp/sim/biosignal/results/eeg_pex_rc_null_c8.csv

t_s | vin_V | vout_V
0.00000 | -7.4483e-05 | 0.46447
0.00625 | -8.2483e-05 | 0.44988
0.01250 | -6.6483e-05 | 0.47904
0.01875 | -2.5483e-05 | 0.55366
0.02500 | 1.7517e-05 | 0.63173
0.03125 | 5.5517e-05 | 0.70063
0.03750 | 7.3517e-05 | 0.73329
0.04375 | 6.6517e-05 | 0.72060
0.05000 | 7.2517e-05 | 0.73148
0.05625 | 7.9517e-05 | 0.74418
0.06250 | 5.9517e-05 | 0.70791
0.06875 | 3.0517e-05 | 0.65533
0.07500 | -4.4828e-06 | 0.59184
0.08125 | -3.9483e-05 | 0.52823
0.08750 | -4.7483e-05 | 0.51366
0.09375 | -2.6483e-05 | 0.55185
0.10000 | 1.5172e-06 | 0.60270
0.10625 | 2.3517e-05 | 0.64262
0.11250 | 2.2517e-05 | 0.64081
0.11875 | 2.2517e-05 | 0.64082
0.12500 | 2.9517e-05 | 0.65350
0.13125 | 1.8517e-05 | 0.63356
0.13750 | -1.4483e-05 | 0.57368
0.14375 | -2.9483e-05 | 0.54641
0.15000 | -8.4828e-06 | 0.58455
0.15625 | 1.0517e-05 | 0.61904
0.16250 | 7.5172e-06 | 0.61361
0.16875 | -4.4828e-06 | 0.59183
0.17500 | -1.4483e-05 | 0.57367
0.18125 | -5.2483e-05 | 0.50457
0.18750 | -9.3483e-05 | 0.42982
0.19375 | -9.8483e-05 | 0.42067
0.20000 | -8.4483e-05 | 0.44622
0.20625 | -6.1483e-05 | 0.48815
0.21250 | -4.8483e-05 | 0.51183
0.21875 | -3.9483e-05 | 0.52821
0.22500 | -1.3483e-05 | 0.57547
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
