orpheus016/sg13cmos5l_spma_ip__instramp/sim/biosignal/results/emg_pex_c_null_c5.csv

t_s | vin_V | vout_V
0.00000 | 6.6920e-05 | 0.61399
0.00025 | 7.1920e-05 | 0.61506
0.00050 | 7.1920e-05 | 0.61506
0.00075 | 8.3620e-05 | 0.61755
0.00100 | 8.3620e-05 | 0.61756
0.00125 | 9.1920e-05 | 0.61935
0.00150 | 9.1920e-05 | 0.61936
0.00175 | 9.8620e-05 | 0.62077
0.00200 | 9.6920e-05 | 0.62043
0.00225 | 1.0362e-04 | 0.62184
0.00250 | 1.0692e-04 | 0.62257
0.00275 | 1.0192e-04 | 0.62151
0.00300 | 9.1920e-05 | 0.61937
0.00325 | 1.0192e-04 | 0.62149
0.00350 | 8.3620e-05 | 0.61758
0.00375 | 8.3620e-05 | 0.61756
0.00400 | 6.3620e-05 | 0.61328
0.00425 | 6.1920e-05 | 0.61291
0.00450 | 5.3620e-05 | 0.61110
0.00475 | 5.3620e-05 | 0.61109
0.00500 | 1.6920e-05 | 0.60319
0.00525 | 1.3620e-05 | 0.60241
0.00550 | -1.8080e-05 | 0.59552
0.00575 | 1.3620e-05 | 0.60237
0.00600 | 1.7022e-04 | 0.63581
0.00625 | 1.7862e-04 | 0.63775
0.00650 | 3.6522e-04 | 0.67599
0.00675 | 3.7022e-04 | 0.67719
0.00700 | 4.6522e-04 | 0.69600
0.00725 | 4.6862e-04 | 0.69676
0.00750 | 3.2192e-04 | 0.66759
0.00775 | 3.2192e-04 | 0.66744
0.00800 | 4.7692e-04 | 0.69826
0.00825 | 4.2022e-04 | 0.68726
0.00850 | 3.6522e-04 | 0.67625
0.00875 | 3.8862e-04 | 0.68087
0.00900 | 4.1192e-04 | 0.68554
0.00925 | 4.0862e-04 | 0.68489
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
