orpheus016/sg13cmos5l_spma_ip__instramp/sim/biosignal/results/emg_pex_c_null_c6.csv

t_s | vin_V | vout_V
0.00000 | 6.6920e-05 | 0.63046
0.00025 | 7.1920e-05 | 0.63278
0.00050 | 7.1920e-05 | 0.63279
0.00075 | 8.3620e-05 | 0.63816
0.00100 | 8.3620e-05 | 0.63819
0.00125 | 9.1920e-05 | 0.64208
0.00150 | 9.1920e-05 | 0.64210
0.00175 | 9.8620e-05 | 0.64514
0.00200 | 9.6920e-05 | 0.64442
0.00225 | 1.0362e-04 | 0.64746
0.00250 | 1.0692e-04 | 0.64905
0.00275 | 1.0192e-04 | 0.64675
0.00300 | 9.1920e-05 | 0.64212
0.00325 | 1.0192e-04 | 0.64671
0.00350 | 8.3620e-05 | 0.63824
0.00375 | 8.3620e-05 | 0.63819
0.00400 | 6.3620e-05 | 0.62892
0.00425 | 6.1920e-05 | 0.62813
0.00450 | 5.3620e-05 | 0.62422
0.00475 | 5.3620e-05 | 0.62420
0.00500 | 1.6920e-05 | 0.60711
0.00525 | 1.3620e-05 | 0.60543
0.00550 | -1.8080e-05 | 0.59056
0.00575 | 1.3620e-05 | 0.60534
0.00600 | 1.7022e-04 | 0.67779
0.00625 | 1.7862e-04 | 0.68199
0.00650 | 3.6522e-04 | 0.76550
0.00675 | 3.7022e-04 | 0.76814
0.00700 | 4.6522e-04 | 0.80953
0.00725 | 4.6862e-04 | 0.81122
0.00750 | 3.2192e-04 | 0.74711
0.00775 | 3.2192e-04 | 0.74676
0.00800 | 4.7692e-04 | 0.81450
0.00825 | 4.2022e-04 | 0.79027
0.00850 | 3.6522e-04 | 0.76607
0.00875 | 3.8862e-04 | 0.77621
0.00900 | 4.1192e-04 | 0.78649
0.00925 | 4.0862e-04 | 0.78506
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
