orpheus016/sg13cmos5l_spma_ip__instramp/xschem/coarse_gain/tb/tb_cg_ota/simulations/result/gain-stage_mc.png

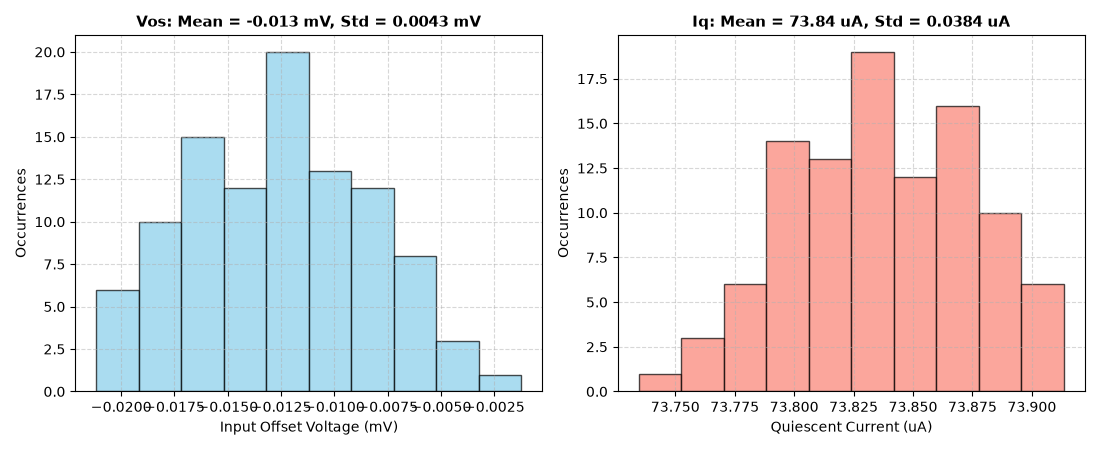
xschem/coarse_gain/tb/tb_cg_ota/simulations/result/gain-stage_mc.png
