orpheus016/sg13cmos5l_spma_ip__instramp/xschem/gain_stage/tb/tb_gain_ota/simulations/result/gain-ota_mc.png

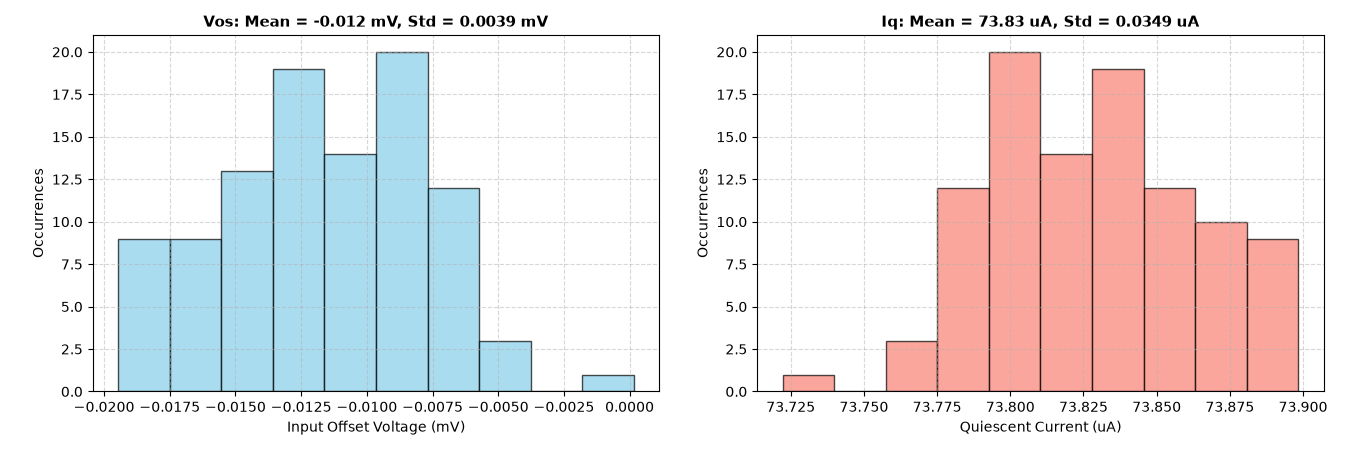
xschem/gain_stage/tb/tb_gain_ota/simulations/result/gain-ota_mc.png
