orpheus016/sg13cmos5l_spma_ip__instramp/scripts/sg13cmos5l_stdcell_lvs.spice

************************************************************************
*
* Copyright 2023 IHP PDK Authors
* 
* Licensed under the Apache License, Version 2.0 (the "License");
* you may not use this file except in compliance with the License.
* You may obtain a copy of the License at
* 
*    https://www.apache.org/licenses/LICENSE-2.0
* 
* Unless required by applicable law or agreed to in writing, software
* distributed under the License is distributed on an "AS IS" BASIS,
* WITHOUT WARRANTIES OR CONDITIONS OF ANY KIND, either express or implied.
* See the License for the specific language governing permissions and
* limitations under the License.
*
************************************************************************

* Library name: sg13cmos5l_stdcell
* Cell name: sg13cmos5l_a21o_1
* View name: schematic
.subckt sg13cmos5l_a21o_1 X A1 A2 B1 VDD VSS
MN0 net1 A1 net2 VSS sg13_lv_nmos w=640.00n l=130.00n ng=1 ad=2.176e-13 as=2.176e-13 pd=1.96e-06 ps=1.96e-06 m=1
MN1 net2 A2 VSS VSS sg13_lv_nmos w=640.00n l=130.00n ng=1 ad=2.176e-13 as=2.176e-13 pd=1.96e-06 ps=1.96e-06 m=1
MN2 net1 B1 VSS VSS sg13_lv_nmos w=640.00n l=130.00n ng=1 ad=2.176e-13 as=2.176e-13 pd=1.96e-06 ps=1.96e-06 m=1
MN3 X net1 VSS VSS sg13_lv_nmos w=740.00n l=130.00n ng=1 ad=2.516e-13 as=2.516e-13 pd=2.16e-06 ps=2.16e-06 m=1
MP2 net1 B1 net3 VDD sg13_lv_pmos w=1.000u l=130.00n ng=1 ad=3.4e-13 as=3.4e-13 pd=2.68e-06 ps=2.68e-06 m=1
MP0 net3 A1 VDD VDD sg13_lv_pmos w=1.000u l=130.00n ng=1 ad=3.4e-13 as=3.4e-13 pd=2.68e-06 ps=2.68e-06 m=1
MP1 net3 A2 VDD VDD sg13_lv_pmos w=1.000u l=130.00n ng=1 ad=3.4e-13 as=3.4e-13 pd=2.68e-06 ps=2.68e-06 m=1
MP3 X net1 VDD VDD sg13_lv_pmos w=1.12u l=130.00n ng=1 ad=3.808e-13 as=3.808e-13 pd=2.92e-06 ps=2.92e-06 m=1
.ends
* End of subcircuit definition.

* Library name: sg13cmos5l_stdcell
* Cell name: sg13cmos5l_a21o_2
* View name: schematic
.subckt sg13cmos5l_a21o_2 X A1 A2 B1 VDD VSS
MN0 net1 A1 net2 VSS sg13_lv_nmos w=740.00n l=130.00n ng=1 ad=2.516e-13 as=2.516e-13 pd=2.16e-06 ps=2.16e-06 m=1
MN1 net2 A2 VSS VSS sg13_lv_nmos w=740.00n l=130.00n ng=1 ad=2.516e-13 as=2.516e-13 pd=2.16e-06 ps=2.16e-06 m=1
MN2 net1 B1 VSS VSS sg13_lv_nmos w=740.00n l=130.00n ng=1 ad=2.516e-13 as=2.516e-13 pd=2.16e-06 ps=2.16e-06 m=1
MN3 X net1 VSS VSS sg13_lv_nmos w=1.48u l=130.00n ng=2 ad=2.812e-13 as=5.032e-13 pd=2.24e-06 ps=4.32e-06 m=1
MP2 net1 B1 net3 VDD sg13_lv_pmos w=1.000u l=130.00n ng=1 ad=3.4e-13 as=3.4e-13 pd=2.68e-06 ps=2.68e-06 m=1
MP0 net3 A1 VDD VDD sg13_lv_pmos w=1.000u l=130.00n ng=1 ad=3.4e-13 as=3.4e-13 pd=2.68e-06 ps=2.68e-06 m=1
MP1 net3 A2 VDD VDD sg13_lv_pmos w=1.000u l=130.00n ng=1 ad=3.4e-13 as=3.4e-13 pd=2.68e-06 ps=2.68e-06 m=1
MP3 X net1 VDD VDD sg13_lv_pmos w=2.24u l=130.00n ng=2 ad=4.256e-13 as=7.616e-13 pd=3e-06 ps=5.84e-06 m=1
.ends
* End of subcircuit definition.

* Library name: sg13cmos5l_stdcell
* Cell name: sg13cmos5l_a21oi_1
* View name: schematic
.subckt sg13cmos5l_a21oi_1 Y A1 A2 B1 VDD VSS
MN0 Y B1 VSS VSS sg13_lv_nmos w=740.00n l=130.00n ng=1 ad=2.516e-13 as=2.516e-13 pd=2.16e-06 ps=2.16e-06 m=1
MN2 net1 A2 VSS VSS sg13_lv_nmos w=740.00n l=130.00n ng=1 ad=2.516e-13 as=2.516e-13 pd=2.16e-06 ps=2.16e-06 m=1
MN1 Y A1 net1 VSS sg13_lv_nmos w=740.00n l=130.00n ng=1 ad=2.516e-13 as=2.516e-13 pd=2.16e-06 ps=2.16e-06 m=1
MP2 Y B1 net2 VDD sg13_lv_pmos w=1.12u l=130.00n ng=1 ad=3.808e-13 as=3.808e-13 pd=2.92e-06 ps=2.92e-06 m=1
MP1 net2 A2 VDD VDD sg13_lv_pmos w=1.12u l=130.00n ng=1 ad=3.808e-13 as=3.808e-13 pd=2.92e-06 ps=2.92e-06 m=1
MP0 net2 A1 VDD VDD sg13_lv_pmos w=1.12u l=130.00n ng=1 ad=3.808e-13 as=3.808e-13 pd=2.92e-06 ps=2.92e-06 m=1
.ends
* End of subcircuit definition.

* Library name: sg13cmos5l_stdcell
* Cell name: sg13cmos5l_a21oi_2
* View name: schematic
.subckt sg13cmos5l_a21oi_2 Y A1 A2 B1 VDD VSS
MN0 Y B1 VSS VSS sg13_lv_nmos w=1.48u l=130.00n ng=2 ad=2.812e-13 as=5.032e-13 pd=2.24e-06 ps=4.32e-06 m=1
MN2 net2 A2 VSS VSS sg13_lv_nmos w=1.48u l=130.00n ng=2 ad=2.812e-13 as=5.032e-13 pd=2.24e-06 ps=4.32e-06 m=1
MN1 Y A1 net2 VSS sg13_lv_nmos w=1.48u l=130.00n ng=2 ad=2.812e-13 as=5.032e-13 pd=2.24e-06 ps=4.32e-06 m=1
MP2 Y B1 net1 VDD sg13_lv_pmos w=2.24u l=130.00n ng=2 ad=4.256e-13 as=7.616e-13 pd=3e-06 ps=5.84e-06 m=1
MP1 net1 A2 VDD VDD sg13_lv_pmos w=2.24u l=130.00n ng=2 ad=4.256e-13 as=7.616e-13 pd=3e-06 ps=5.84e-06 m=1
MP0 net1 A1 VDD VDD sg13_lv_pmos w=2.24u l=130.00n ng=2 ad=4.256e-13 as=7.616e-13 pd=3e-06 ps=5.84e-06 m=1
.ends
* End of subcircuit definition.

* Library name: sg13cmos5l_stdcell
* Cell name: sg13cmos5l_a221oi_1
* View name: schematic
.subckt sg13cmos5l_a221oi_1 Y A1 A2 B1 B2 C1 VDD VSS
MP2 Y C1 net3 VDD sg13_lv_pmos w=1.12u l=130.00n ng=1 ad=3.808e-13 as=3.808e-13 pd=2.92e-06 ps=2.92e-06 m=1
MP4 net3 B2 net1 VDD sg13_lv_pmos w=1.12u l=130.00n ng=1 ad=3.808e-13 as=3.808e-13 pd=2.92e-06 ps=2.92e-06 m=1
MP1 net3 B1 net1 VDD sg13_lv_pmos w=1.12u l=130.00n ng=1 ad=3.808e-13 as=3.808e-13 pd=2.92e-06 ps=2.92e-06 m=1
MP3 net1 A2 VDD VDD sg13_lv_pmos w=1.12u l=130.00n ng=1 ad=3.808e-13 as=3.808e-13 pd=2.92e-06 ps=2.92e-06 m=1
MP0 net1 A1 VDD VDD sg13_lv_pmos w=1.12u l=130.00n ng=1 ad=3.808e-13 as=3.808e-13 pd=2.92e-06 ps=2.92e-06 m=1
MN4 Y C1 VSS VSS sg13_lv_nmos w=740.00n l=130.00n ng=1 ad=2.516e-13 as=2.516e-13 pd=2.16e-06 ps=2.16e-06 m=1
MN3 net4 B2 VSS VSS sg13_lv_nmos w=740.00n l=130.00n ng=1 ad=2.516e-13 as=2.516e-13 pd=2.16e-06 ps=2.16e-06 m=1
MN2 Y B1 net4 VSS sg13_lv_nmos w=740.00n l=130.00n ng=1 ad=2.516e-13 as=2.516e-13 pd=2.16e-06 ps=2.16e-06 m=1
MN1 net2 A2 VSS VSS sg13_lv_nmos w=740.00n l=130.00n ng=1 ad=2.516e-13 as=2.516e-13 pd=2.16e-06 ps=2.16e-06 m=1
MN0 Y A1 net2 VSS sg13_lv_nmos w=740.00n l=130.00n ng=1 ad=2.516e-13 as=2.516e-13 pd=2.16e-06 ps=2.16e-06 m=1
.ends
* End of subcircuit definition.

* Library name: sg13cmos5l_stdcell
* Cell name: sg13cmos5l_and2_1
* View name: schematic
.subckt sg13cmos5l_and2_1 X A B VDD VSS
MN0 net4 A net2 VSS sg13_lv_nmos w=640.00n l=130.00n ng=1 ad=2.176e-13 as=2.176e-13 pd=1.96e-06 ps=1.96e-06 m=1
MN2 X net4 VSS VSS sg13_lv_nmos w=740.00n l=130.00n ng=1 ad=2.516e-13 as=2.516e-13 pd=2.16e-06 ps=2.16e-06 m=1
MN1 net2 B VSS VSS sg13_lv_nmos w=640.00n l=130.00n ng=1 ad=2.176e-13 as=2.176e-13 pd=1.96e-06 ps=1.96e-06 m=1
MP0 net4 B VDD VDD sg13_lv_pmos w=840.00n l=130.00n ng=1 ad=2.856e-13 as=2.856e-13 pd=2.36e-06 ps=2.36e-06 m=1
MP2 X net4 VDD VDD sg13_lv_pmos w=1.12u l=130.00n ng=1 ad=3.808e-13 as=3.808e-13 pd=2.92e-06 ps=2.92e-06 m=1
MP1 net4 A VDD VDD sg13_lv_pmos w=840.00n l=130.00n ng=1 ad=2.856e-13 as=2.856e-13 pd=2.36e-06 ps=2.36e-06 m=1
.ends
* End of subcircuit definition.

* Library name: sg13cmos5l_stdcell
* Cell name: sg13cmos5l_and2_2
* View name: schematic
.subckt sg13cmos5l_and2_2 X A B VDD VSS
MN0 net1 A net2 VSS sg13_lv_nmos w=640.00n l=130.00n ng=1 ad=2.176e-13 as=2.176e-13 pd=1.96e-06 ps=1.96e-06 m=1
MN2 X net1 VSS VSS sg13_lv_nmos w=1.48u l=130.00n ng=2 ad=2.812e-13 as=5.032e-13 pd=2.24e-06 ps=4.32e-06 m=1
MN1 net2 B VSS VSS sg13_lv_nmos w=640.00n l=130.00n ng=1 ad=2.176e-13 as=2.176e-13 pd=1.96e-06 ps=1.96e-06 m=1
MP0 net1 B VDD VDD sg13_lv_pmos w=840.00n l=130.00n ng=1 ad=2.856e-13 as=2.856e-13 pd=2.36e-06 ps=2.36e-06 m=1
MP2 X net1 VDD VDD sg13_lv_pmos w=2.24u l=130.00n ng=2 ad=4.256e-13 as=7.616e-13 pd=3e-06 ps=5.84e-06 m=1
MP1 net1 A VDD VDD sg13_lv_pmos w=840.00n l=130.00n ng=1 ad=2.856e-13 as=2.856e-13 pd=2.36e-06 ps=2.36e-06 m=1
.ends
* End of subcircuit definition.

* Library name: sg13cmos5l_stdcell
* Cell name: sg13cmos5l_and3_1
* View name: schematic
.subckt sg13cmos5l_and3_1 X A B C VDD VSS
MN2 net3 C VSS VSS sg13_lv_nmos w=640.00n l=130.00n ng=1 ad=2.176e-13 as=2.176e-13 pd=1.96e-06 ps=1.96e-06 m=1
MN3 X net2 VSS VSS sg13_lv_nmos w=740.00n l=130.00n ng=1 ad=2.516e-13 as=2.516e-13 pd=2.16e-06 ps=2.16e-06 m=1
MN0 net2 A net1 VSS sg13_lv_nmos w=640.00n l=130.00n ng=1 ad=2.176e-13 as=2.176e-13 pd=1.96e-06 ps=1.96e-06 m=1
MN1 net1 B net3 VSS sg13_lv_nmos w=640.00n l=130.00n ng=1 ad=2.176e-13 as=2.176e-13 pd=1.96e-06 ps=1.96e-06 m=1
MP3 X net2 VDD VDD sg13_lv_pmos w=1.12u l=130.00n ng=1 ad=3.808e-13 as=3.808e-13 pd=2.92e-06 ps=2.92e-06 m=1
MP1 net2 B VDD VDD sg13_lv_pmos w=840.00n l=130.00n ng=1 ad=2.856e-13 as=2.856e-13 pd=2.36e-06 ps=2.36e-06 m=1
MP2 net2 A VDD VDD sg13_lv_pmos w=840.00n l=130.00n ng=1 ad=2.856e-13 as=2.856e-13 pd=2.36e-06 ps=2.36e-06 m=1
MP0 net2 C VDD VDD sg13_lv_pmos w=840.00n l=130.00n ng=1 ad=2.856e-13 as=2.856e-13 pd=2.36e-06 ps=2.36e-06 m=1
.ends
* End of subcircuit definition.

* Library name: sg13cmos5l_stdcell
* Cell name: sg13cmos5l_and3_2
* View name: schematic
.subckt sg13cmos5l_and3_2 X A B C VDD VSS
MN2 net3 C VSS VSS sg13_lv_nmos w=640.00n l=130.00n ng=1 ad=2.176e-13 as=2.176e-13 pd=1.96e-06 ps=1.96e-06 m=1
MN3 X net2 VSS VSS sg13_lv_nmos w=1.48u l=130.00n ng=2 ad=2.812e-13 as=5.032e-13 pd=2.24e-06 ps=4.32e-06 m=1
MN0 net2 A net1 VSS sg13_lv_nmos w=640.00n l=130.00n ng=1 ad=2.176e-13 as=2.176e-13 pd=1.96e-06 ps=1.96e-06 m=1
MN1 net1 B net3 VSS sg13_lv_nmos w=640.00n l=130.00n ng=1 ad=2.176e-13 as=2.176e-13 pd=1.96e-06 ps=1.96e-06 m=1
MP3 X net2 VDD VDD sg13_lv_pmos w=2.24u l=130.00n ng=2 ad=4.256e-13 as=7.616e-13 pd=3e-06 ps=5.84e-06 m=1
MP1 net2 B VDD VDD sg13_lv_pmos w=840.00n l=130.00n ng=1 ad=2.856e-13 as=2.856e-13 pd=2.36e-06 ps=2.36e-06 m=1
MP2 net2 A VDD VDD sg13_lv_pmos w=840.00n l=130.00n ng=1 ad=2.856e-13 as=2.856e-13 pd=2.36e-06 ps=2.36e-06 m=1
MP0 net2 C VDD VDD sg13_lv_pmos w=840.00n l=130.00n ng=1 ad=2.856e-13 as=2.856e-13 pd=2.36e-06 ps=2.36e-06 m=1
.ends
* End of subcircuit definition.

* Library name: sg13cmos5l_stdcell
* Cell name: sg13cmos5l_and4_1
* View name: schematic
.subckt sg13cmos5l_and4_1 X A B C D VDD VSS
MN3 net17 D VSS VSS sg13_lv_nmos w=640.00n l=130.00n ng=1 ad=2.176e-13 as=2.176e-13 pd=1.96e-06 ps=1.96e-06 m=1
MN2 net16 C net17 VSS sg13_lv_nmos w=640.00n l=130.00n ng=1 ad=2.176e-13 as=2.176e-13 pd=1.96e-06 ps=1.96e-06 m=1
MN1 net15 B net16 VSS sg13_lv_nmos w=640.00n l=130.00n ng=1 ad=2.176e-13 as=2.176e-13 pd=1.96e-06 ps=1.96e-06 m=1
MN0 net1 A net15 VSS sg13_lv_nmos w=640.00n l=130.00n ng=1 ad=2.176e-13 as=2.176e-13 pd=1.96e-06 ps=1.96e-06 m=1
MN4 X net1 VSS VSS sg13_lv_nmos w=740.00n l=130.00n ng=1 ad=2.516e-13 as=2.516e-13 pd=2.16e-06 ps=2.16e-06 m=1
MP3 net1 A VDD VDD sg13_lv_pmos w=840.00n l=130.00n ng=1 ad=2.856e-13 as=2.856e-13 pd=2.36e-06 ps=2.36e-06 m=1
MP4 X net1 VDD VDD sg13_lv_pmos w=1.12u l=130.00n ng=1 ad=3.808e-13 as=3.808e-13 pd=2.92e-06 ps=2.92e-06 m=1
MP0 net1 D VDD VDD sg13_lv_pmos w=840.00n l=130.00n ng=1 ad=2.856e-13 as=2.856e-13 pd=2.36e-06 ps=2.36e-06 m=1
MP1 net1 C VDD VDD sg13_lv_pmos w=840.00n l=130.00n ng=1 ad=2.856e-13 as=2.856e-13 pd=2.36e-06 ps=2.36e-06 m=1
MP2 net1 B VDD VDD sg13_lv_pmos w=840.00n l=130.00n ng=1 ad=2.856e-13 as=2.856e-13 pd=2.36e-06 ps=2.36e-06 m=1
.ends
* End of subcircuit definition.

* Library name: sg13cmos5l_stdcell
* Cell name: sg13cmos5l_and4_2
* View name: schematic
.subckt sg13cmos5l_and4_2 X A B C D VDD VSS
MN3 net17 D VSS VSS sg13_lv_nmos w=640.00n l=130.00n ng=1 ad=2.176e-13 as=2.176e-13 pd=1.96e-06 ps=1.96e-06 m=1
MN2 net16 C net17 VSS sg13_lv_nmos w=640.00n l=130.00n ng=1 ad=2.176e-13 as=2.176e-13 pd=1.96e-06 ps=1.96e-06 m=1
MN1 net15 B net16 VSS sg13_lv_nmos w=640.00n l=130.00n ng=1 ad=2.176e-13 as=2.176e-13 pd=1.96e-06 ps=1.96e-06 m=1
MN0 net1 A net15 VSS sg13_lv_nmos w=640.00n l=130.00n ng=1 ad=2.176e-13 as=2.176e-13 pd=1.96e-06 ps=1.96e-06 m=1
MN4 X net1 VSS VSS sg13_lv_nmos w=1.48u l=130.00n ng=2 ad=2.812e-13 as=5.032e-13 pd=2.24e-06 ps=4.32e-06 m=1
MP3 net1 A VDD VDD sg13_lv_pmos w=840.00n l=130.00n ng=1 ad=2.856e-13 as=2.856e-13 pd=2.36e-06 ps=2.36e-06 m=1
MP4 X net1 VDD VDD sg13_lv_pmos w=2.24u l=130.00n ng=2 ad=4.256e-13 as=7.616e-13 pd=3e-06 ps=5.84e-06 m=1
MP0 net1 D VDD VDD sg13_lv_pmos w=840.00n l=130.00n ng=1 ad=2.856e-13 as=2.856e-13 pd=2.36e-06 ps=2.36e-06 m=1
MP1 net1 C VDD VDD sg13_lv_pmos w=840.00n l=130.00n ng=1 ad=2.856e-13 as=2.856e-13 pd=2.36e-06 ps=2.36e-06 m=1
MP2 net1 B VDD VDD sg13_lv_pmos w=840.00n l=130.00n ng=1 ad=2.856e-13 as=2.856e-13 pd=2.36e-06 ps=2.36e-06 m=1
.ends
* End of subcircuit definition.

* Library name: sg13cmos5l_stdcell
* Cell name: sg13cmos5l_antennanp
* View name: schematic
.subckt sg13cmos5l_antennanp A VDD VSS
XD1 VSS A dantenna l=780n w=780n m=1
XD0 A VDD dpantenna l=1.34u w=1.05u m=1
.ends
* End of subcircuit definition.

* Library name: sg13cmos5l_stdcell
* Cell name: sg13cmos5l_buf_1
* View name: schematic
.subckt sg13cmos5l_buf_1 X A VDD VSS
MN0 net1 A VSS VSS sg13_lv_nmos w=550.00n l=130.00n ng=1 ad=1.87e-13 as=1.87e-13 pd=1.78e-06 ps=1.78e-06 m=1
MN1 X net1 VSS VSS sg13_lv_nmos w=740.00n l=130.00n ng=1 ad=2.516e-13 as=2.516e-13 pd=2.16e-06 ps=2.16e-06 m=1
MP1 X net1 VDD VDD sg13_lv_pmos w=1.12u l=130.00n ng=1 ad=3.808e-13 as=3.808e-13 pd=2.92e-06 ps=2.92e-06 m=1
MP0 net1 A VDD VDD sg13_lv_pmos w=840.00n l=130.00n ng=1 ad=2.856e-13 as=2.856e-13 pd=2.36e-06 ps=2.36e-06 m=1
.ends
* End of subcircuit definition.

* Library name: sg13cmos5l_stdcell
* Cell name: sg13cmos5l_buf_16
* View name: schematic
.subckt sg13cmos5l_buf_16 X A VDD VSS
MN0 net1 A VSS VSS sg13_lv_nmos w=4.44u l=130.00n ng=6 ad=8.436e-13 as=1.066e-12 pd=6.72e-06 ps=8.8e-06 m=1
MN1 X net1 VSS VSS sg13_lv_nmos w=11.84u l=130.00n ng=16 ad=2.25e-12 as=2.472e-12 pd=1.792e-05 ps=2e-05 m=1
MP1 X net1 VDD VDD sg13_lv_pmos w=17.92u l=130.00n ng=16 ad=3.405e-12 as=3.741e-12 pd=2.4e-05 ps=2.684e-05 m=1
MP0 net1 A VDD VDD sg13_lv_pmos w=6.72u l=130.00n ng=6 ad=1.277e-12 as=1.613e-12 pd=9e-06 ps=1.184e-05 m=1
.ends
* End of subcircuit definition.

* Library name: sg13cmos5l_stdcell
* Cell name: sg13cmos5l_buf_2
* View name: schematic
.subckt sg13cmos5l_buf_2 X A VDD VSS
MN0 net1 A VSS VSS sg13_lv_nmos w=640.00n l=130.00n ng=1 ad=2.176e-13 as=2.176e-13 pd=1.96e-06 ps=1.96e-06 m=1
MN1 X net1 VSS VSS sg13_lv_nmos w=1.48u l=130.00n ng=2 ad=2.812e-13 as=5.032e-13 pd=2.24e-06 ps=4.32e-06 m=1
MP1 X net1 VDD VDD sg13_lv_pmos w=2.24u l=130.00n ng=2 ad=4.256e-13 as=7.616e-13 pd=3e-06 ps=5.84e-06 m=1
MP0 net1 A VDD VDD sg13_lv_pmos w=1.000u l=130.00n ng=1 ad=3.4e-13 as=3.4e-13 pd=2.68e-06 ps=2.68e-06 m=1
.ends
* End of subcircuit definition.

* Library name: sg13cmos5l_stdcell
* Cell name: sg13cmos5l_buf_4
* View name: schematic
.subckt sg13cmos5l_buf_4 X A VDD VSS
MN0 net1 A VSS VSS sg13_lv_nmos w=740.00n l=130.00n ng=1 ad=2.516e-13 as=2.516e-13 pd=2.16e-06 ps=2.16e-06 m=1
MN1 X net1 VSS VSS sg13_lv_nmos w=2.96u l=130.00n ng=4 ad=5.624e-13 as=7.844e-13 pd=4.48e-06 ps=6.56e-06 m=1
MP1 X net1 VDD VDD sg13_lv_pmos w=4.48u l=130.00n ng=4 ad=8.512e-13 as=1.187e-12 pd=6e-06 ps=8.84e-06 m=1
MP0 net1 A VDD VDD sg13_lv_pmos w=1.68u l=130.00n ng=2 ad=3.192e-13 as=5.712e-13 pd=2.44e-06 ps=4.72e-06 m=1
.ends
* End of subcircuit definition.

* Library name: sg13cmos5l_stdcell
* Cell name: sg13cmos5l_buf_8
* View name: schematic
.subckt sg13cmos5l_buf_8 X A VDD VSS
MN0 net1 A VSS VSS sg13_lv_nmos w=2.22u l=130.00n ng=3 ad=5.328e-13 as=5.328e-13 pd=4.4e-06 ps=4.4e-06 m=1
MN1 X net1 VSS VSS sg13_lv_nmos w=5.92u l=130.00n ng=8 ad=1.125e-12 as=1.347e-12 pd=8.96e-06 ps=1.104e-05 m=1
MP1 X net1 VDD VDD sg13_lv_pmos w=8.96u l=130.00n ng=8 ad=1.702e-12 as=2.038e-12 pd=1.2e-05 ps=1.484e-05 m=1
MP0 net1 A VDD VDD sg13_lv_pmos w=3.36u l=130.00n ng=3 ad=8.064e-13 as=8.064e-13 pd=5.92e-06 ps=5.92e-06 m=1
.ends
* End of subcircuit definition.

* Library name: sg13cmos5l_stdcell
* Cell name: sg13cmos5l_decap_4
* View name: schematic
.subckt sg13cmos5l_decap_4 VDD VSS
MN0 VSS VDD VSS VSS sg13_lv_nmos w=420.00n l=1.000u ng=1 ad=1.428e-13 as=1.428e-13 pd=1.52e-06 ps=1.52e-06 m=1
MP0 VDD VSS VDD VDD sg13_lv_pmos w=1.000u l=1.000u ng=1 ad=3.4e-13 as=3.4e-13 pd=2.68e-06 ps=2.68e-06 m=1
.ends
* End of subcircuit definition.

* Library name: sg13cmos5l_stdcell
* Cell name: sg13cmos5l_decap_8
* View name: schematic
.subckt sg13cmos5l_decap_8 VDD VSS
MN0 VSS VDD VSS VSS sg13_lv_nmos w=840.00n l=1.000u ng=2 ad=1.596e-13 as=2.856e-13 pd=1.6e-06 ps=3.04e-06 m=1
MP0 VDD VSS VDD VDD sg13_lv_pmos w=2.000u l=1.000u ng=2 ad=3.8e-13 as=6.8e-13 pd=2.76e-06 ps=5.36e-06 m=1
.ends
* End of subcircuit definition.

* Library name: sg13cmos5l_stdcell
* Cell name: sg13cmos5l_dfrbp_1
* View name: schematic
.subckt sg13cmos5l_dfrbp_1 Q Q_N CLK D RESET_B VDD VSS
MN11 net12 net2 VSS VSS sg13_lv_nmos w=420.00n l=130.00n ng=1 ad=1.428e-13 as=1.428e-13 pd=1.52e-06 ps=1.52e-06 m=1
MN10 net5 clkneg net12 VSS sg13_lv_nmos w=420.00n l=130.00n ng=1 ad=1.428e-13 as=1.428e-13 pd=1.52e-06 ps=1.52e-06 m=1
MN12 net2 net5 net11 VSS sg13_lv_nmos w=420.00n l=130.00n ng=1 ad=1.428e-13 as=1.428e-13 pd=1.52e-06 ps=1.52e-06 m=1
MN13 net11 RESET_B VSS VSS sg13_lv_nmos w=420.00n l=130.00n ng=1 ad=1.428e-13 as=1.428e-13 pd=1.52e-06 ps=1.52e-06 m=1
MN14 Q_N net5 VSS VSS sg13_lv_nmos w=740.00n l=130.00n ng=1 ad=2.516e-13 as=2.516e-13 pd=2.16e-06 ps=2.16e-06 m=1
MN0 Db D net10 VSS sg13_lv_nmos w=420.00n l=130.00n ng=1 ad=1.428e-13 as=1.428e-13 pd=1.52e-06 ps=1.52e-06 m=1
MN1 net10 RESET_B VSS VSS sg13_lv_nmos w=420.00n l=130.00n ng=1 ad=1.428e-13 as=1.428e-13 pd=1.52e-06 ps=1.52e-06 m=1
MN4 Db clkneg net6 VSS sg13_lv_nmos w=420.00n l=130.00n ng=1 ad=1.428e-13 as=1.428e-13 pd=1.52e-06 ps=1.52e-06 m=1
MN5 net6 clkpos net9 VSS sg13_lv_nmos w=420.00n l=130.00n ng=1 ad=1.428e-13 as=1.428e-13 pd=1.52e-06 ps=1.52e-06 m=1
MN6 net9 net4 net8 VSS sg13_lv_nmos w=420.00n l=130.00n ng=1 ad=1.428e-13 as=1.428e-13 pd=1.52e-06 ps=1.52e-06 m=1
MN7 net8 RESET_B VSS VSS sg13_lv_nmos w=420.00n l=130.00n ng=1 ad=1.428e-13 as=1.428e-13 pd=1.52e-06 ps=1.52e-06 m=1
MN8 net4 net6 VSS VSS sg13_lv_nmos w=740.00n l=130.00n ng=1 ad=2.516e-13 as=2.516e-13 pd=2.16e-06 ps=2.16e-06 m=1
MN2 clkneg CLK VSS VSS sg13_lv_nmos w=740.00n l=130.00n ng=1 ad=2.516e-13 as=2.516e-13 pd=2.16e-06 ps=2.16e-06 m=1
MN9 net4 clkpos net5 VSS sg13_lv_nmos w=740.00n l=130.00n ng=1 ad=2.516e-13 as=2.516e-13 pd=2.16e-06 ps=2.16e-06 m=1
MN3 clkpos clkneg VSS VSS sg13_lv_nmos w=740.00n l=130.00n ng=1 ad=2.516e-13 as=2.516e-13 pd=2.16e-06 ps=2.16e-06 m=1
MN16 Q net1 VSS VSS sg13_lv_nmos w=740.00n l=130.00n ng=1 ad=2.516e-13 as=2.516e-13 pd=2.16e-06 ps=2.16e-06 m=1
MN15 net1 net5 VSS VSS sg13_lv_nmos w=740.00n l=130.00n ng=1 ad=2.516e-13 as=2.516e-13 pd=2.16e-06 ps=2.16e-06 m=1
MP11 net5 clkpos net3 VDD sg13_lv_pmos w=420.00n l=130.00n ng=1 ad=1.428e-13 as=1.428e-13 pd=1.52e-06 ps=1.52e-06 m=1
MP12 net2 net5 VDD VDD sg13_lv_pmos w=420.00n l=130.00n ng=1 ad=1.428e-13 as=1.428e-13 pd=1.52e-06 ps=1.52e-06 m=1
MP13 net2 RESET_B VDD VDD sg13_lv_pmos w=420.00n l=130.00n ng=1 ad=1.428e-13 as=1.428e-13 pd=1.52e-06 ps=1.52e-06 m=1
MP14 Q_N net5 VDD VDD sg13_lv_pmos w=1.12u l=130.00n ng=1 ad=3.808e-13 as=3.808e-13 pd=2.92e-06 ps=2.92e-06 m=1
MP4 Db clkpos net6 VDD sg13_lv_pmos w=420.00n l=130.00n ng=1 ad=1.428e-13 as=1.428e-13 pd=1.52e-06 ps=1.52e-06 m=1
MP0 Db RESET_B VDD VDD sg13_lv_pmos w=420.00n l=130.00n ng=1 ad=1.428e-13 as=1.428e-13 pd=1.52e-06 ps=1.52e-06 m=1
MP1 Db D VDD VDD sg13_lv_pmos w=420.00n l=130.00n ng=1 ad=1.428e-13 as=1.428e-13 pd=1.52e-06 ps=1.52e-06 m=1
MP5 net7 net4 VDD VDD sg13_lv_pmos w=420.00n l=130.00n ng=1 ad=1.428e-13 as=1.428e-13 pd=1.52e-06 ps=1.52e-06 m=1
MP6 net6 clkneg net7 VDD sg13_lv_pmos w=420.00n l=130.00n ng=1 ad=1.428e-13 as=1.428e-13 pd=1.52e-06 ps=1.52e-06 m=1
MP7 net6 RESET_B VDD VDD sg13_lv_pmos w=420.00n l=130.00n ng=1 ad=1.428e-13 as=1.428e-13 pd=1.52e-06 ps=1.52e-06 m=1
MP2 clkneg CLK VDD VDD sg13_lv_pmos w=1.12u l=130.00n ng=1 ad=3.808e-13 as=3.808e-13 pd=2.92e-06 ps=2.92e-06 m=1
MP3 clkpos clkneg VDD VDD sg13_lv_pmos w=1.12u l=130.00n ng=1 ad=3.808e-13 as=3.808e-13 pd=2.92e-06 ps=2.92e-06 m=1
MP8 net4 net6 VDD VDD sg13_lv_pmos w=1.000u l=130.00n ng=1 ad=3.4e-13 as=3.4e-13 pd=2.68e-06 ps=2.68e-06 m=1
MP9 net4 clkneg net5 VDD sg13_lv_pmos w=1.000u l=130.00n ng=1 ad=3.4e-13 as=3.4e-13 pd=2.68e-06 ps=2.68e-06 m=1
MP16 Q net1 VDD VDD sg13_lv_pmos w=1.12u l=130.00n ng=1 ad=3.808e-13 as=3.808e-13 pd=2.92e-06 ps=2.92e-06 m=1
MP10 net3 net2 VDD VDD sg13_lv_pmos w=420.00n l=130.00n ng=1 ad=1.428e-13 as=1.428e-13 pd=1.52e-06 ps=1.52e-06 m=1
MP15 net1 net5 VDD VDD sg13_lv_pmos w=1.12u l=130.00n ng=1 ad=3.808e-13 as=3.808e-13 pd=2.92e-06 ps=2.92e-06 m=1
.ends
* End of subcircuit definition.

* Library name: sg13cmos5l_stdcell
* Cell name: sg13cmos5l_dfrbp_2
* View name: schematic
.subckt sg13cmos5l_dfrbp_2 Q Q_N CLK D RESET_B VDD VSS
MN11 net12 net2 VSS VSS sg13_lv_nmos w=420.00n l=130.00n ng=1 ad=1.428e-13 as=1.428e-13 pd=1.52e-06 ps=1.52e-06 m=1
MN10 net5 clkneg net12 VSS sg13_lv_nmos w=420.00n l=130.00n ng=1 ad=1.428e-13 as=1.428e-13 pd=1.52e-06 ps=1.52e-06 m=1
MN12 net2 net5 net11 VSS sg13_lv_nmos w=420.00n l=130.00n ng=1 ad=1.428e-13 as=1.428e-13 pd=1.52e-06 ps=1.52e-06 m=1
MN13 net11 RESET_B VSS VSS sg13_lv_nmos w=420.00n l=130.00n ng=1 ad=1.428e-13 as=1.428e-13 pd=1.52e-06 ps=1.52e-06 m=1
MN14 Q_N net5 VSS VSS sg13_lv_nmos w=1.48u l=130.00n ng=2 ad=2.812e-13 as=5.032e-13 pd=2.24e-06 ps=4.32e-06 m=1
MN0 Db D net10 VSS sg13_lv_nmos w=420.00n l=130.00n ng=1 ad=1.428e-13 as=1.428e-13 pd=1.52e-06 ps=1.52e-06 m=1
MN1 net10 RESET_B VSS VSS sg13_lv_nmos w=420.00n l=130.00n ng=1 ad=1.428e-13 as=1.428e-13 pd=1.52e-06 ps=1.52e-06 m=1
MN4 Db clkneg net6 VSS sg13_lv_nmos w=420.00n l=130.00n ng=1 ad=1.428e-13 as=1.428e-13 pd=1.52e-06 ps=1.52e-06 m=1
MN5 net6 clkpos net9 VSS sg13_lv_nmos w=420.00n l=130.00n ng=1 ad=1.428e-13 as=1.428e-13 pd=1.52e-06 ps=1.52e-06 m=1
MN6 net9 net4 net8 VSS sg13_lv_nmos w=420.00n l=130.00n ng=1 ad=1.428e-13 as=1.428e-13 pd=1.52e-06 ps=1.52e-06 m=1
MN7 net8 RESET_B VSS VSS sg13_lv_nmos w=420.00n l=130.00n ng=1 ad=1.428e-13 as=1.428e-13 pd=1.52e-06 ps=1.52e-06 m=1
MN8 net4 net6 VSS VSS sg13_lv_nmos w=740.00n l=130.00n ng=1 ad=2.516e-13 as=2.516e-13 pd=2.16e-06 ps=2.16e-06 m=1
MN2 clkneg CLK VSS VSS sg13_lv_nmos w=740.00n l=130.00n ng=1 ad=2.516e-13 as=2.516e-13 pd=2.16e-06 ps=2.16e-06 m=1
MN9 net4 clkpos net5 VSS sg13_lv_nmos w=740.00n l=130.00n ng=1 ad=2.516e-13 as=2.516e-13 pd=2.16e-06 ps=2.16e-06 m=1
MN3 clkpos clkneg VSS VSS sg13_lv_nmos w=740.00n l=130.00n ng=1 ad=2.516e-13 as=2.516e-13 pd=2.16e-06 ps=2.16e-06 m=1
MN16 Q net1 VSS VSS sg13_lv_nmos w=1.48u l=130.00n ng=2 ad=2.812e-13 as=5.032e-13 pd=2.24e-06 ps=4.32e-06 m=1
MN15 net1 net5 VSS VSS sg13_lv_nmos w=640.00n l=130.00n ng=1 ad=2.176e-13 as=2.176e-13 pd=1.96e-06 ps=1.96e-06 m=1
MP11 net5 clkpos net3 VDD sg13_lv_pmos w=420.00n l=130.00n ng=1 ad=1.428e-13 as=1.428e-13 pd=1.52e-06 ps=1.52e-06 m=1
MP12 net2 net5 VDD VDD sg13_lv_pmos w=420.00n l=130.00n ng=1 ad=1.428e-13 as=1.428e-13 pd=1.52e-06 ps=1.52e-06 m=1
MP13 net2 RESET_B VDD VDD sg13_lv_pmos w=420.00n l=130.00n ng=1 ad=1.428e-13 as=1.428e-13 pd=1.52e-06 ps=1.52e-06 m=1
MP14 Q_N net5 VDD VDD sg13_lv_pmos w=2.24u l=130.00n ng=2 ad=4.256e-13 as=7.616e-13 pd=3e-06 ps=5.84e-06 m=1
MP4 Db clkpos net6 VDD sg13_lv_pmos w=420.00n l=130.00n ng=1 ad=1.428e-13 as=1.428e-13 pd=1.52e-06 ps=1.52e-06 m=1
MP0 Db RESET_B VDD VDD sg13_lv_pmos w=420.00n l=130.00n ng=1 ad=1.428e-13 as=1.428e-13 pd=1.52e-06 ps=1.52e-06 m=1
MP1 Db D VDD VDD sg13_lv_pmos w=420.00n l=130.00n ng=1 ad=1.428e-13 as=1.428e-13 pd=1.52e-06 ps=1.52e-06 m=1
MP5 net7 net4 VDD VDD sg13_lv_pmos w=420.00n l=130.00n ng=1 ad=1.428e-13 as=1.428e-13 pd=1.52e-06 ps=1.52e-06 m=1
MP6 net6 clkneg net7 VDD sg13_lv_pmos w=420.00n l=130.00n ng=1 ad=1.428e-13 as=1.428e-13 pd=1.52e-06 ps=1.52e-06 m=1
MP7 net6 RESET_B VDD VDD sg13_lv_pmos w=420.00n l=130.00n ng=1 ad=1.428e-13 as=1.428e-13 pd=1.52e-06 ps=1.52e-06 m=1
MP2 clkneg CLK VDD VDD sg13_lv_pmos w=1.12u l=130.00n ng=1 ad=3.808e-13 as=3.808e-13 pd=2.92e-06 ps=2.92e-06 m=1
MP3 clkpos clkneg VDD VDD sg13_lv_pmos w=1.12u l=130.00n ng=1 ad=3.808e-13 as=3.808e-13 pd=2.92e-06 ps=2.92e-06 m=1
MP8 net4 net6 VDD VDD sg13_lv_pmos w=1.000u l=130.00n ng=1 ad=3.4e-13 as=3.4e-13 pd=2.68e-06 ps=2.68e-06 m=1
MP9 net4 clkneg net5 VDD sg13_lv_pmos w=1.000u l=130.00n ng=1 ad=3.4e-13 as=3.4e-13 pd=2.68e-06 ps=2.68e-06 m=1
MP16 Q net1 VDD VDD sg13_lv_pmos w=2.24u l=130.00n ng=2 ad=4.256e-13 as=7.616e-13 pd=3e-06 ps=5.84e-06 m=1
MP10 net3 net2 VDD VDD sg13_lv_pmos w=420.00n l=130.00n ng=1 ad=1.428e-13 as=1.428e-13 pd=1.52e-06 ps=1.52e-06 m=1
MP15 net1 net5 VDD VDD sg13_lv_pmos w=1.000u l=130.00n ng=1 ad=3.4e-13 as=3.4e-13 pd=2.68e-06 ps=2.68e-06 m=1
.ends
* End of subcircuit definition.

* Library name: sg13cmos5l_stdcell
* Cell name: sg13cmos5l_dlhq_1
* View name: schematic
.subckt sg13cmos5l_dlhq_1 Q D GATE VDD VSS
MP8 Q qint_b VDD VDD sg13_lv_pmos w=1.12u l=130.00n ng=1 ad=3.808e-13 as=3.808e-13 pd=2.92e-06 ps=2.92e-06 m=1
MP6 qint GATE_BB net8 VDD sg13_lv_pmos w=420.00n l=130.00n ng=1 ad=1.428e-13 as=1.428e-13 pd=1.52e-06 ps=1.52e-06 m=1
MP7 qint_b qint VDD VDD sg13_lv_pmos w=1.12u l=130.00n ng=1 ad=3.808e-13 as=3.808e-13 pd=2.92e-06 ps=2.92e-06 m=1
MP2 Db D VDD VDD sg13_lv_pmos w=840.00n l=130.00n ng=1 ad=2.856e-13 as=2.856e-13 pd=2.36e-06 ps=2.36e-06 m=1
MP0 GATE_B GATE VDD VDD sg13_lv_pmos w=840.00n l=130.00n ng=1 ad=2.856e-13 as=2.856e-13 pd=2.36e-06 ps=2.36e-06 m=1
MP1 GATE_BB GATE_B VDD VDD sg13_lv_pmos w=840.00n l=130.00n ng=1 ad=2.856e-13 as=2.856e-13 pd=2.36e-06 ps=2.36e-06 m=1
MP5 net8 qint_b VDD VDD sg13_lv_pmos w=420.00n l=130.00n ng=1 ad=1.428e-13 as=1.428e-13 pd=1.52e-06 ps=1.52e-06 m=1
MP4 net4 GATE_B qint VDD sg13_lv_pmos w=1.000u l=130.00n ng=1 ad=3.4e-13 as=3.4e-13 pd=2.68e-06 ps=2.68e-06 m=1
MP3 net4 Db VDD VDD sg13_lv_pmos w=1.000u l=130.00n ng=1 ad=3.4e-13 as=3.4e-13 pd=2.68e-06 ps=2.68e-06 m=1
MN0 GATE_B GATE VSS VSS sg13_lv_nmos w=740.00n l=130.00n ng=1 ad=2.516e-13 as=2.516e-13 pd=2.16e-06 ps=2.16e-06 m=1
MN1 GATE_BB GATE_B VSS VSS sg13_lv_nmos w=740.00n l=130.00n ng=1 ad=2.516e-13 as=2.516e-13 pd=2.16e-06 ps=2.16e-06 m=1
MN5 qint GATE_B net9 VSS sg13_lv_nmos w=420.00n l=130.00n ng=1 ad=1.428e-13 as=1.428e-13 pd=1.52e-06 ps=1.52e-06 m=1
MN8 Q qint_b VSS VSS sg13_lv_nmos w=740.00n l=130.00n ng=1 ad=2.516e-13 as=2.516e-13 pd=2.16e-06 ps=2.16e-06 m=1
MN4 net7 Db VSS VSS sg13_lv_nmos w=740.00n l=130.00n ng=1 ad=2.516e-13 as=2.516e-13 pd=2.16e-06 ps=2.16e-06 m=1
MN6 net9 qint_b VSS VSS sg13_lv_nmos w=420.00n l=130.00n ng=1 ad=1.428e-13 as=1.428e-13 pd=1.52e-06 ps=1.52e-06 m=1
MN7 qint_b qint VSS VSS sg13_lv_nmos w=740.00n l=130.00n ng=1 ad=2.516e-13 as=2.516e-13 pd=2.16e-06 ps=2.16e-06 m=1
MN3 qint GATE_BB net7 VSS sg13_lv_nmos w=740.00n l=130.00n ng=1 ad=2.516e-13 as=2.516e-13 pd=2.16e-06 ps=2.16e-06 m=1
MN2 Db D VSS VSS sg13_lv_nmos w=550.00n l=130.00n ng=1 ad=1.87e-13 as=1.87e-13 pd=1.78e-06 ps=1.78e-06 m=1
.ends
* End of subcircuit definition.

* Library name: sg13cmos5l_stdcell
* Cell name: sg13cmos5l_dlhr_1
* View name: schematic
.subckt sg13cmos5l_dlhr_1 Q Q_N D GATE RESET_B VDD VSS
MP8 qint_b RESET_B VDD VDD sg13_lv_pmos w=1.12u l=130.00n ng=1 ad=3.808e-13 as=3.808e-13 pd=2.92e-06 ps=2.92e-06 m=1
MP9 Q qint_b VDD VDD sg13_lv_pmos w=1.12u l=130.00n ng=1 ad=3.808e-13 as=3.808e-13 pd=2.92e-06 ps=2.92e-06 m=1
MP6 qint GATE_BB net11 VDD sg13_lv_pmos w=420.00n l=130.00n ng=1 ad=1.428e-13 as=1.428e-13 pd=1.52e-06 ps=1.52e-06 m=1
MP5 net11 qint_b VDD VDD sg13_lv_pmos w=420.00n l=130.00n ng=1 ad=1.428e-13 as=1.428e-13 pd=1.52e-06 ps=1.52e-06 m=1
MP4 qint GATE_B net2 VDD sg13_lv_pmos w=1.000u l=130.00n ng=1 ad=3.4e-13 as=3.4e-13 pd=2.68e-06 ps=2.68e-06 m=1
MP3 net2 Db VDD VDD sg13_lv_pmos w=1.000u l=130.00n ng=1 ad=3.4e-13 as=3.4e-13 pd=2.68e-06 ps=2.68e-06 m=1
MP2 Db D VDD VDD sg13_lv_pmos w=840.00n l=130.00n ng=1 ad=2.856e-13 as=2.856e-13 pd=2.36e-06 ps=2.36e-06 m=1
MP0 GATE_B GATE VDD VDD sg13_lv_pmos w=840.00n l=130.00n ng=1 ad=2.856e-13 as=2.856e-13 pd=2.36e-06 ps=2.36e-06 m=1
MP11 Q_N qintn_b VDD VDD sg13_lv_pmos w=1.12u l=130.00n ng=1 ad=3.808e-13 as=3.808e-13 pd=2.92e-06 ps=2.92e-06 m=1
MP7 qint_b qint VDD VDD sg13_lv_pmos w=1.12u l=130.00n ng=1 ad=3.808e-13 as=3.808e-13 pd=2.92e-06 ps=2.92e-06 m=1
MP1 GATE_BB GATE_B VDD VDD sg13_lv_pmos w=840.00n l=130.00n ng=1 ad=2.856e-13 as=2.856e-13 pd=2.36e-06 ps=2.36e-06 m=1
MP10 qintn_b qint_b VDD VDD sg13_lv_pmos w=840.00n l=130.00n ng=1 ad=2.856e-13 as=2.856e-13 pd=2.36e-06 ps=2.36e-06 m=1
MN7 qint_b qint net9 VSS sg13_lv_nmos w=740.00n l=130.00n ng=1 ad=2.516e-13 as=2.516e-13 pd=2.16e-06 ps=2.16e-06 m=1
MN8 net9 RESET_B VSS VSS sg13_lv_nmos w=740.00n l=130.00n ng=1 ad=2.516e-13 as=2.516e-13 pd=2.16e-06 ps=2.16e-06 m=1
MN5 qint GATE_B net7 VSS sg13_lv_nmos w=420.00n l=130.00n ng=1 ad=1.428e-13 as=1.428e-13 pd=1.52e-06 ps=1.52e-06 m=1
MN6 net7 qint_b VSS VSS sg13_lv_nmos w=420.00n l=130.00n ng=1 ad=1.428e-13 as=1.428e-13 pd=1.52e-06 ps=1.52e-06 m=1
MN9 Q qint_b VSS VSS sg13_lv_nmos w=740.00n l=130.00n ng=1 ad=2.516e-13 as=2.516e-13 pd=2.16e-06 ps=2.16e-06 m=1
MN3 qint GATE_BB net1 VSS sg13_lv_nmos w=640.00n l=130.00n ng=1 ad=2.176e-13 as=2.176e-13 pd=1.96e-06 ps=1.96e-06 m=1
MN4 net1 Db VSS VSS sg13_lv_nmos w=640.00n l=130.00n ng=1 ad=2.176e-13 as=2.176e-13 pd=1.96e-06 ps=1.96e-06 m=1
MN2 Db D VSS VSS sg13_lv_nmos w=550.00n l=130.00n ng=1 ad=1.87e-13 as=1.87e-13 pd=1.78e-06 ps=1.78e-06 m=1
MN0 GATE_B GATE VSS VSS sg13_lv_nmos w=740.00n l=130.00n ng=1 ad=2.516e-13 as=2.516e-13 pd=2.16e-06 ps=2.16e-06 m=1
MN11 Q_N qintn_b VSS VSS sg13_lv_nmos w=740.00n l=130.00n ng=1 ad=2.516e-13 as=2.516e-13 pd=2.16e-06 ps=2.16e-06 m=1
MN1 GATE_BB GATE_B VSS VSS sg13_lv_nmos w=740.00n l=130.00n ng=1 ad=2.516e-13 as=2.516e-13 pd=2.16e-06 ps=2.16e-06 m=1
MN10 qintn_b qint_b VSS VSS sg13_lv_nmos w=550.00n l=130.00n ng=1 ad=1.87e-13 as=1.87e-13 pd=1.78e-06 ps=1.78e-06 m=1
.ends
* End of subcircuit definition.
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
