orpheus016/sg13cmos5l_spma_ip__instramp/simulations/ota_cmos5l.spice

** sch_path: /foss/designs/sg13cmos5l_spma_ip__instramp/xschem/ota_cmos5l/ota_cmos5l.sch
.subckt ota_cmos5l VSS IBIAS VDD VINN VINP VOUT
*.PININFO IBIAS:B VDD:B VSS:B VOUT:B VINP:B VINN:B
MM6 IBIAS IBIAS VDD VDD sg13_lv_pmos w={wbias} l={lbias} ng=1 m={m6}
MM7 net1 IBIAS VDD VDD sg13_lv_pmos w={wbias} l={lbias} ng=1 m={m7}
MM8 VOUT IBIAS VDD VDD sg13_lv_pmos w={wbias} l={lbias} ng=1 m={m8}
MM1 net2 VINN net1 VDD sg13_lv_pmos w={winpair} l={linpair} ng=1
MM2 net3 VINP net1 VDD sg13_lv_pmos w={winpair} l={linpair} ng=1
MM3 net2 net2 VSS VSS sg13_lv_nmos w={wload} l={lload} ng=1
MM4 net3 net2 VSS VSS sg13_lv_nmos w={wload} l={lload} ng=1
MM5 VOUT net3 VSS VSS sg13_lv_nmos w={wcs} l={lcs} ng=1
RR1 net3 net4 6.085k $SUB=VSS $[rhigh] w=0.5e-6 l=1.95e-6 b=0
.save v(vinp)
.save v(vinn)
.save v(vout)
CC2 VOUT net4 cap_cmomi w=15e-6 l=15e-6 m=9
**** begin user architecture code


.param temp=27
.param lbias=0.15u wbias=0.15u
.param m6=1 m7=4 m8=8
.param linpair=3u winpair=20u
.param lload=5u wload=10u
.param lcs=3u wcs=20u
.param Cc=2p


**** end user architecture code
.ends
