orpheus016/sg13cmos5l_spma_ip__instramp/simulations/tb_ota_cmos5l_ac.spice

** sch_path: /foss/designs/sg13cmos5l_spma_ip__instramp/xschem/ota_cmos5l/tb/tb_ota_cmos5l_ac/tb_ota_cmos5l_ac.sch
**.subckt tb_ota_cmos5l_ac
I1 I_B VSS {ib}
V5 VDD 0 {vdd}
V6 VSS 0 0
V1 VINP2 VSS {vicm}
C3 OUT2 VSS {cl}
x2 VSS I_B VDD VINN2 VINP2 OUT2 ota_cmos5l
X999 OUT2 VINN2 loopgainprobe
**** begin user architecture code



.lib cornerMOSlv.lib mos_tt
.lib cornerMOShv.lib mos_tt
.lib cornerRES.lib res_typ
.lib cornerDIO.lib dio_tt
.lib cornerCAP.lib cap_typ
.lib cornerMOSCAP.lib moscap_tt




.subckt loopgainprobe a b
Ii 0 x DC 0 AC 0
Vi x a DC 0 AC 1
Vnodebuffer b x 0
.ends loopgainprobe

.func tian_loop() {1/(1/(2*(ac1.i(v.x999.Vi)*ac2.v(x999.x)-ac1.v(x999.x)*ac2.i(v.x999.Vi))+ac1.v(x999.x)+ac2.i(v.x999.Vi))-1)}




.param temp=27
.param cl=3p
.param ib=1.4u
.param vdd=1.2
.param vicm=vdd/2
.param vid=0




.param temp=27
.param lbias=0.15u wbias=0.15u
.param m6=1 m7=4 m8=8
.param linpair=3u winpair=20u
.param lload=5u wload=10u
.param lcs=3u wcs=20u
.param Cc=2p




.control
save all
shell mkdir -p result

* 1st Injection: AC Voltage + 1st AC sim
alter i.x999.ii acmag=0
alter v.x999.vi acmag=1
ac dec 50 1 10G

* 2nd Injection: AC Current + 2nd AC sim
alter i.x999.ii acmag=1
alter v.x999.vi acmag=0
ac dec 50 1 10G

* Set default plot to 1st AC sim
setplot ac1

let t_gain = tian_loop()
let loop_mag = db(t_gain)
let loop_ph = 180 + (180 * cph(t_gain) / pi)

meas ac dc_gain find loop_mag at=10
let dc_gain_lin = 10^(dc_gain / 20)
let target_3db = dc_gain - 3
meas ac f_3db when loop_mag=target_3db
meas ac ph_3db find loop_ph when loop_mag=target_3db

meas ac ugbw when loop_mag=0
meas ac pm find loop_ph when loop_mag=0

meas ac f_180 when loop_ph=0
meas ac gain_margin find loop_mag when loop_ph=0
let gm_db=-gain_margin

let gbw_calc=dc_gain_lin * f_3db

write ./result/tb_cg_ota_ac.raw loop_mag loop_ph

echo "======================================================="
echo " DC Gain (dB): " $&dc_gain " dB"
echo " DC Gain (Lin): " $&dc_gain_lin " V/V"
echo " Bandwidth 3dB (f_3dB): " $&f_3db " Hz"
echo " Phase 3dB (f_3dB): " $&ph_3db " deg (Ideally, ~135 deg)"
echo " Unity-Gain BW (UGBW): " $&ugbw " Hz"
echo " Phase Margin (PM): " $&pm " deg (Ideally, > 60 deg)"
echo " Gain Margin (GM): " $&gm_db " dB"
echo " Phase Crossover (f_180): " $&f_180 " Hz"
echo " GBW Product (PM): " $&gbw_calc " Hz"


plot re(loop_mag) re(loop_ph) xlog

.endc

**** end user architecture code
**.ends

* expanding   symbol:  /foss/designs/sg13cmos5l_spma_ip__instramp/xschem/ota_cmos5l/ota_cmos5l.sym # of pins=6
** sym_path: /foss/designs/sg13cmos5l_spma_ip__instramp/xschem/ota_cmos5l/ota_cmos5l.sym
** sch_path: /foss/designs/sg13cmos5l_spma_ip__instramp/xschem/ota_cmos5l/ota_cmos5l.sch
.subckt ota_cmos5l VSS IBIAS VDD VINN VINP VOUT
*.iopin IBIAS
*.iopin VDD
*.iopin VSS
*.iopin VOUT
*.iopin VINP
*.iopin VINN
XM6 net1 net1 vdd vdd sg13_lv_pmos w={wbias} l={lbias} ng=1 m={m6} mm_ok=1
XM7 net5 net1 vdd vdd sg13_lv_pmos w={wbias} l={lbias} ng=1 m={m7} mm_ok=1
XM8 net6 net1 vdd vdd sg13_lv_pmos w={wbias} l={lbias} ng=1 m={m8} mm_ok=1
XM1 net7 VINN net2 vdd sg13_lv_pmos w={winpair} l={linpair} ng=1 m=1 mm_ok=1
XM2 net8 VINP net2 vdd sg13_lv_pmos w={winpair} l={linpair} ng=1 m=1 mm_ok=1
XM3 net3 net3 VSS VSS sg13_lv_nmos w={wload} l={lload} ng=1 m=1 mm_ok=1
XM4 net4 net3 VSS VSS sg13_lv_nmos w={wload} l={lload} ng=1 m=1 mm_ok=1
XM5 net9 net4 VSS VSS sg13_lv_nmos w={wcs} l={lcs} ng=1 m=1 mm_ok=1
XR1 net4 net10 vss rhigh w=0.5e-6 l=1.95e-6 m=1 b=0 mm_ok=1
VIBIAS net1 IBIAS 0
.save i(vibias)
VID7 net5 net2 0
.save i(vid7)
VID8 net6 VOUT 0
.save i(vid8)
.save v(vinp)
.save v(vinn)
.save v(vout)
VID1 net7 net3 0
.save i(vid1)
VID2 net8 net4 0
.save i(vid2)
VID5 VOUT net9 0
.save i(vid5)
XC2 net9 net10 cap_cmomi w=15e-6 l=15e-6 mmin=1 mmax=4 feed=double subblock=0 m=9 mm_ok=1
.ends

.GLOBAL VDD
.end
