orpheus016/sg13cmos5l_spma_ip__instramp/netlist/central_bias/pex/central_bias.spice

** post-layout RC netlist of central_bias: Magic extresist -> ngspice by scripts/pex_netlist.py --magic (source: /foss/designs/sg13cmos5l_spma_ip__instramp/runs/pex/central_bias/magic/raw.spice)
.subckt central_bias IB_IN IB_IA IB_BUF IB_G1 IB_G2 AVDD AVSS
X0 IB_G2_t4 pn1_t9 AVDD_t19 AVDD_t2 sg13_lv_pmos ad=0.68p pd=4.68u as=0.68p ps=4.68u w=2u l=2u
X1 pn1_t14 pn1_t9 AVDD_t29 AVDD_t15 sg13_lv_pmos ad=0.68p pd=4.68u as=0.68p ps=4.68u w=2u l=2u
X2 IB_G2_t1 pn1_t7 AVDD_t6 AVDD_t2 sg13_lv_pmos ad=0.68p pd=4.68u as=0.68p ps=4.68u w=2u l=2u
X3 pn1_t2 IB_IN_t2 AVSS_t89 AVSS_t88 sg13_lv_nmos ad=0.34p pd=2.68u as=0.34p ps=2.68u w=1u l=2u
X4 IB_IN_t5 IB_IN_t2 AVSS_t121 AVSS_t120 sg13_lv_nmos ad=0.34p pd=2.68u as=0.34p ps=2.68u w=1u l=2u
X5 pn1_t15 pn1_t7 AVDD_t14 AVDD_t11 sg13_lv_pmos ad=0.68p pd=4.68u as=0.68p ps=4.68u w=2u l=2u
X6 pn1_t5 IB_IN_t0 AVSS_t13 AVSS_t12 sg13_lv_nmos ad=0.34p pd=2.68u as=0.34p ps=2.68u w=1u l=2u
X7 IB_BUF_t6 IB_IN_t0 AVSS_t41 AVSS_t40 sg13_lv_nmos ad=0.34p pd=2.68u as=0.34p ps=2.68u w=1u l=2u
X8 IB_BUF_t2 IB_IN_t2 AVSS_t87 AVSS_t86 sg13_lv_nmos ad=0.34p pd=2.68u as=0.34p ps=2.68u w=1u l=2u
X9 IB_IA_t25 IB_IN_t0 AVSS_t29 AVSS_t28 sg13_lv_nmos ad=0.34p pd=2.68u as=0.34p ps=2.68u w=1u l=2u
X10 IB_IA_t19 IB_IN_t0 AVSS_t59 AVSS_t58 sg13_lv_nmos ad=0.34p pd=2.68u as=0.34p ps=2.68u w=1u l=2u
X11 pn1_t12 pn1_t9 AVDD_t3 AVDD_t2 sg13_lv_pmos ad=0.68p pd=4.68u as=0.68p ps=4.68u w=2u l=2u
X12 IB_IN_t7 IB_IN_t2 AVSS_t85 AVSS_t84 sg13_lv_nmos ad=0.34p pd=2.68u as=0.34p ps=2.68u w=1u l=2u
X13 IB_G1_t5 pn1_t9 AVDD_t26 AVDD_t11 sg13_lv_pmos ad=0.68p pd=4.68u as=0.68p ps=4.68u w=2u l=2u
X14 IB_IA_t4 IB_IN_t2 AVSS_t93 AVSS_t92 sg13_lv_nmos ad=0.34p pd=2.68u as=0.34p ps=2.68u w=1u l=2u
X15 IB_IN_t9 IB_IN_t0 AVSS_t11 AVSS_t10 sg13_lv_nmos ad=0.34p pd=2.68u as=0.34p ps=2.68u w=1u l=2u
X16 IB_IN_t11 IB_IN_t0 AVSS_t45 AVSS_t44 sg13_lv_nmos ad=0.34p pd=2.68u as=0.34p ps=2.68u w=1u l=2u
X17 IB_G1_t2 pn1_t7 AVDD_t10 AVDD_t0 sg13_lv_pmos ad=0.68p pd=4.68u as=0.68p ps=4.68u w=2u l=2u
X18 IB_IN_t8 IB_IN_t0 AVSS_t5 AVSS_t4 sg13_lv_nmos ad=0.34p pd=2.68u as=0.34p ps=2.68u w=1u l=2u
X19 IB_IA_t23 IB_IN_t0 AVSS_t27 AVSS_t26 sg13_lv_nmos ad=0.34p pd=2.68u as=0.34p ps=2.68u w=1u l=2u
X20 IB_IN_t1 IB_IN_t0 AVSS_t43 AVSS_t42 sg13_lv_nmos ad=0.34p pd=2.68u as=0.34p ps=2.68u w=1u l=2u
X21 IB_IA_t30 IB_IN_t0 AVSS_t57 AVSS_t56 sg13_lv_nmos ad=0.34p pd=2.68u as=0.34p ps=2.68u w=1u l=2u
X22 IB_IN_t6 IB_IN_t2 AVSS_t91 AVSS_t90 sg13_lv_nmos ad=0.34p pd=2.68u as=0.34p ps=2.68u w=1u l=2u
X23 IB_G2_t5 pn1_t9 AVDD_t20 AVDD_t0 sg13_lv_pmos ad=0.68p pd=4.68u as=0.68p ps=4.68u w=2u l=2u
X24 IB_IA_t0 IB_IN_t2 AVSS_t99 AVSS_t98 sg13_lv_nmos ad=0.34p pd=2.68u as=0.34p ps=2.68u w=1u l=2u
X25 IB_G2_t2 pn1_t7 AVDD_t9 AVDD_t0 sg13_lv_pmos ad=0.68p pd=4.68u as=0.68p ps=4.68u w=2u l=2u
X26 IB_IA_t1 IB_IN_t2 AVSS_t97 AVSS_t96 sg13_lv_nmos ad=0.34p pd=2.68u as=0.34p ps=2.68u w=1u l=2u
X27 pn1_t13 pn1_t7 AVDD_t16 AVDD_t15 sg13_lv_pmos ad=0.68p pd=4.68u as=0.68p ps=4.68u w=2u l=2u
X28 IB_BUF_t10 IB_IN_t0 AVSS_t3 AVSS_t2 sg13_lv_nmos ad=0.34p pd=2.68u as=0.34p ps=2.68u w=1u l=2u
X29 IB_BUF_t9 IB_IN_t0 AVSS_t33 AVSS_t32 sg13_lv_nmos ad=0.34p pd=2.68u as=0.34p ps=2.68u w=1u l=2u
X30 IB_IA_t28 IB_IN_t0 AVSS_t19 AVSS_t18 sg13_lv_nmos ad=0.34p pd=2.68u as=0.34p ps=2.68u w=1u l=2u
X31 IB_IA_t26 IB_IN_t0 AVSS_t37 AVSS_t36 sg13_lv_nmos ad=0.34p pd=2.68u as=0.34p ps=2.68u w=1u l=2u
X32 IB_IA_t10 IB_IN_t2 AVSS_t1 AVSS_t0 sg13_lv_nmos ad=0.34p pd=2.68u as=0.34p ps=2.68u w=1u l=2u
X33 IB_IA_t6 IB_IN_t2 AVSS_t95 AVSS_t94 sg13_lv_nmos ad=0.34p pd=2.68u as=0.34p ps=2.68u w=1u l=2u
X34 pn1_t17 pn1_t9 AVDD_t22 AVDD_t2 sg13_lv_pmos ad=0.68p pd=4.68u as=0.68p ps=4.68u w=2u l=2u
X35 IB_IA_t8 IB_IN_t2 AVSS_t103 AVSS_t102 sg13_lv_nmos ad=0.34p pd=2.68u as=0.34p ps=2.68u w=1u l=2u
X36 pn1_t8 pn1_t7 AVDD_t5 AVDD_t2 sg13_lv_pmos ad=0.68p pd=4.68u as=0.68p ps=4.68u w=2u l=2u
X37 IB_G1_t0 pn1_t7 AVDD_t18 AVDD_t15 sg13_lv_pmos ad=0.68p pd=4.68u as=0.68p ps=4.68u w=2u l=2u
X38 IB_G1_t6 pn1_t9 AVDD_t30 AVDD_t11 sg13_lv_pmos ad=0.68p pd=4.68u as=0.68p ps=4.68u w=2u l=2u
X39 IB_IA_t24 IB_IN_t0 AVSS_t35 AVSS_t34 sg13_lv_nmos ad=0.34p pd=2.68u as=0.34p ps=2.68u w=1u l=2u
X40 IB_IA_t16 IB_IN_t2 AVSS_t69 AVSS_t68 sg13_lv_nmos ad=0.34p pd=2.68u as=0.34p ps=2.68u w=1u l=2u
X41 IB_IA_t3 IB_IN_t2 AVSS_t101 AVSS_t100 sg13_lv_nmos ad=0.34p pd=2.68u as=0.34p ps=2.68u w=1u l=2u
X42 IB_G1_t3 pn1_t7 AVDD_t13 AVDD_t11 sg13_lv_pmos ad=0.68p pd=4.68u as=0.68p ps=4.68u w=2u l=2u
X43 IB_IN_t10 IB_IN_t0 AVSS_t17 AVSS_t16 sg13_lv_nmos ad=0.34p pd=2.68u as=0.34p ps=2.68u w=1u l=2u
X44 IB_IA_t18 IB_IN_t0 AVSS_t63 AVSS_t62 sg13_lv_nmos ad=0.34p pd=2.68u as=0.34p ps=2.68u w=1u l=2u
X45 IB_IA_t11 IB_IN_t2 AVSS_t67 AVSS_t66 sg13_lv_nmos ad=0.34p pd=2.68u as=0.34p ps=2.68u w=1u l=2u
X46 IB_IN_t3 IB_IN_t2 AVSS_t113 AVSS_t112 sg13_lv_nmos ad=0.34p pd=2.68u as=0.34p ps=2.68u w=1u l=2u
X47 IB_G1_t8 pn1_t9 AVDD_t21 AVDD_t2 sg13_lv_pmos ad=0.68p pd=4.68u as=0.68p ps=4.68u w=2u l=2u
X48 IB_IA_t15 IB_IN_t2 AVSS_t65 AVSS_t64 sg13_lv_nmos ad=0.34p pd=2.68u as=0.34p ps=2.68u w=1u l=2u
X49 IB_G1_t1 pn1_t7 AVDD_t4 AVDD_t2 sg13_lv_pmos ad=0.68p pd=4.68u as=0.68p ps=4.68u w=2u l=2u
X50 IB_G2_t8 pn1_t9 AVDD_t28 AVDD_t11 sg13_lv_pmos ad=0.68p pd=4.68u as=0.68p ps=4.68u w=2u l=2u
X51 IB_IA_t9 IB_IN_t2 AVSS_t107 AVSS_t106 sg13_lv_nmos ad=0.34p pd=2.68u as=0.34p ps=2.68u w=1u l=2u
X52 IB_G2_t0 pn1_t7 AVDD_t12 AVDD_t11 sg13_lv_pmos ad=0.68p pd=4.68u as=0.68p ps=4.68u w=2u l=2u
X53 IB_IA_t22 IB_IN_t0 AVSS_t31 AVSS_t30 sg13_lv_nmos ad=0.34p pd=2.68u as=0.34p ps=2.68u w=1u l=2u
X54 IB_BUF_t5 IB_IN_t0 AVSS_t39 AVSS_t38 sg13_lv_nmos ad=0.34p pd=2.68u as=0.34p ps=2.68u w=1u l=2u
X55 IB_IA_t31 IB_IN_t0 AVSS_t61 AVSS_t60 sg13_lv_nmos ad=0.34p pd=2.68u as=0.34p ps=2.68u w=1u l=2u
X56 IB_IA_t7 IB_IN_t2 AVSS_t105 AVSS_t104 sg13_lv_nmos ad=0.34p pd=2.68u as=0.34p ps=2.68u w=1u l=2u
X57 IB_BUF_t8 IB_IN_t0 AVSS_t9 AVSS_t8 sg13_lv_nmos ad=0.34p pd=2.68u as=0.34p ps=2.68u w=1u l=2u
X58 IB_IA_t20 IB_IN_t0 AVSS_t55 AVSS_t54 sg13_lv_nmos ad=0.34p pd=2.68u as=0.34p ps=2.68u w=1u l=2u
X59 IB_IA_t2 IB_IN_t2 AVSS_t73 AVSS_t72 sg13_lv_nmos ad=0.34p pd=2.68u as=0.34p ps=2.68u w=1u l=2u
X60 IB_IA_t21 IB_IN_t0 AVSS_t25 AVSS_t24 sg13_lv_nmos ad=0.34p pd=2.68u as=0.34p ps=2.68u w=1u l=2u
X61 IB_IA_t5 IB_IN_t2 AVSS_t71 AVSS_t70 sg13_lv_nmos ad=0.34p pd=2.68u as=0.34p ps=2.68u w=1u l=2u
X62 pn1_t3 IB_IN_t2 AVSS_t117 AVSS_t116 sg13_lv_nmos ad=0.34p pd=2.68u as=0.34p ps=2.68u w=1u l=2u
X63 pn1_t18 pn1_t9 AVDD_t27 AVDD_t11 sg13_lv_pmos ad=0.68p pd=4.68u as=0.68p ps=4.68u w=2u l=2u
X64 pn1_t11 pn1_t7 AVDD_t1 AVDD_t0 sg13_lv_pmos ad=0.68p pd=4.68u as=0.68p ps=4.68u w=2u l=2u
X65 pn1_t10 pn1_t9 AVDD_t23 AVDD_t0 sg13_lv_pmos ad=0.68p pd=4.68u as=0.68p ps=4.68u w=2u l=2u
X66 pn1 IB_IN_t0 AVSS_t7 AVSS_t6 sg13_lv_nmos ad=0.34p pd=2.68u as=0.34p ps=2.68u w=1u l=2u
X67 pn1_t0 IB_IN_t0 AVSS_t47 AVSS_t46 sg13_lv_nmos ad=0.34p pd=2.68u as=0.34p ps=2.68u w=1u l=2u
X68 IB_IA_t12 IB_IN_t2 AVSS_t79 AVSS_t78 sg13_lv_nmos ad=0.34p pd=2.68u as=0.34p ps=2.68u w=1u l=2u
X69 IB_BUF_t4 IB_IN_t2 AVSS_t109 AVSS_t108 sg13_lv_nmos ad=0.34p pd=2.68u as=0.34p ps=2.68u w=1u l=2u
X70 pn1_t16 pn1_t7 AVDD_t8 AVDD_t0 sg13_lv_pmos ad=0.68p pd=4.68u as=0.68p ps=4.68u w=2u l=2u
X71 IB_IA_t27 IB_IN_t0 AVSS_t23 AVSS_t22 sg13_lv_nmos ad=0.34p pd=2.68u as=0.34p ps=2.68u w=1u l=2u
X72 IB_IA_t17 IB_IN_t0 AVSS_t53 AVSS_t52 sg13_lv_nmos ad=0.34p pd=2.68u as=0.34p ps=2.68u w=1u l=2u
X73 IB_IA_t13 IB_IN_t2 AVSS_t77 AVSS_t76 sg13_lv_nmos ad=0.34p pd=2.68u as=0.34p ps=2.68u w=1u l=2u
X74 pn1_t6 IB_IN_t2 AVSS_t123 AVSS_t122 sg13_lv_nmos ad=0.34p pd=2.68u as=0.34p ps=2.68u w=1u l=2u
X75 IB_IA_t14 IB_IN_t2 AVSS_t75 AVSS_t74 sg13_lv_nmos ad=0.34p pd=2.68u as=0.34p ps=2.68u w=1u l=2u
X76 IB_BUF_t1 IB_IN_t2 AVSS_t111 AVSS_t110 sg13_lv_nmos ad=0.34p pd=2.68u as=0.34p ps=2.68u w=1u l=2u
X77 IB_G1_t7 pn1_t9 AVDD_t25 AVDD_t0 sg13_lv_pmos ad=0.68p pd=4.68u as=0.68p ps=4.68u w=2u l=2u
X78 IB_G1_t4 pn1_t7 AVDD_t7 AVDD_t2 sg13_lv_pmos ad=0.68p pd=4.68u as=0.68p ps=4.68u w=2u l=2u
X79 IB_G2_t7 pn1_t9 AVDD_t31 AVDD_t15 sg13_lv_pmos ad=0.68p pd=4.68u as=0.68p ps=4.68u w=2u l=2u
X80 IB_IA_t29 IB_IN_t0 AVSS_t21 AVSS_t20 sg13_lv_nmos ad=0.34p pd=2.68u as=0.34p ps=2.68u w=1u l=2u
X81 IB_IA_t32 IB_IN_t0 AVSS_t51 AVSS_t50 sg13_lv_nmos ad=0.34p pd=2.68u as=0.34p ps=2.68u w=1u l=2u
X82 IB_BUF_t3 IB_IN_t2 AVSS_t83 AVSS_t82 sg13_lv_nmos ad=0.34p pd=2.68u as=0.34p ps=2.68u w=1u l=2u
X83 IB_IN_t4 IB_IN_t2 AVSS_t115 AVSS_t114 sg13_lv_nmos ad=0.34p pd=2.68u as=0.34p ps=2.68u w=1u l=2u
X84 IB_G2_t3 pn1_t7 AVDD_t17 AVDD_t11 sg13_lv_pmos ad=0.68p pd=4.68u as=0.68p ps=4.68u w=2u l=2u
X85 IB_BUF_t7 IB_IN_t0 AVSS_t15 AVSS_t14 sg13_lv_nmos ad=0.34p pd=2.68u as=0.34p ps=2.68u w=1u l=2u
X86 pn1_t1 IB_IN_t0 AVSS_t49 AVSS_t48 sg13_lv_nmos ad=0.34p pd=2.68u as=0.34p ps=2.68u w=1u l=2u
X87 IB_G2_t6 pn1_t9 AVDD_t24 AVDD_t0 sg13_lv_pmos ad=0.68p pd=4.68u as=0.68p ps=4.68u w=2u l=2u
X88 pn1_t4 IB_IN_t2 AVSS_t81 AVSS_t80 sg13_lv_nmos ad=0.34p pd=2.68u as=0.34p ps=2.68u w=1u l=2u
X89 IB_BUF_t0 IB_IN_t2 AVSS_t119 AVSS_t118 sg13_lv_nmos ad=0.34p pd=2.68u as=0.34p ps=2.68u w=1u l=2u
R0 IB_IA_n0 IB_IA_t10 16.698
R1 IB_IA_n8 IB_IA_t28 16.2305
R2 IB_IA_n31 IB_IA_t18 16.2301
R3 IB_IA_n30 IB_IA_t31 16.2301
R4 IB_IA_n29 IB_IA_t19 16.2301
R5 IB_IA_n28 IB_IA_t30 16.2301
R6 IB_IA_n27 IB_IA_t20 16.2301
R7 IB_IA_n26 IB_IA_t17 16.2301
R8 IB_IA_n25 IB_IA_t32 16.2301
R9 IB_IA_n24 IB_IA_t26 16.2301
R10 IB_IA_n23 IB_IA_t24 16.2301
R11 IB_IA_n14 IB_IA_t22 16.2301
R12 IB_IA_n13 IB_IA_t25 16.2301
R13 IB_IA_n12 IB_IA_t23 16.2301
R14 IB_IA_n11 IB_IA_t21 16.2301
R15 IB_IA_n10 IB_IA_t27 16.2301
R16 IB_IA_n9 IB_IA_t29 16.2301
R17 IB_IA_n22 IB_IA_t9 15.818
R18 IB_IA_n21 IB_IA_t7 15.818
R19 IB_IA_n20 IB_IA_t8 15.818
R20 IB_IA_n19 IB_IA_t3 15.818
R21 IB_IA_n18 IB_IA_t0 15.818
R22 IB_IA_n17 IB_IA_t1 15.818
R23 IB_IA_n16 IB_IA_t6 15.818
R24 IB_IA_n15 IB_IA_t4 15.818
R25 IB_IA_n7 IB_IA_t12 15.818
R26 IB_IA_n6 IB_IA_t13 15.818
R27 IB_IA_n5 IB_IA_t14 15.818
R28 IB_IA_n4 IB_IA_t2 15.818
R29 IB_IA_n3 IB_IA_t5 15.818
R30 IB_IA_n2 IB_IA_t16 15.818
R31 IB_IA_n1 IB_IA_t11 15.818
R32 IB_IA_n0 IB_IA_t15 15.818
R33 IB_IA IB_IA_n31 9.73383
R34 IB_IA_n1 IB_IA_n0 0.8805
R35 IB_IA_n2 IB_IA_n1 0.8805
R36 IB_IA_n3 IB_IA_n2 0.8805
R37 IB_IA_n4 IB_IA_n3 0.8805
R38 IB_IA_n5 IB_IA_n4 0.8805
R39 IB_IA_n6 IB_IA_n5 0.8805
R40 IB_IA_n7 IB_IA_n6 0.8805
R41 IB_IA_n9 IB_IA_n8 0.8805
R42 IB_IA_n10 IB_IA_n9 0.8805
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
C204 IB_IA_t15 AVSS 0.21979f
C205 IB_IA_n0 AVSS 0.61099f
C206 IB_IA_t11 AVSS 0.21979f
C207 IB_IA_n1 AVSS 0.38536f
C208 IB_IA_t16 AVSS 0.21979f
C209 IB_IA_n2 AVSS 0.38536f
C210 IB_IA_t5 AVSS 0.21979f
C211 IB_IA_n3 AVSS 0.38536f
C212 IB_IA_t2 AVSS 0.21979f
C213 IB_IA_n4 AVSS 0.38536f
C214 IB_IA_t14 AVSS 0.21979f
C215 IB_IA_n5 AVSS 0.38536f
C216 IB_IA_t13 AVSS 0.21979f
C217 IB_IA_n6 AVSS 0.38536f
C218 IB_IA_t12 AVSS 0.21979f
C219 IB_IA_n7 AVSS 0.30479f
C220 IB_IA_t28 AVSS 0.24019f
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
