orpheus016/sg13cmos5l_spma_ip__instramp/netlist/gain_network/pex/gain_network.c.spice

** post-layout netlist of gain_network: kpex -> ngspice by scripts/pex_netlist.py (source: /foss/designs/sg13cmos5l_spma_ip__instramp/runs/pex/gain_network/kpex/gain_network__gain_network/gain_network_k25d_pex_netlist.spice)
.subckt gain_network S4 S5 S0 S2 S1 S3 AVDD V_CM V_IN2 V_OUT2 I_BIAS AVSS
XM_1 n248 S1 n213 AVSS sg13_lv_nmos L=0.13U W=0.3U AS=0.102P AD=0.102P PS=1.28U PD=1.28U rfmode=0
XM_2 n252 S5 n213 AVSS sg13_lv_nmos L=0.13U W=0.18U AS=0.1026P AD=0.1026P PS=1.34U PD=1.34U rfmode=0
XM_3 n251 S4 n213 AVSS sg13_lv_nmos L=0.13U W=0.18U AS=0.1026P AD=0.1026P PS=1.34U PD=1.34U rfmode=0
XM_4 n254 S0 n213 AVSS sg13_lv_nmos L=0.13U W=0.4U AS=0.136P AD=0.136P PS=1.48U PD=1.48U rfmode=0
XM_5 n250 S3 n213 AVSS sg13_lv_nmos L=0.13U W=0.18U AS=0.1026P AD=0.1026P PS=1.34U PD=1.34U rfmode=0
XM_6 n230 S5 AVSS AVSS sg13_lv_nmos L=0.13U W=0.74U AS=0.2516P AD=0.2516P PS=2.16U PD=2.16U rfmode=0
XM_7 n228 S4 AVSS AVSS sg13_lv_nmos L=0.13U W=0.74U AS=0.2516P AD=0.2516P PS=2.16U PD=2.16U rfmode=0
XM_8 n226 S3 AVSS AVSS sg13_lv_nmos L=0.13U W=0.74U AS=0.2516P AD=0.2516P PS=2.16U PD=2.16U rfmode=0
XM_9 n249 S2 n213 AVSS sg13_lv_nmos L=0.13U W=0.2U AS=0.104P AD=0.104P PS=1.34U PD=1.34U rfmode=0
XM_10 n224 S2 AVSS AVSS sg13_lv_nmos L=0.13U W=0.74U AS=0.2516P AD=0.2516P PS=2.16U PD=2.16U rfmode=0
XM_11 n222 S1 AVSS AVSS sg13_lv_nmos L=0.13U W=0.74U AS=0.2516P AD=0.2516P PS=2.16U PD=2.16U rfmode=0
XM_12 n220 S0 AVSS AVSS sg13_lv_nmos L=0.13U W=0.74U AS=0.2516P AD=0.2516P PS=2.16U PD=2.16U rfmode=0
XM_13 n44 n196 n69 AVSS sg13_lv_nmos L=0.5U W=0.84U AS=0.2856P AD=0.2856P PS=2.36U PD=2.36U rfmode=0
XM_14 AVSS I_BIAS I_BIAS AVSS sg13_lv_nmos L=2U W=0.87U AS=0.2958P AD=0.2958P PS=2.42U PD=2.42U rfmode=0
XM_15 n86 n24 n26 AVSS sg13_lv_nmos L=2U W=6.41U AS=2.1794P AD=2.1794P PS=13.5U PD=13.5U rfmode=0
XM_16 n33 n25 AVSS AVSS sg13_lv_nmos L=2U W=9.21U AS=3.1314P AD=3.1314P PS=19.1U PD=19.1U rfmode=0
XM_17 n215 I_BIAS AVSS AVSS sg13_lv_nmos L=2U W=6U AS=2.04P AD=2.04P PS=12.68U PD=12.68U rfmode=0
XM_18 n33 n24 n44 AVSS sg13_lv_nmos L=2U W=6.41U AS=2.1794P AD=2.1794P PS=13.5U PD=13.5U rfmode=0
XM_19 n25 n25 AVSS AVSS sg13_lv_nmos L=2U W=9.21U AS=3.1314P AD=3.1314P PS=19.1U PD=19.1U rfmode=0
XM_20 n153 I_BIAS AVSS AVSS sg13_lv_nmos L=2U W=0.87U AS=0.2958P AD=0.2958P PS=2.42U PD=2.42U rfmode=0
XM_21 n196 n196 n93 AVSS sg13_lv_nmos L=0.5U W=0.84U AS=0.2856P AD=0.2856P PS=2.36U PD=2.36U rfmode=0
XM_22 AVSS n25 n26 AVSS sg13_lv_nmos L=2U W=9.21U AS=3.1314P AD=3.1314P PS=19.1U PD=19.1U rfmode=0
XM_23 n69 I_BIAS AVSS AVSS sg13_lv_nmos L=2U W=3.2U AS=1.088P AD=1.088P PS=7.08U PD=7.08U rfmode=0
XM_24 n24 n24 n10 AVSS sg13_lv_nmos L=2U W=1.6U AS=0.544P AD=0.544P PS=3.88U PD=3.88U rfmode=0
XM_25 V_OUT2 n69 AVSS AVSS sg13_lv_nmos L=0.5U W=8.4U AS=2.856P AD=2.856P PS=17.48U PD=17.48U rfmode=0
XM_26 n100 I_BIAS AVSS AVSS sg13_lv_nmos L=2U W=1.74U AS=0.5916P AD=0.5916P PS=4.16U PD=4.16U rfmode=0
XM_27 n93 n93 AVSS AVSS sg13_lv_nmos L=0.5U W=2.1U AS=0.714P AD=0.714P PS=4.88U PD=4.88U rfmode=0
XM_28 n145 n100 n100 AVDD sg13_lv_pmos L=0.5U W=2.2U AS=0.748P AD=0.748P PS=5.08U PD=5.08U rfmode=0
XM_29 AVDD n145 n145 AVDD sg13_lv_pmos L=0.5U W=5.55U AS=1.887P AD=1.887P PS=11.78U PD=11.78U rfmode=0
XM_30 n25 n153 AVDD AVDD sg13_lv_pmos L=2U W=5.75U AS=1.955P AD=1.0925P PS=12.18U PD=6.13U rfmode=0
XM_31 AVDD n153 n25 AVDD sg13_lv_pmos L=2U W=5.75U AS=1.0925P AD=1.0925P PS=6.13U PD=6.13U rfmode=0
XM_32 n25 n153 AVDD AVDD sg13_lv_pmos L=2U W=5.75U AS=1.0925P AD=1.0925P PS=6.13U PD=6.13U rfmode=0
XM_33 AVDD n153 n25 AVDD sg13_lv_pmos L=2U W=5.75U AS=1.0925P AD=1.955P PS=6.13U PD=12.18U rfmode=0
XM_34 n33 V_CM n142 AVDD sg13_lv_pmos L=2U W=6.64U AS=2.2576P AD=1.2616P PS=13.96U PD=7.02U rfmode=0
XM_35 n142 V_CM n33 AVDD sg13_lv_pmos L=2U W=6.64U AS=1.2616P AD=1.2616P PS=7.02U PD=7.02U rfmode=0
XM_36 n33 V_CM n142 AVDD sg13_lv_pmos L=2U W=6.64U AS=1.2616P AD=1.2616P PS=7.02U PD=7.02U rfmode=0
XM_37 n142 V_CM n33 AVDD sg13_lv_pmos L=2U W=6.64U AS=1.2616P AD=2.2576P PS=7.02U PD=13.96U rfmode=0
XM_38 AVDD n86 n44 AVDD sg13_lv_pmos L=2U W=7.33U AS=2.4922P AD=2.4922P PS=15.34U PD=15.34U rfmode=0
XM_39 AVDD n153 n153 AVDD sg13_lv_pmos L=2U W=2.3U AS=0.782P AD=0.782P PS=5.28U PD=5.28U rfmode=0
XM_40 AVDD n86 n86 AVDD sg13_lv_pmos L=2U W=7.33U AS=2.4922P AD=2.4922P PS=15.34U PD=15.34U rfmode=0
XM_41 AVDD n153 n44 AVDD sg13_lv_pmos L=2U W=9.21U AS=3.1314P AD=3.1314P PS=19.1U PD=19.1U rfmode=0
XM_42 V_OUT2 n44 AVDD AVDD sg13_lv_pmos L=0.5U W=5.55U AS=1.887P AD=1.0545P PS=11.78U PD=5.93U rfmode=0
XM_43 AVDD n44 V_OUT2 AVDD sg13_lv_pmos L=0.5U W=5.55U AS=1.0545P AD=1.0545P PS=5.93U PD=5.93U rfmode=0
XM_44 V_OUT2 n44 AVDD AVDD sg13_lv_pmos L=0.5U W=5.55U AS=1.0545P AD=1.0545P PS=5.93U PD=5.93U rfmode=0
XM_45 AVDD n44 V_OUT2 AVDD sg13_lv_pmos L=0.5U W=5.55U AS=1.0545P AD=1.887P PS=5.93U PD=11.78U rfmode=0
XM_46 n24 n153 AVDD AVDD sg13_lv_pmos L=2U W=5.75U AS=1.955P AD=1.0925P PS=12.18U PD=6.13U rfmode=0
XM_47 AVDD n153 n24 AVDD sg13_lv_pmos L=2U W=5.75U AS=1.0925P AD=1.955P PS=6.13U PD=12.18U rfmode=0
XM_48 n26 n213 n142 AVDD sg13_lv_pmos L=2U W=6.64U AS=2.2576P AD=1.2616P PS=13.96U PD=7.02U rfmode=0
XM_49 n142 n213 n26 AVDD sg13_lv_pmos L=2U W=6.64U AS=1.2616P AD=1.2616P PS=7.02U PD=7.02U rfmode=0
XM_50 n26 n213 n142 AVDD sg13_lv_pmos L=2U W=6.64U AS=1.2616P AD=1.2616P PS=7.02U PD=7.02U rfmode=0
XM_51 n142 n213 n26 AVDD sg13_lv_pmos L=2U W=6.64U AS=1.2616P AD=2.2576P PS=7.02U PD=13.96U rfmode=0
XM_52 n44 n100 n69 AVDD sg13_lv_pmos L=0.5U W=2.2U AS=0.748P AD=0.748P PS=5.08U PD=5.08U rfmode=0
XM_53 AVDD n215 n215 AVDD sg13_lv_pmos L=2U W=7.46U AS=2.5364P AD=2.5364P PS=15.6U PD=15.6U rfmode=0
XM_54 AVDD n215 n215 AVDD sg13_lv_pmos L=2U W=7.46U AS=2.5364P AD=2.5364P PS=15.6U PD=15.6U rfmode=0
XM_55 AVDD n215 n215 AVDD sg13_lv_pmos L=2U W=7.46U AS=2.5364P AD=2.5364P PS=15.6U PD=15.6U rfmode=0
XM_56 AVDD n153 n196 AVDD sg13_lv_pmos L=2U W=4.6U AS=1.564P AD=1.564P PS=9.88U PD=9.88U rfmode=0
XM_57 AVDD n215 n215 AVDD sg13_lv_pmos L=2U W=7.46U AS=2.5364P AD=2.5364P PS=15.6U PD=15.6U rfmode=0
XM_58 AVDD n215 n215 AVDD sg13_lv_pmos L=2U W=7.46U AS=2.5364P AD=2.5364P PS=15.6U PD=15.6U rfmode=0
XM_59 AVDD n215 n215 AVDD sg13_lv_pmos L=2U W=7.46U AS=2.5364P AD=2.5364P PS=15.6U PD=15.6U rfmode=0
XM_60 AVDD n215 n215 AVDD sg13_lv_pmos L=2U W=7.46U AS=2.5364P AD=2.5364P PS=15.6U PD=15.6U rfmode=0
XM_61 AVDD n215 n215 AVDD sg13_lv_pmos L=2U W=7.46U AS=2.5364P AD=2.5364P PS=15.6U PD=15.6U rfmode=0
XM_62 AVDD n215 n142 AVDD sg13_lv_pmos L=2U W=7.46U AS=2.5364P AD=2.5364P PS=15.6U PD=15.6U rfmode=0
XM_63 AVDD n215 n142 AVDD sg13_lv_pmos L=2U W=7.46U AS=2.5364P AD=2.5364P PS=15.6U PD=15.6U rfmode=0
XM_64 AVDD n215 n142 AVDD sg13_lv_pmos L=2U W=7.46U AS=2.5364P AD=2.5364P PS=15.6U PD=15.6U rfmode=0
XM_65 AVDD n215 n142 AVDD sg13_lv_pmos L=2U W=7.46U AS=2.5364P AD=2.5364P PS=15.6U PD=15.6U rfmode=0
XM_66 AVDD n215 n142 AVDD sg13_lv_pmos L=2U W=7.46U AS=2.5364P AD=2.5364P PS=15.6U PD=15.6U rfmode=0
XM_67 AVDD n215 n142 AVDD sg13_lv_pmos L=2U W=7.46U AS=2.5364P AD=2.5364P PS=15.6U PD=15.6U rfmode=0
XM_68 AVDD n215 n142 AVDD sg13_lv_pmos L=2U W=7.46U AS=2.5364P AD=2.5364P PS=15.6U PD=15.6U rfmode=0
XM_69 AVDD n215 n142 AVDD sg13_lv_pmos L=2U W=7.46U AS=2.5364P AD=2.5364P PS=15.6U PD=15.6U rfmode=0
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
Cext_299 n86 V_CM 11.1852a
Cext_300 n86 V_OUT2 226.71a
Cext_301 n86 VSS 6.63988f
Cext_302 n93 AVSS 486.445a
Cext_303 n93 I_BIAS 15.8842a
Cext_304 n93 VSS 666.921a
Cext_305 AVDD AVSS 1.06664f
Cext_306 AVDD I_BIAS 3.55288a
Cext_307 AVDD S0 97.8477a
Cext_308 AVDD S1 388.083a
Cext_309 AVDD S2 95.2532a
Cext_310 AVDD S3 93.1834a
Cext_311 AVDD S4 687.661a
Cext_312 AVDD S5 93.4982a
Cext_313 AVDD V_CM 651.897a
Cext_314 AVDD V_OUT2 1.22741f
Cext_315 AVDD VSS 40.4833f
Cext_316 AVSS I_BIAS 2.77241f
Cext_317 AVSS S0 451.307a
Cext_318 AVSS S1 663.382a
Cext_319 AVSS S2 475.399a
Cext_320 AVSS S3 336.978a
Cext_321 AVSS S4 775.847a
Cext_322 AVSS S5 329.172a
Cext_323 AVSS V_CM 1.04573a
Cext_324 AVSS V_OUT2 1.01542f
Cext_325 AVSS VSS 37.9377f
Cext_326 I_BIAS VSS 7.89253f
Cext_327 S0 S1 402.407a
Cext_328 S0 S2 2.7886a
Cext_329 S0 S3 0.328222a
Cext_330 S0 S4 0.159857a
Cext_331 S0 S5 0.127055a
Cext_332 S0 VSS 1.14614f
Cext_333 S1 S2 2.16823a
Cext_334 S1 S3 0.111263a
Cext_335 S1 VSS 1.55221f
Cext_336 S2 S3 2.69198f
Cext_337 S2 S4 5.47575a
Cext_338 S2 S5 1.22024a
Cext_339 S2 VSS 2.08321f
Cext_340 S3 S4 4.27911f
Cext_341 S3 S5 4.77813a
Cext_342 S3 VSS 2.81495f
Cext_343 S4 S5 3.39387f
Cext_344 S4 VSS 3.20682f
Cext_345 S5 VSS 5.97027f
Cext_346 V_CM V_IN2 19.8228a
Cext_347 V_CM V_OUT2 164.907a
Cext_348 VSS V_CM 8.88998f
Cext_349 VSS V_IN2 764.099a
Cext_350 VSS V_OUT2 14.4199f
.ends gain_network
