orpheus016/sg13cmos5l_spma_ip__instramp/netlist/gain_network/pex/gain_network.rc.spice

** post-layout RC netlist of gain_network: Magic extresist -> ngspice by scripts/pex_netlist.py --magic (source: /foss/designs/sg13cmos5l_spma_ip__instramp/runs/pex/gain_network/magic/raw.spice)
.subckt gain_network S4 S5 S0 S2 S1 S3 AVDD V_CM V_IN2 V_OUT2 I_BIAS AVSS
X0 pn16_t0 S5_t0 AVSS_t17 AVSS_t16 sg13_lv_nmos ad=0.2516p pd=2.16u as=0.2516p ps=2.16u w=0.74u l=0.13u
X1 AVDD_t11 pn12_t3 pn7_t0 AVDD_t8 sg13_lv_pmos ad=1.955p pd=12.18u as=1.0925p ps=6.13u w=5.75u l=2u
X2 pn27_t4 pn28_t2 pn2_t1 AVSS_t35 sg13_lv_nmos ad=0.2856p pd=2.36u as=0.2856p ps=2.36u w=0.84u l=0.5u
X3 pn26_t0 pn7_t3 AVSS_t41 AVSS_t40 sg13_lv_nmos ad=3.1314p pd=19.1u as=3.1314p ps=19.1u w=9.21u l=2u
X4 pn15_t1 S4_t0 AVDD_t23 AVDD_t22 sg13_lv_pmos ad=0.3808p pd=2.92u as=0.3808p ps=2.92u w=1.12u l=0.13u
X5 pn27_t2 pn10_t2 pn2_t0 AVDD_t53 sg13_lv_pmos ad=0.748p pd=5.08u as=0.748p ps=5.08u w=2.2u l=0.5u
X6 pn26 V_CM_t0 pn24 AVDD_t21 sg13_lv_pmos ad=1.2616p pd=7.02u as=2.2576p ps=13.96u w=6.64u l=2u
X7 AVSS_t2 pn1_t0 AVSS_t1 rhigh l=15u w=0.5u ps=0 b=0 m=1
X8 pn24_t1 pn13_t12 pn29 AVDD_t21 sg13_lv_pmos ad=1.2616p pd=7.02u as=1.2616p ps=7.02u w=6.64u l=2u
X9 pn25_t0 pn10 pn10_t0 AVDD_t15 sg13_lv_pmos ad=0.748p pd=5.08u as=0.748p ps=5.08u w=2.2u l=0.5u
X10 pn23_t0 pn4_t1 AVSS_t54 rhigh l=54u w=0.5u ps=0 b=0 m=1
X11 pn12_t2 I_BIAS_t5 AVSS_t45 AVSS_t44 sg13_lv_nmos ad=0.2958p pd=2.42u as=0.2958p ps=2.42u w=0.87u l=2u
X12 pn27_t0 pn8 AVSS_t3 rhigh l=4u w=0.5u ps=0 b=0 m=1
X13 pn20_t0 pn21 AVSS_t4 rhigh l=13.42u w=0.5u ps=0 b=0 m=1
X14 AVDD_t31 pn30_t10 pn30_t11 AVDD_t30 sg13_lv_pmos ad=2.5364p pd=15.6u as=2.5364p ps=15.6u w=7.46u l=2u
X15 AVDD_t32 pn30_t0 pn30_t1 AVDD_t15 sg13_lv_pmos ad=2.5364p pd=15.6u as=2.5364p ps=15.6u w=7.46u l=2u
X16 pn29_t0 pn13_t12 pn24_t1 AVDD_t21 sg13_lv_pmos ad=1.2616p pd=7.02u as=1.2616p ps=7.02u w=6.64u l=2u
X17 AVDD_t49 pn30_t19 pn24_t10 AVDD_t47 sg13_lv_pmos ad=2.5364p pd=15.6u as=2.5364p ps=15.6u w=7.46u l=2u
X18 V_OUT2_t2 pn27_t5 AVDD_t57 AVDD_t56 sg13_lv_pmos ad=1.0545p pd=5.93u as=1.887p ps=11.78u w=5.55u l=0.5u
X19 V_OUT2_t3 pn27_t5 AVDD_t58 AVDD_t59 sg13_lv_pmos ad=1.0545p pd=5.93u as=1.0545p ps=5.93u w=5.55u l=0.5u
X20 pn7_t1 pn12_t3 AVDD_t18 AVDD_t8 sg13_lv_pmos ad=1.0925p pd=6.13u as=1.955p ps=12.18u w=5.75u l=2u
X21 AVDD_t52 pn30_t16 pn24_t7 AVDD_t47 sg13_lv_pmos ad=2.5364p pd=15.6u as=2.5364p ps=15.6u w=7.46u l=2u
X22 pn21_t0 pn22_t0 AVSS_t12 rhigh l=26.95u w=0.5u ps=0 b=0 m=1
X23 pn4_t0 pn16 pn13_t11 AVDD_t2 sg13_lv_pmos ad=0.1836p pd=1.76u as=0.1836p ps=1.76u w=0.54u l=0.13u
X24 pn15_t0 S4_t0 AVSS_t26 AVSS_t25 sg13_lv_nmos ad=0.2516p pd=2.16u as=0.2516p ps=2.16u w=0.74u l=0.13u
X25 pn20_t1 pn17 pn13_t8 AVDD_t24 sg13_lv_pmos ad=0.306p pd=2.48u as=0.306p ps=2.48u w=0.9u l=0.13u
X26 pn3 S4_t1 pn13_t6 AVSS_t24 sg13_lv_nmos ad=0.1026p pd=1.34u as=0.1026p ps=1.34u w=0.18u l=0.13u
X27 pn19_t1 S0_t0 AVDD_t1 AVDD_t0 sg13_lv_pmos ad=0.3808p pd=2.92u as=0.3808p ps=2.92u w=1.12u l=0.13u
X28 pn18_t0 S2_t0 AVDD_t5 AVDD_t4 sg13_lv_pmos ad=0.3808p pd=2.92u as=0.3808p ps=2.92u w=1.12u l=0.13u
X29 pn13 V_IN2_t0 AVSS_t0 rhigh l=6.66u w=0.5u ps=0 b=0 m=1
X30 AVDD_t64 pn11_t1 pn11_t2 AVDD_t62 sg13_lv_pmos ad=2.4922p pd=15.34u as=2.4922p ps=15.34u w=7.33u l=2u
X31 pn14_t1 S3_t0 AVDD_t20 AVDD_t19 sg13_lv_pmos ad=0.3808p pd=2.92u as=0.3808p ps=2.92u w=1.12u l=0.13u
X32 AVDD_t48 pn30_t20 pn24_t8 AVDD_t47 sg13_lv_pmos ad=2.5364p pd=15.6u as=2.5364p ps=15.6u w=7.46u l=2u
X33 pn5 S0_t1 pn13_t1 AVSS_t8 sg13_lv_nmos ad=0.136p pd=1.48u as=0.136p ps=1.48u w=0.4u l=0.13u
X34 pn5_t1 V_OUT2_t0 AVSS_t6 rhigh l=3.2u w=0.5u ps=0 b=0 m=1
X35 pn11_t0 pn6_t3 pn29_t1 AVSS_t28 sg13_lv_nmos ad=2.1794p pd=13.5u as=2.1794p ps=13.5u w=6.41u l=2u
X36 AVDD_t16 pn12_t0 pn12_t1 AVDD_t15 sg13_lv_pmos ad=0.782p pd=5.28u as=0.782p ps=5.28u w=2.3u l=2u
X37 pn21_t1 S2_t1 pn13_t2 AVSS_t18 sg13_lv_nmos ad=0.104p pd=1.34u as=0.104p ps=1.34u w=0.2u l=0.13u
X38 pn17_t0 S1_t0 AVDD_t25 AVDD_t24 sg13_lv_pmos ad=0.3808p pd=2.92u as=0.3808p ps=2.92u w=1.12u l=0.13u
X39 AVDD_t55 pn25_t1 pn25_t2 AVDD_t54 sg13_lv_pmos ad=1.887p pd=11.78u as=1.887p ps=11.78u w=5.55u l=0.5u
X40 pn6_t1 pn6 pn1 AVSS_t27 sg13_lv_nmos ad=0.544p pd=3.88u as=0.544p ps=3.88u w=1.6u l=2u
X41 AVDD_t34 pn30_t23 pn24_t6 AVDD_t33 sg13_lv_pmos ad=2.5364p pd=15.6u as=2.5364p ps=15.6u w=7.46u l=2u
X42 pn24_t12 V_CM_t0 pn26 AVDD_t21 sg13_lv_pmos ad=1.2616p pd=7.02u as=1.2616p ps=7.02u w=6.64u l=2u
X43 AVSS_t39 pn7_t4 pn29_t2 AVSS_t38 sg13_lv_nmos ad=3.1314p pd=19.1u as=3.1314p ps=19.1u w=9.21u l=2u
X44 pn23 pn3_t0 AVSS_t7 rhigh l=54u w=0.5u ps=0 b=0 m=1
X45 pn19_t0 S0_t0 AVSS_t10 AVSS_t9 sg13_lv_nmos ad=0.2516p pd=2.16u as=0.2516p ps=2.16u w=0.74u l=0.13u
X46 pn18_t1 S2_t0 AVSS_t20 AVSS_t19 sg13_lv_nmos ad=0.2516p pd=2.16u as=0.2516p ps=2.16u w=0.74u l=0.13u
X47 pn14_t0 S3_t0 AVSS_t23 AVSS_t22 sg13_lv_nmos ad=0.2516p pd=2.16u as=0.2516p ps=2.16u w=0.74u l=0.13u
X48 AVDD_t9 pn12_t4 pn6_t0 AVDD_t8 sg13_lv_pmos ad=1.955p pd=12.18u as=1.0925p ps=6.13u w=5.75u l=2u
X49 pn24_t0 pn13_t12 pn29_t0 AVDD_t21 sg13_lv_pmos ad=2.2576p pd=13.96u as=1.2616p ps=7.02u w=6.64u l=2u
X50 AVDD_t14 pn12 pn27 AVDD_t13 sg13_lv_pmos ad=3.1314p pd=19.1u as=3.1314p ps=19.1u w=9.21u l=2u
X51 pn28_t1 pn28_t0 pn9_t0 AVSS_t34 sg13_lv_nmos ad=0.2856p pd=2.36u as=0.2856p ps=2.36u w=0.84u l=0.5u
X52 pn21_t2 pn18 pn13_t7 AVDD_t4 sg13_lv_pmos ad=0.204p pd=1.88u as=0.204p ps=1.88u w=0.6u l=0.13u
X53 AVDD_t36 pn30_t6 pn30_t7 AVDD_t35 sg13_lv_pmos ad=2.5364p pd=15.6u as=2.5364p ps=15.6u w=7.46u l=2u
X54 AVDD_t12 pn12_t3 pn7_t1 AVDD_t8 sg13_lv_pmos ad=1.0925p pd=6.13u as=1.0925p ps=6.13u w=5.75u l=2u
X55 pn17_t1 S1_t0 AVSS_t31 AVSS_t30 sg13_lv_nmos ad=0.2516p pd=2.16u as=0.2516p ps=2.16u w=0.74u l=0.13u
X56 AVDD_t38 pn30_t4 pn30_t5 AVDD_t37 sg13_lv_pmos ad=2.5364p pd=15.6u as=2.5364p ps=15.6u w=7.46u l=2u
X57 AVDD_t40 pn30_t12 pn30_t13 AVDD_t39 sg13_lv_pmos ad=2.5364p pd=15.6u as=2.5364p ps=15.6u w=7.46u l=2u
X58 AVDD_t50 pn30_t18 pn24_t9 AVDD_t47 sg13_lv_pmos ad=2.5364p pd=15.6u as=2.5364p ps=15.6u w=7.46u l=2u
X59 AVDD_t51 pn30_t17 pn24_t3 AVDD_t47 sg13_lv_pmos ad=2.5364p pd=15.6u as=2.5364p ps=15.6u w=7.46u l=2u
X60 pn10_t1 I_BIAS_t4 AVSS_t51 AVSS_t50 sg13_lv_nmos ad=0.5916p pd=4.16u as=0.5916p ps=4.16u w=1.74u l=2u
X61 pn7_t2 pn7 AVSS_t37 AVSS_t36 sg13_lv_nmos ad=3.1314p pd=19.1u as=3.1314p ps=19.1u w=9.21u l=2u
X62 pn20_t2 S1_t1 pn13_t9 AVSS_t29 sg13_lv_nmos ad=0.102p pd=1.28u as=0.102p ps=1.28u w=0.3u l=0.13u
X63 V_OUT2_t1 pn2_t2 AVSS_t43 AVSS_t42 sg13_lv_nmos ad=2.856p pd=17.48u as=2.856p ps=17.48u w=8.4u l=0.5u
X64 AVDD_t58 pn27_t5 V_OUT2_t2 AVDD_t33 sg13_lv_pmos ad=1.0545p pd=5.93u as=1.0545p ps=5.93u w=5.55u l=0.5u
X65 pn26_t1 V_CM_t0 pn24_t12 AVDD_t21 sg13_lv_pmos ad=1.2616p pd=7.02u as=1.2616p ps=7.02u w=6.64u l=2u
X66 pn9_t1 pn9 AVSS_t33 AVSS_t32 sg13_lv_nmos ad=0.714p pd=4.88u as=0.714p ps=4.88u w=2.1u l=0.5u
X67 pn3_t2 pn15 pn13_t10 AVDD_t22 sg13_lv_pmos ad=0.1836p pd=1.76u as=0.1836p ps=1.76u w=0.54u l=0.13u
X68 pn4 S5_t1 pn13_t0 AVSS_t15 sg13_lv_nmos ad=0.1026p pd=1.34u as=0.1026p ps=1.34u w=0.18u l=0.13u
X69 AVDD_t46 pn30_t22 pn24_t5 AVDD_t45 sg13_lv_pmos ad=2.5364p pd=15.6u as=2.5364p ps=15.6u w=7.46u l=2u
X70 pn22_t2 S3_t1 pn13_t5 AVSS_t21 sg13_lv_nmos ad=0.1026p pd=1.34u as=0.1026p ps=1.34u w=0.18u l=0.13u
X71 pn7_t0 pn12_t3 AVDD_t12 AVDD_t8 sg13_lv_pmos ad=1.0925p pd=6.13u as=1.0925p ps=6.13u w=5.75u l=2u
X72 pn22 pn3_t1 AVSS_t11 rhigh l=54u w=0.5u ps=0 b=0 m=1
X73 AVDD_t61 pn27_t5 V_OUT2_t3 AVDD_t60 sg13_lv_pmos ad=1.887p pd=11.78u as=1.0545p ps=5.93u w=5.55u l=0.5u
X74 AVDD_t7 pn12_t5 pn28 AVDD_t6 sg13_lv_pmos ad=1.564p pd=9.88u as=1.564p ps=9.88u w=4.6u l=2u
X75 AVSS_t49 I_BIAS_t0 I_BIAS_t1 AVSS_t48 sg13_lv_nmos ad=0.2958p pd=2.42u as=0.2958p ps=2.42u w=0.87u l=2u
X76 AVDD_t29 pn30_t14 pn30 AVDD_t28 sg13_lv_pmos ad=2.5364p pd=15.6u as=2.5364p ps=15.6u w=7.46u l=2u
X77 pn29 pn13_t12 pn24_t2 AVDD_t21 sg13_lv_pmos ad=1.2616p pd=7.02u as=2.2576p ps=13.96u w=6.64u l=2u
X78 AVSS_t13 S5_t2 dantenna l=0.78u w=0.78u
X79 pn26_t2 pn6_t2 pn27_t1 AVSS_t28 sg13_lv_nmos ad=2.1794p pd=13.5u as=2.1794p ps=13.5u w=6.41u l=2u
X80 pn16_t1 S5_t0 AVDD_t3 AVDD_t2 sg13_lv_pmos ad=0.3808p pd=2.92u as=0.3808p ps=2.92u w=1.12u l=0.13u
X81 AVDD_t42 pn30_t8 pn30_t9 AVDD_t41 sg13_lv_pmos ad=2.5364p pd=15.6u as=2.5364p ps=15.6u w=7.46u l=2u
X82 AVDD_t44 pn30_t2 pn30_t3 AVDD_t43 sg13_lv_pmos ad=2.5364p pd=15.6u as=2.5364p ps=15.6u w=7.46u l=2u
X83 AVDD_t27 pn30_t21 pn24_t4 AVDD_t26 sg13_lv_pmos ad=2.5364p pd=15.6u as=2.5364p ps=15.6u w=7.46u l=2u
X84 pn5_t2 pn19 pn13_t3 AVDD_t0 sg13_lv_pmos ad=0.408p pd=3.08u as=0.408p ps=3.08u w=1.2u l=0.13u
X85 pn6_t0 pn12_t4 AVDD_t10 AVDD_t8 sg13_lv_pmos ad=1.0925p pd=6.13u as=1.955p ps=12.18u w=5.75u l=2u
X86 AVDD_t63 pn11 pn27_t3 AVDD_t62 sg13_lv_pmos ad=2.4922p pd=15.34u as=2.4922p ps=15.34u w=7.33u l=2u
X87 pn5_t0 pn20 AVSS_t5 rhigh l=6.66u w=0.5u ps=0 b=0 m=1
X88 pn22_t1 pn14 pn13_t4 AVDD_t19 sg13_lv_pmos ad=0.1836p pd=1.76u as=0.1836p ps=1.76u w=0.54u l=0.13u
X89 pn24_t11 V_CM_t0 pn26_t1 AVDD_t21 sg13_lv_pmos ad=2.2576p pd=13.96u as=1.2616p ps=7.02u w=6.64u l=2u
X90 pn2 I_BIAS_t2 AVSS_t53 AVSS_t52 sg13_lv_nmos ad=1.088p pd=7.08u as=1.088p ps=7.08u w=3.2u l=2u
X91 pn30_t15 I_BIAS_t3 AVSS_t47 AVSS_t46 sg13_lv_nmos ad=2.04p pd=12.68u as=2.04p ps=12.68u w=6u l=2u
R0 pn1 pn1_t0 51.8954
R1 pn9_n0 pn9_t0 17.8873
R2 pn9 pn9_n0 15.3273
R3 pn9_n0 pn9_t1 2.94632
R4 I_BIAS_n0 I_BIAS_t3 25.7258
R5 I_BIAS I_BIAS_n4 20.5487
R6 I_BIAS_t5 I_BIAS_t4 16.8947
R7 I_BIAS_t0 I_BIAS_t5 16.8903
R8 I_BIAS_t0 I_BIAS_n2 15.0005
R9 I_BIAS_t3 I_BIAS_t2 14.0016
R10 I_BIAS_n4 I_BIAS_n3 9.07096
R11 I_BIAS_n1 I_BIAS_n0 9.0005
R12 I_BIAS_n2 I_BIAS_t1 8.81129
R13 I_BIAS_n3 I_BIAS_t0 7.49231
R14 I_BIAS_n3 I_BIAS_n1 0.108892
R15 I_BIAS_n4 I_BIAS_n0 0.0389734
R16 I_BIAS_n2 I_BIAS_n1 0.0152561
R17 pn11_n0 pn11_t0 23.0364
R18 pn11 pn11_n1 5.15561
R19 pn11_n1 pn11_t1 4.56061
R20 pn11_n0 pn11_t2 1.82304
R21 pn11_n1 pn11_n0 0.5912
R22 pn26_n1 pn26_n0 21.5278
R23 pn26_n0 pn26_t2 3.90438
R24 pn26_n1 pn26_t1 3.542
R25 pn26 pn26_n1 2.48315
R26 pn26_n0 pn26_t0 1.16537
R27 V_CM V_CM_n5 14.2079
R28 V_CM_n2 V_CM_t0 12.7904
R29 V_CM_n3 V_CM_n0 9.0912
R30 V_CM_n2 V_CM_n1 9.05697
R31 V_CM_n1 V_CM_n0 9.0137
R32 V_CM_n5 V_CM_n4 9.0005
R33 V_CM_n3 V_CM_n2 4.52153
R34 V_CM_n4 V_CM_n1 0.0775
R35 V_CM_n4 V_CM_n3 0.0388129
R36 V_CM_n5 V_CM_n0 0.00123333
R37 pn25_n1 pn25_n0 18.0731
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
R548 AVDD_n289 AVDD_n137 4.251
R549 AVDD_n289 AVDD_n136 4.251
R550 AVDD_n289 AVDD_n135 4.251
R551 AVDD_n289 AVDD_n134 4.251
R552 AVDD_n165 AVDD_n130 4.251
R553 AVDD_n162 AVDD_n130 4.251
R554 AVDD_n138 AVDD_n130 4.251
R555 AVDD_t37 AVDD_n26 4.2505
R556 AVDD_n276 AVDD_t26 4.2505
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
