orpheus016/sg13cmos5l_spma_ip__instramp/cace/instramp_cmos5l.yaml

#--------------------------------------------------------------
# CACE datasheet: instramp_cmos5l (3-OTA instrumentation amplifier, closed-loop gain 8 V/V)
#--------------------------------------------------------------

name:           instramp_cmos5l
description:    Three-OTA instrumentation amplifier, closed-loop gain 8 V/V (18.0618 dB)
PDK:            ihp-sg13cmos5l

cace_format:    5.2

authorship:
  designer:         SPMA
  creation_date:    October 13, 2026
  license:          MIT

paths:
  root:             ..
  schematic:        xschem/instramp_cmos5l
  netlist:          netlist/instramp_cmos5l
  documentation:    docs/instramp_cmos5l/cace
  templates:        cace/templates/instramp_cmos5l

pins:
  VDD:
    description: Positive analog power supply
    type: power
    direction: inout
    Vmin: 1.2
    Vmax: 1.5
  VSS:
    description: Analog ground
    type: ground
    direction: inout
  IBIAS:
    description: Bias current input (shared by the three OTAs, 1.4 uA each)
    type: signal
    direction: input
  VINP:
    description: Non-inverting input
    type: signal
    direction: input
  VINN:
    description: Inverting input
    type: signal
    direction: input
  CM:
    description: Common-mode reference (input resistor divider centre)
    type: signal
    direction: input
  VOUT:
    description: Output
    type: signal
    direction: output

default_conditions:
  vdd:
    description: Analog power supply voltage
    display: Vdd
    unit: V
    typical: 1.2
  vcm:
    description: Input and CM pin common-mode voltage
    display: Vcm
    unit: V
    typical: 0.6
  ib:
    description: Total bias current (three OTAs)
    display: Ib
    unit: uA
    typical: 4.2
  fin:
    description: Input sine frequency for THD
    display: Fin
    unit: kHz
    typical: 1
  rs:
    description: Source impedance in front of each input (input_network parameter only)
    display: Rs
    unit: kOhm
    typical: 100
  vin_amp:
    description: Differential input sine amplitude (peak) for THD
    display: Vin amp
    unit: mV
    typical: 25
  cl:
    description: Output load capacitance
    display: CLoad
    unit: pF
    typical: 3
  corner:
    description: Process corner
    display: Corner
    typical: tt
  rcorner:
    description: Resistor corner (res_<rcorner> section of cornerRES.lib)
    display: Rcorner
    typical: typ
  temperature:
    description: Ambient temperature
    display: Temp
    unit: °C
    typical: 27

# parameters: from here on GENERATED by scripts/gen_cace.py from cace/instramp_cmos5l.params.yaml - edit the manifest / the testbenches, not this part
parameters:
  ac_gain:
    display: "Closed-loop AC gain"
    description: "Differential closed-loop gain (VINP ac=1 V, VINN and CM at DC), gain target 8 V/V = 18.0618 dB"
    spec:
      A_CL:
        display: "Closed-loop gain at 1 Hz"
        unit: "dB"
        minimum:
          value: any
        typical:
          value: 18.0618
        maximum:
          value: any
      A_ERR:
        display: "Gain error vs 8 V/V"
        unit: "dB"
        minimum:
          value: any
        typical:
          value: any
        maximum:
          value: any
      F3DB:
        display: "-3 dB bandwidth"
        unit: "Hz"
        minimum:
          value: any
        typical:
          value: any
        maximum:
          value: any
      F0DB:
        display: "0 dB frequency"
        unit: "Hz"
        minimum:
          value: any
        typical:
          value: any
        maximum:
          value: any
      PH0:
        display: "Closed-loop phase at 0 dB"
        unit: "°"
        minimum:
          value: any
        typical:
          value: any
        maximum:
          value: any
    tool:
      ngspice:
        template: ac.sch
        format: ascii
        suffix: .data
        variables: [A_CL, A_ERR, F3DB, F0DB, PH0]
    plot:
      ac_gain_A_CL_vs_temperature:
        type: xyplot
        xaxis: temperature
        yaxis: A_CL
        limits: auto
      ac_gain_F3DB_vs_temperature:
        type: xyplot
        xaxis: temperature
        yaxis: F3DB
        limits: auto
      ac_gain_A_CL_vs_vdd:
        type: xyplot
        xaxis: vdd
        yaxis: A_CL
        limits: auto
    conditions:
      corner:
        enumerate: [tt, ss, ff, sf, fs]
      vdd:
        minimum: 1.2
        typical: 1.35
        maximum: 1.5
      temperature:
        minimum: -40
        typical: 27
        maximum: 85

  thd:
    display: "Total harmonic distortion"
    description: "THD (harmonics 2..9) of the closed-loop output for a sine on VINP, coherent FFT over 8 periods (128 points per period)"
    spec:
      THD_DB:
        display: "THD"
        unit: "dB"
        minimum:
          value: any
        typical:
          value: any
        maximum:
          value: any
      THD_PCT:
        display: "THD"
        unit: "%"
        minimum:
          value: any
        typical:
          value: any
        maximum:
          value: any
      HD2_DB:
        display: "2nd harmonic"
        unit: "dB"
        minimum:
          value: any
        typical:
          value: any
        maximum:
          value: any
      HD3_DB:
        display: "3rd harmonic"
        unit: "dB"
        minimum:
          value: any
        typical:
          value: any
        maximum:
          value: any
      VO1:
        display: "Output fundamental amplitude"
        unit: "V"
        minimum:
          value: any
        typical:
          value: any
        maximum:
          value: any
    tool:
      ngspice:
        template: thd.sch
        format: ascii
        suffix: .data
        variables: [THD_DB, THD_PCT, HD2_DB, HD3_DB, VO1]
    plot:
      thd_THD_DB_vs_temperature:
        type: xyplot
        xaxis: temperature
        yaxis: THD_DB
        limits: auto
    conditions:
      corner:
        enumerate: [tt, ss, ff, sf, fs]
      vdd:
        minimum: 1.2
        typical: 1.35
        maximum: 1.5
      temperature:
        minimum: -40
        typical: 27
        maximum: 85

  input_network:
    display: "Input network (pseudo-resistors of pgia_top)"
    description: "The other parameters drive the inputs with ideal sources. Here the four PMOS pseudo-resistors that pgia_top places on VINN/VINP (taken from the LVS netlist of pgia_top) and a source impedance Rs are in front of the amplifier"
    spec:
      R_IN:
        display: "Input resistance of one input (Rs removed)"
        unit: "GOhm"
        minimum:
          value: any
        typical:
          value: any
        maximum:
          value: any
      A_NET:
        display: "Closed-loop gain at 1 kHz with the network"
        unit: "dB"
        minimum:
          value: any
        typical:
          value: any
        maximum:
          value: any
      IRN_100:
        display: "Input noise @100 Hz incl. Rs and network"
        unit: "nV/rtHz"
        minimum:
          value: any
        typical:
          value: any
        maximum:
          value: any
      IRN_1K:
        display: "Input noise @1 kHz incl. Rs and network"
        unit: "nV/rtHz"
        minimum:
          value: any
        typical:
          value: any
        maximum:
          value: any
      VOS_NET:
        display: "Output DC level minus Vcm with the network"
        unit: "mV"
        minimum:
          value: any
        typical:
          value: any
        maximum:
          value: any
      THD_DB:
        display: "THD with Rs and network"
        unit: "dB"
        minimum:
          value: any
        typical:
          value: any
        maximum:
          value: any
      HD3_DB:
        display: "3rd harmonic with Rs and network"
        unit: "dB"
        minimum:
          value: any
        typical:
          value: any
        maximum:
          value: any
    tool:
      ngspice:
        template: inbias.sch
        format: ascii
        suffix: .data
        variables: [R_IN, A_NET, IRN_100, IRN_1K, VOS_NET, THD_DB, HD3_DB]
    plot:
      input_network_R_IN_vs_temperature:
        type: xyplot
        xaxis: temperature
        yaxis: R_IN
        limits: auto
    conditions:
      corner:
        enumerate: [tt, ss, ff, sf, fs]
      vdd:
        minimum: 1.2
        typical: 1.35
        maximum: 1.5
      temperature:
        minimum: -40
        typical: 27
        maximum: 85

  cmrr:
    display: "CMRR"
    description: "Common-mode rejection = differential gain / common-mode gain (two AC runs), CM pin held at DC"
    spec:
      ADM_DC:
        display: "Differential gain @10 Hz"
        unit: "dB"
        minimum:
          value: any
        typical:
          value: any
        maximum:
          value: any
      CMRR_DC:
        display: "CMRR @10 Hz"
        unit: "dB"
        minimum:
          value: any
        typical:
          value: any
        maximum:
          value: any
      CMRR_100K:
        display: "CMRR @100 kHz"
        unit: "dB"
        minimum:
          value: any
        typical:
          value: any
        maximum:
          value: any
      CMRR_1M:
        display: "CMRR @1 MHz"
        unit: "dB"
        minimum:
          value: any
        typical:
          value: any
        maximum:
          value: any
    tool:
      ngspice:
        template: cmrr.sch
        format: ascii
        suffix: .data
        variables: [ADM_DC, CMRR_DC, CMRR_100K, CMRR_1M]
    plot:
      cmrr_ADM_DC_vs_temperature:
        type: xyplot
        xaxis: temperature
        yaxis: ADM_DC
        limits: auto
    conditions:
      corner:
        enumerate: [tt, ss, ff, sf, fs]
      vdd:
        minimum: 1.2
        typical: 1.35
        maximum: 1.5
      temperature:
        minimum: -40
        typical: 27
        maximum: 85

  psrr:
    display: "PSRR"
    description: "Input-referred supply rejection of VDD = differential gain / VDD-to-output gain"
    spec:
      ADM_DC:
        display: "Differential gain @10 Hz"
        unit: "dB"
        minimum:
          value: any
        typical:
          value: any
        maximum:
          value: any
      PSRR_DC:
        display: "PSRR @10 Hz"
        unit: "dB"
        minimum:
          value: any
        typical:
          value: any
        maximum:
          value: any
      PSRR_100K:
        display: "PSRR @100 kHz"
        unit: "dB"
        minimum:
          value: any
        typical:
          value: any
        maximum:
          value: any
      PSRR_1M:
        display: "PSRR @1 MHz"
        unit: "dB"
        minimum:
          value: any
        typical:
          value: any
        maximum:
          value: any
    tool:
      ngspice:
        template: psrr.sch
        format: ascii
        suffix: .data
        variables: [ADM_DC, PSRR_DC, PSRR_100K, PSRR_1M]
    plot:
      psrr_ADM_DC_vs_temperature:
        type: xyplot
        xaxis: temperature
        yaxis: ADM_DC
        limits: auto
    conditions:
      corner:
        enumerate: [tt, ss, ff, sf, fs]
      vdd:
        minimum: 1.2
        typical: 1.35
        maximum: 1.5
      temperature:
        minimum: -40
        typical: 27
        maximum: 85

  noise:
    display: "Noise"
    description: "Differential input-referred noise density (referred to VINP, gain VINP->VOUT = Adm), 10 Hz-100 MHz; INOISE_EQ = output noise / low-frequency gain"
    spec:
      IRN_10:
        display: "Input noise @10 Hz"
        unit: "nV/rtHz"
        minimum:
          value: any
        typical:
          value: any
        maximum:
          value: any
      IRN_100:
        display: "Input noise @100 Hz"
        unit: "nV/rtHz"
        minimum:
          value: any
        typical:
          value: any
        maximum:
          value: any
      IRN_1K:
        display: "Input noise @1 kHz"
        unit: "nV/rtHz"
        minimum:
          value: any
        typical:
          value: any
        maximum:
          value: any
      IRN_10K:
        display: "Input noise @10 kHz"
        unit: "nV/rtHz"
        minimum:
          value: any
        typical:
          value: any
        maximum:
          value: any
      ORN_1K:
        display: "Output noise @1 kHz"
        unit: "nV/rtHz"
        minimum:
          value: any
        typical:
          value: any
        maximum:
          value: any
      ONOISE_TOT:
        display: "Integrated output noise"
        unit: "uV-rms"
        minimum:
          value: any
        typical:
          value: any
        maximum:
          value: any
      INOISE_EQ:
        display: "In-band input-referred noise (Vn_out / gain)"
        unit: "uV-rms"
        minimum:
          value: any
        typical:
          value: any
        maximum:
          value: any
    tool:
      ngspice:
        template: noise.sch
        format: ascii
        suffix: .data
        variables: [IRN_10, IRN_100, IRN_1K, IRN_10K, ORN_1K, ONOISE_TOT, INOISE_EQ]
    plot:
      noise_IRN_10_vs_temperature:
        type: xyplot
        xaxis: temperature
        yaxis: IRN_10
        limits: auto
    conditions:
      corner:
        enumerate: [tt, ss, ff, sf, fs]
      vdd:
        minimum: 1.2
        typical: 1.35
        maximum: 1.5
      temperature:
        minimum: -40
        typical: 27
        maximum: 85

  dc_op:
    display: "DC operating point"
    description: "Output offset (VOUT - Vcm with VINP = VINN = CM = Vcm), quiescent current and power"
    spec:
      VOS:
        display: "Output offset (Vcm - Vout)"
        unit: "mV"
        minimum:
          value: any
        typical:
          value: any
        maximum:
          value: any
      VOUT:
        display: "Output voltage"
        unit: "V"
        minimum:
          value: any
        typical:
          value: any
        maximum:
          value: any
      IQ:
        display: "Quiescent current"
        unit: "uA"
        minimum:
          value: any
        typical:
          value: any
        maximum:
          value: any
      PWR:
        display: "Quiescent power"
        unit: "uW"
        minimum:
          value: any
        typical:
          value: any
        maximum:
          value: any
    tool:
      ngspice:
        template: dc_op.sch
        format: ascii
        suffix: .data
        variables: [VOS, VOUT, IQ, PWR]
    plot:
      dc_op_VOS_vs_temperature:
        type: xyplot
        xaxis: temperature
        yaxis: VOS
        limits: auto
    conditions:
      corner:
        enumerate: [tt, ss, ff, sf, fs]
      vdd:
        minimum: 1.2
        typical: 1.35
        maximum: 1.5
      temperature:
        minimum: -40
        typical: 27
        maximum: 85

  tran_small:
    display: "Small-signal transient"
    description: "1 uV (peak) 10 Hz sine on VINP around Vcm, gain from peak-to-peak over the last 5 periods and the mean output level"
    spec:
      TR_GAIN:
        display: "Small-signal gain (transient)"
        unit: ""
        minimum:
          value: any
        typical:
          value: any
        maximum:
          value: any
      TR_VOUT_AVG:
        display: "Mean output level"
        unit: "V"
        minimum:
          value: any
        typical:
          value: any
        maximum:
          value: any
    tool:
      ngspice:
        template: tran_small.sch
        format: ascii
        suffix: .data
        variables: [TR_GAIN, TR_VOUT_AVG]
    plot:
      tran_small_TR_GAIN_vs_temperature:
        type: xyplot
        xaxis: temperature
        yaxis: TR_GAIN
        limits: auto
    conditions:
      corner:
        enumerate: [tt, ss, ff, sf, fs]
      vdd:
        minimum: 1.2
        typical: 1.35
        maximum: 1.5
      temperature:
        minimum: -40
        typical: 27
        maximum: 85
