orpheus016/sg13cmos5l_spma_ip__instramp/gds/gain_decoder_4b/final/nl/gain_decoder_4b.nl.v

module gain_decoder_4b (gain_sel,
    s1,
    s1_b,
    s2,
    s2_b);
 input [3:0] gain_sel;
 output [4:0] s1;
 output [4:0] s1_b;
 output [4:0] s2;
 output [4:0] s2_b;

 wire _00_;
 wire _01_;
 wire _02_;
 wire _03_;
 wire _04_;
 wire _05_;
 wire _06_;
 wire _07_;
 wire _08_;
 wire _09_;
 wire _10_;
 wire net1;
 wire net2;
 wire net3;
 wire net4;
 wire net5;
 wire net6;
 wire net7;
 wire net8;
 wire net9;
 wire net10;
 wire net11;
 wire net12;
 wire net13;
 wire net14;
 wire net15;
 wire net16;
 wire net17;
 wire net18;
 wire net19;
 wire net20;
 wire net21;
 wire net22;
 wire net23;
 wire net24;

 sg13cmos5l_fill_1 FILLER_0_102 ();
 sg13cmos5l_decap_8 FILLER_0_15 ();
 sg13cmos5l_decap_8 FILLER_0_22 ();
 sg13cmos5l_decap_4 FILLER_0_29 ();
 sg13cmos5l_fill_1 FILLER_0_37 ();
 sg13cmos5l_decap_8 FILLER_0_42 ();
 sg13cmos5l_decap_4 FILLER_0_49 ();
 sg13cmos5l_fill_1 FILLER_0_77 ();
 sg13cmos5l_decap_8 FILLER_0_8 ();
 sg13cmos5l_decap_8 FILLER_1_0 ();
 sg13cmos5l_fill_2 FILLER_1_109 ();
 sg13cmos5l_decap_8 FILLER_1_14 ();
 sg13cmos5l_fill_2 FILLER_1_21 ();
 sg13cmos5l_fill_1 FILLER_1_58 ();
 sg13cmos5l_decap_8 FILLER_1_7 ();
 sg13cmos5l_decap_8 FILLER_2_15 ();
 sg13cmos5l_decap_8 FILLER_2_22 ();
 sg13cmos5l_decap_8 FILLER_2_29 ();
 sg13cmos5l_fill_2 FILLER_2_36 ();
 sg13cmos5l_decap_8 FILLER_2_42 ();
 sg13cmos5l_decap_4 FILLER_2_49 ();
 sg13cmos5l_fill_1 FILLER_2_53 ();
 sg13cmos5l_fill_1 FILLER_2_61 ();
 sg13cmos5l_fill_1 FILLER_2_78 ();
 sg13cmos5l_decap_8 FILLER_2_8 ();
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
    .X(s2_b[4]));
 sg13cmos5l_buf_1 output5 (.A(net5),
    .X(s1[0]));
 sg13cmos5l_buf_1 output6 (.A(net6),
    .X(s1[1]));
 sg13cmos5l_buf_1 output7 (.A(net7),
    .X(s1[2]));
 sg13cmos5l_buf_1 output8 (.A(net8),
    .X(s1[3]));
 sg13cmos5l_buf_1 output9 (.A(net9),
    .X(s1[4]));
endmodule
