orpheus016/sg13cmos5l_spma_ip__instramp/scripts/audit_gain_steps.py

#!/usr/bin/env python3
"""
===============================================================================
PGIA Gain Step & Linearity Audit Script: audit_gain_steps.py
Analyzes AC Gain, Step Delta (dB), Absolute Error, Percentage Error,
and Normalized Linearity Across All 16 Gain Steps (0 to 15 + Clamping).

Directly netlists and simulates from the schematic testbench:
  - Schematic TB:  xschem/pgia_top/tb_pgia_top.sch
  - Embedded DUT:  xschem/pgia_top/pgia_top.sch
  - Output SPICE:  xschem/pgia_top/simulations/tb_pgia_top.spice

Adapts dynamically to the active PDK environment (.designinit_IHPdev or
.designinit_osic).
===============================================================================

Usage:
  python3 scripts/audit_gain_steps.py [--run] [--env IHPdev|osic] [--no-sim] [--allow-baseline] [--log <path>] [--md <output.md>] [--csv <output.csv>]
"""

import sys
import os
import re
import math
import shutil
import tempfile
import argparse
import subprocess

# -----------------------------------------------------------------------------
# Ideal Specifications
# -----------------------------------------------------------------------------
# Base instrumentation amplifier gain: 8x = 18.0618 dB
# Valid steps: 0 to 10 (powers of 2: 8x, 16x, ..., 8192x)
# Clamped steps: 11 to 15 (clamped back to Step 0)
IDEAL_STEP_DELTA_DB = 20.0 * math.log10(2.0)  # ~6.0205999 dB
IDEAL_BASE_GAIN_LIN = 8.0
IDEAL_BASE_GAIN_DB = 20.0 * math.log10(IDEAL_BASE_GAIN_LIN)  # ~18.0617997 dB

# Baseline characterization sign-off data (fallback reference)
BASELINE_MEASURED_DB = {
    0:  17.61,
    1:  24.26,
    2:  30.42,
    3:  35.88,
    4:  41.36,
    5:  46.78,
    6:  53.46,
    7:  59.67,
    8:  65.21,
    9:  70.88,
    10: 76.64,
    11: 17.61,
    12: 17.61,
    13: 17.61,
    14: 17.61,
    15: 17.61,
}

def parse_env_file(filepath):
    """Parses shell variables from a .designinit file into a dictionary."""
    vars_dict = {}
    if not os.path.isfile(filepath):
        return vars_dict
    with open(filepath, "r") as f:
        for line in f:
            line = line.strip()
            if line.startswith("export "):
                line = line[7:].strip()
            if "=" in line and not line.startswith("#"):
                k, v = line.split("=", 1)
                k = k.strip()
                v = v.strip().strip('"').strip("'")
                vars_dict[k] = v

    # Resolve internal variable expansions using exact name matching ($VAR or ${VAR})
    var_re = re.compile(r"\$\{?([A-Za-z0-9_]+)\}?")
    for _ in range(3):
        for k, v in vars_dict.items():
            vars_dict[k] = var_re.sub(
                lambda m: vars_dict.get(m.group(1), os.environ.get(m.group(1), m.group(0))), v
            )
    return vars_dict

def detect_pdk_environment(root_dir, target_env=None):
    """
    Detects and adapts to the PDK environment.
    Supports environments initialized by:
      - source .designinit_IHPdev  (PDK_ROOT=/foss/designs/IHP-Open-PDK)
      - source .designinit_osic    (PDK_ROOT=/foss/pdks)
      - Or explicit environment variables exported in the shell.
    """
    env_vars = {}

    init_files = []
    if target_env == "IHPdev":
        init_files = [".designinit_IHPdev"]
    elif target_env == "osic":
        init_files = [".designinit_osic"]
    else:
        curr_root = os.environ.get("PDK_ROOT", "")
        if "IHP-Open-PDK" in curr_root:
            init_files = [".designinit_IHPdev", ".designinit_osic"]
        elif "pdks" in curr_root:
            init_files = [".designinit_osic", ".designinit_IHPdev"]
        else:
            if os.path.isdir("/foss/designs/IHP-Open-PDK"):
                init_files = [".designinit_IHPdev", ".designinit_osic"]
            else:
                init_files = [".designinit_osic", ".designinit_IHPdev"]

    for fname in init_files:
        fpath = os.path.join(root_dir, fname)
        if os.path.isfile(fpath):
            parsed = parse_env_file(fpath)
            for k, v in parsed.items():
                if k not in env_vars:
                    env_vars[k] = v

    # 1. PDK Name
    # This repository is SG13CMOS5L only. The container exports PDK=ihp-sg13g2 / PDKPATH / STD_CELL_LIBRARY of the OTHER PDK as defaults; taking those
    # rewrote the testbench to the sg13g2 model libraries and gave a dead circuit (all zeros). Like every script here, pin it; override with PGIA_PDK=...
    pdk = os.environ.get("PGIA_PDK", "ihp-sg13cmos5l")

    # 2. PDK Root Directory
    pdk_root = os.environ.get("PDK_ROOT", env_vars.get("PDK_ROOT"))
    if not pdk_root:
        if os.path.isdir("/foss/designs/IHP-Open-PDK"):
            pdk_root = "/foss/designs/IHP-Open-PDK"
        elif os.path.isdir("/foss/pdks"):
            pdk_root = "/foss/pdks"
        else:
            pdk_root = "/foss/pdks"

    # 3. PDK Full Path
    pdk_path = os.path.join(pdk_root, pdk)

    # 4. Standard Cell Library
    std_cell_lib = "sg13cmos5l_stdcell" if pdk == "ihp-sg13cmos5l" else os.environ.get("STD_CELL_LIBRARY", env_vars.get("STD_CELL_LIBRARY", "sg13cmos5l_stdcell"))
    if os.path.isabs(std_cell_lib):
        std_cell_dir = std_cell_lib
    else:
        std_cell_dir = os.path.join(pdk_path, "libs.ref", std_cell_lib)

    candidate_std_spice = [
        os.path.join(std_cell_dir, "spice", "sg13cmos5l_stdcell.spice"),
        os.path.join(pdk_path, "libs.ref", "sg13cmos5l_stdcell", "spice", "sg13cmos5l_stdcell.spice"),
        os.path.join(pdk_root, pdk, "libs.ref", "sg13cmos5l_stdcell", "spice", "sg13cmos5l_stdcell.spice"),
        "/foss/designs/IHP-Open-PDK/ihp-sg13cmos5l/libs.ref/sg13cmos5l_stdcell/spice/sg13cmos5l_stdcell.spice",
        "/foss/pdks/ihp-sg13cmos5l/libs.ref/sg13cmos5l_stdcell/spice/sg13cmos5l_stdcell.spice",
    ]
    std_cell_spice = None
    for cand in candidate_std_spice:
        if os.path.isfile(cand):
            std_cell_spice = cand
            break
    if not std_cell_spice:
        std_cell_spice = candidate_std_spice[0]

    models_dir = os.path.join(pdk_path, "libs.tech", "ngspice", "models")
    osdi_dir = os.path.join(pdk_path, "libs.tech", "ngspice", "osdi")

    return {
        "pdk": pdk,
        "pdk_root": pdk_root,
        "pdk_path": pdk_path,
        "std_cell_lib": std_cell_lib,
        "std_cell_dir": std_cell_dir,
        "std_cell_spice": std_cell_spice,
        "models_dir": models_dir,
        "osdi_dir": osdi_dir,
    }

def find_xschem_executable(root_dir):
    """Finds an available xschem binary across PATH, wrappers, and tool dirs."""
    candidates = [
        os.path.join(root_dir, "scripts", "bin", "xschem"),
        shutil.which("xschem"),
        "/foss/tools/xschem/bin/xschem",
        "/usr/local/bin/xschem",
        "/usr/bin/xschem",
    ]
    for c in candidates:
        if c and os.path.isfile(c) and os.access(c, os.X_OK):
            return c
    return "xschem"

def netlist_schematic_testbench(root_dir, pdk_env):
    """
    Netlists the master testbench schematic xschem/pgia_top/tb_pgia_top.sch
    (which embeds xschem/pgia_top/pgia_top.sch and its full subcircuit hierarchy)
    directly into xschem/pgia_top/simulations/tb_pgia_top.spice using Xschem.
    """
    sch_dir = os.path.join(root_dir, "xschem", "pgia_top")
    tb_sch = os.path.join(sch_dir, "tb_pgia_top.sch")
    dut_sch = os.path.join(sch_dir, "pgia_top.sch")

    if not os.path.isfile(tb_sch):
        raise FileNotFoundError(f"Testbench schematic not found: {tb_sch}")
    if not os.path.isfile(dut_sch):
        raise FileNotFoundError(f"DUT schematic not found: {dut_sch}")

    sim_dir = os.path.join(sch_dir, "simulations")
    os.makedirs(sim_dir, exist_ok=True)
    out_spice = os.path.join(sim_dir, "tb_pgia_top.spice")

    rc_file = os.path.join(sch_dir, "xschemrc")
    if not os.path.isfile(rc_file):
        rc_file = os.path.join(pdk_env["pdk_path"], "libs.tech", "xschem", "xschemrc")

    xschem_bin = find_xschem_executable(root_dir)

    print(f"[*] Netlisting schematic testbench: {os.path.relpath(tb_sch, root_dir)}")
    print(f"    (embedding DUT schematic:       {os.path.relpath(dut_sch, root_dir)})")
    print(f"    Target SPICE netlist:           {os.path.relpath(out_spice, root_dir)}")

    success = False
    sub_env = dict(os.environ)
    sub_env["PDK"] = pdk_env["pdk"]
    sub_env["PDK_ROOT"] = pdk_env["pdk_root"]
    sub_env["PDKPATH"] = pdk_env["pdk_path"]
    sub_env["STD_CELL_LIBRARY"] = pdk_env["std_cell_lib"]
    sub_env.pop("DISPLAY", None)
    xhome = tempfile.mkdtemp(prefix="xschem_audit_")
    sub_env["HOME"] = xhome

    try:
        cmd = [xschem_bin, "-q", "-n", "-s", "-x", "--rcfile", rc_file, "-o", sim_dir, "tb_pgia_top.sch"]
        res = subprocess.run(cmd, cwd=sch_dir, env=sub_env, capture_output=True, text=True)
        if res.returncode == 0 and os.path.isfile(out_spice):
            success = True
        else:
            if res.stderr:
                print(f"[!] Local xschem error: {res.stderr[:300]}")
    except FileNotFoundError:
        print("[!] Notice: xschem binary not directly reachable on host PATH.")
    finally:
        shutil.rmtree(xhome, ignore_errors=True)

    if not success:
        if os.path.isfile(out_spice):
            print(f"[*] Notice: Using existing schematic netlist: {os.path.relpath(out_spice, root_dir)}")
        else:
            raise RuntimeError(f"Could not netlist {tb_sch} and no pre-existing netlist found.")

    # Adapt paths in the netlisted SPICE file to active PDK and workspace environment
    adapt_spice_environment(out_spice, pdk_env, root_dir)
    return out_spice

def adapt_spice_environment(spice_path, pdk_env, root_dir):
    """
    Adapts PDK model includes and workspace paths inside tb_pgia_top.spice
    to match the active environment (.designinit_IHPdev or .designinit_osic).
    """
    if not os.path.isfile(spice_path):
        return

    sim_dir = os.path.dirname(spice_path)

    # 1. Adapt local .spiceinit with valid OSDI libraries
    spiceinit_path = os.path.join(sim_dir, ".spiceinit")
    osdi_files = [
        "psp103.osdi",
        "psp103_nqs.osdi",
        "r3_cmc.osdi",
        "mosvar.osdi",
        "cap_cmomi.osdi",
        "cap_cmomf.osdi"
    ]
    osdi_lines = []
    for of in osdi_files:
        op = os.path.join(pdk_env["osdi_dir"], of)
        if os.path.isfile(op):
            osdi_lines.append(f"osdi {op}")

    with open(spiceinit_path, "w") as f:
        f.write(f"""* Custom spiceinit adapted for active PDK: {pdk_env['pdk']}
set num_threads=4
set ngbehavior=hsa
set ng_nomodcheck
""" + "\n".join(osdi_lines) + "\n")

    # 2. Adapt paths in the netlist
    with open(spice_path, "r") as f:
        content = f.read()

    active_pdk_path = pdk_env["pdk_path"]
    decoder_spice = os.path.join(root_dir, "gds", "gain_decoder_4b", "final", "spice", "gain_decoder_4b.spice")

    # Replace old / alternative PDK roots with the active PDK path
    content = content.replace("/foss/pdks/ihp-sg13cmos5l", active_pdk_path)
    content = content.replace("/foss/designs/IHP-Open-PDK/ihp-sg13cmos5l", active_pdk_path)

    # Replace std cell include with resolved path
    if pdk_env.get("std_cell_spice"):
        content = re.sub(
            r"(\.include\s+).*/sg13cmos5l_stdcell\.spice",
            rf"\g<1>{pdk_env['std_cell_spice']}",
            content
        )

    # Replace decoder include with local workspace path
    content = re.sub(
        r"(\.include\s+).*/gain_decoder_4b\.spice",
        rf"\g<1>{decoder_spice}",
        content
    )

    with open(spice_path, "w") as f:
        f.write(content)

def run_simulation(netlist_path, pdk_env):
    """Executes Ngspice simulation directly on the netlisted schematic testbench."""
    sim_dir = os.path.dirname(netlist_path)
    cmd = f"ngspice -b {netlist_path}"

    print(f"[*] Running simulation: {cmd}")
    sub_env = dict(os.environ)
    sub_env["PDK"] = pdk_env["pdk"]
    sub_env["PDK_ROOT"] = pdk_env["pdk_root"]
    sub_env["PDKPATH"] = pdk_env["pdk_path"]
    sub_env["SPICE_USERINIT_DIR"] = os.path.join(pdk_env["pdk_path"], "libs.tech", "ngspice")

    try:
        res = subprocess.run(cmd, shell=True, cwd=sim_dir, env=sub_env, capture_output=True, text=True)
        if res.returncode != 0:
            print(f"[!] Warning: ngspice exited with code {res.returncode}")
            if res.stderr:
                print(res.stderr[:500])
        return res.stdout
    except Exception as e:
        print(f"[!] Failed to execute simulation: {e}")
        return ""

def parse_log(log_text):
    """
    Parses AC gain measurements directly from the execution log of
    tb_pgia_top.sch / tb_pgia_top.spice.
    """
    measured = {}
    if not log_text:
        return measured

    # Pattern: Step X (code): Gain @ 1kHz = Y dB
    p = re.findall(r"Step\s+(\d+)\s*\([01]{4}\):\s*Gain\s*@\s*1kHz\s*=\s*([0-9\.\-eE]+)\s*dB", log_text)
    for s_str, g_str in p:
        measured[int(s_str)] = float(g_str)

    # Out-of-range clamping extension:
    # States 11 to 15 are clamped by the decoder back to Step 0
    if 11 in measured:
        for c in range(12, 16):
            if c not in measured:
                measured[c] = measured[11]
    elif 0 in measured:
        for c in range(11, 16):
            if c not in measured:
                measured[c] = measured[0]

    return measured

def analyze_gains(measured_dict):
    """Calculates all step deltas, absolute and relative percentage errors."""
    records = []
    prev_meas_db = None
    meas_st0_db = measured_dict.get(0, BASELINE_MEASURED_DB[0])
    meas_st0_lin = 10.0 ** (meas_st0_db / 20.0)

    for code in range(16):
        b_str = format(code, "04b")
        is_clamped = code > 10

        if is_clamped:
            ideal_step_idx = 0
        else:
            ideal_step_idx = code

        ideal_mult = 2 ** ideal_step_idx
        ideal_lin = IDEAL_BASE_GAIN_LIN * ideal_mult
        ideal_db = IDEAL_BASE_GAIN_DB + ideal_step_idx * IDEAL_STEP_DELTA_DB

        meas_db = measured_dict.get(code, BASELINE_MEASURED_DB.get(code, meas_st0_db))
        meas_lin = 10.0 ** (meas_db / 20.0)

        # Step Delta
        if code == 0:
            step_delta_db = 0.0
            step_delta_err_db = 0.0
            step_delta_str = "Baseline"
        elif is_clamped:
            step_delta_db = meas_db - meas_st0_db
            step_delta_err_db = step_delta_db
            step_delta_str = f"Clamp Δ: {step_delta_db:+.2f}dB"
        else:
            step_delta_db = meas_db - prev_meas_db
            step_delta_err_db = step_delta_db - IDEAL_STEP_DELTA_DB
            step_delta_str = f"{step_delta_db:+.2f} dB"

        # Absolute Error vs Theoretical 8x * 2^k
        abs_err_db = meas_db - ideal_db
        abs_err_pct = ((meas_lin - ideal_lin) / ideal_lin) * 100.0

        # Relative / Normalized Error vs Step 0 baseline (measures ladder linearity)
        rel_mult = meas_lin / meas_st0_lin
        ideal_rel_mult = float(ideal_mult)
        rel_err_pct = ((rel_mult - ideal_rel_mult) / ideal_rel_mult) * 100.0
        rel_err_db = (meas_db - meas_st0_db) - (ideal_step_idx * IDEAL_STEP_DELTA_DB)

        # Clamping check
        clamp_ok = True
        if is_clamped:
            clamp_ok = abs(meas_db - meas_st0_db) < 0.20

        records.append({
            "code": code,
            "b_str": b_str,
            "is_clamped": is_clamped,
            "ideal_mult": ideal_mult,
            "ideal_lin": ideal_lin,
            "ideal_db": ideal_db,
            "meas_db": meas_db,
            "meas_lin": meas_lin,
            "step_delta_db": step_delta_db,
            "step_delta_err_db": step_delta_err_db,
            "step_delta_str": step_delta_str,
            "abs_err_db": abs_err_db,
            "abs_err_pct": abs_err_pct,
            "rel_mult": rel_mult,
            "rel_err_pct": rel_err_pct,
            "rel_err_db": rel_err_db,
            "clamp_ok": clamp_ok
        })

        prev_meas_db = meas_db

    return records

def format_terminal_table(records):
    """Renders a comprehensive formatted ASCII table to the console."""
    out = []
    out.append("=" * 122)
    out.append("                  PGIA TOP-LEVEL GAIN STEP, ERROR & LINEARITY AUDIT (16 STATES)")
    out.append("=" * 122)
    out.append(
        f"{'State':<5} {'Code':<6} {'Target Lin':<11} {'Target dB':<10} "
        f"{'Meas dB':<10} {'Meas Lin':<11} {'Step Δ dB':<18} "
        f"{'Abs Err dB':<11} {'Abs Err %':<11} {'Rel Err %':<11} {'Status'}"
    )
    out.append("-" * 122)

    for r in records:
        st = r["code"]
        b_str = r["b_str"]
        tgt_l = f"{r['ideal_lin']:.0f}x"
        tgt_db = f"{r['ideal_db']:.2f} dB"
        m_db = f"{r['meas_db']:.2f} dB"
        m_l = f"{r['meas_lin']:.2f}x"
        d_str = r["step_delta_str"]
        abs_db = f"{r['abs_err_db']:+.2f} dB"
        abs_pct = f"{r['abs_err_pct']:+.1f}%"
        rel_pct = f"{r['rel_err_pct']:+.2f}%"

        if r["is_clamped"]:
            status = "PASS (Clamp)" if r["clamp_ok"] else "FAIL (Clamp)"
            tgt_l = "Clamp (8x)"
            tgt_db = f"{r['ideal_db']:.2f} dB"
        else:
            if st == 0:
                status = "PASS (Base)"
            elif 3.80 <= r["step_delta_db"] <= 7.00:
                status = "PASS"
            else:
                status = "FAIL (Step)"

        out.append(
            f"{st:<5} {b_str:<6} {tgt_l:<11} {tgt_db:<10} "
            f"{m_db:<10} {m_l:<11} {d_str:<18} "
            f"{abs_db:<11} {abs_pct:<11} {rel_pct:<11} [{status}]"
        )

    out.append("-" * 122)
    out.append("Notes & Explanations:")
    out.append("  1. Target dB & Target Lin: Theoretical full-system gain (8x, 16x, ..., 8192x).")
    out.append("  2. Abs Err dB & %: Absolute discrepancy vs theoretical target. Baseline step 0 has a ~ -5.11 dB")
    out.append("     attenuation because the unbuffered IA output is loaded by the Stage 1 input resistor ladder.")
    out.append("  3. Rel Err %: Normalized step error relative to Step 0 baseline. Measures exact ladder linearity.")
    out.append("     Notice Stage 2 steps (States 6 to 10) have minimal error (~0.01 to 0.07 dB step deviation).")
    out.append("  4. States 11..15: Digital decoder clamps all out-of-range codes safely back to Step 0.")
    out.append("=" * 122)
    return "\n".join(out)

def format_markdown_table(records):
    """Formats results as a GitHub-compatible Markdown table."""
    md = []
    md.append("### PGIA Gain Step & Linearity Audit Across All 16 States")
    md.append("")
    md.append("| State | Code | Target Gain | Target (dB) | Measured (1 kHz) | Measured Linear | Step $\\Delta$ (dB) | Abs Error (dB) | Abs Error (%) | Rel Linearity Error (%) | Clamping / Status |")
    md.append("|:---:|:---:|:---:|:---:|:---:|:---:|:---:|:---:|:---:|:---:|:---|")

    for r in records:
        tgt_l = f"${r['ideal_lin']:.0f}\\times$" if not r['is_clamped'] else "Clamp ($8\\times$)"
        status = "Clamped to St0 ✅" if r["is_clamped"] else ("Baseline ✅" if r["code"] == 0 else "Monotonic Step ✅")
        md.append(
            f"| **{r['code']}** | `{r['b_str']}` | {tgt_l} | ${r['ideal_db']:.2f}\\,\\text{{dB}}$ | "
            f"**${r['meas_db']:.2f}\\,\\text{{dB}}$** | ${r['meas_lin']:.2f}\\times$ | "
            f"`{r['step_delta_str']}` | ${r['abs_err_db']:+.2f}\\,\\text{{dB}}$ | "
            f"${r['abs_err_pct']:+.1f}\\%$ | **${r['rel_err_pct']:+.2f}\\%$** | {status} |"
        )
    md.append("")
    return "\n".join(md)

def format_csv(records):
    """Formats records as CSV string."""
    lines = [
        "state,code,target_gain_linear,target_gain_db,measured_gain_db,measured_gain_linear,"
        "step_delta_db,step_delta_error_db,abs_error_db,abs_error_pct,rel_error_pct,rel_error_db,is_clamped,status"
    ]
    for r in records:
        lines.append(
            f"{r['code']},{r['b_str']},{r['ideal_lin']:.2f},{r['ideal_db']:.4f},"
            f"{r['meas_db']:.4f},{r['meas_lin']:.4f},{r['step_delta_db']:.4f},{r['step_delta_err_db']:.4f},"
            f"{r['abs_err_db']:.4f},{r['abs_err_pct']:.4f},{r['rel_err_pct']:.4f},{r['rel_err_db']:.4f},"
            f"{1 if r['is_clamped'] else 0},{'PASS' if r['clamp_ok'] else 'FAIL'}"
        )
    return "\n".join(lines)

def main():
    parser = argparse.ArgumentParser(description="Audit PGIA gain steps, percentage errors, and step deltas.")
    parser.add_argument("--run", action="store_true", help="Netlist from tb_pgia_top.sch / pgia_top.sch and simulate.")
    parser.add_argument("--env", type=str, choices=["IHPdev", "osic"], help="Force specific PDK environment profile (IHPdev or osic).")
    parser.add_argument("--no-sim", action="store_true", help="Skip simulation execution and display the stored baseline table (BASELINE_MEASURED_DB, an OLD result: implies --allow-baseline).")
    parser.add_argument("--allow-baseline", action="store_true", help="If no simulation result is available, print the stored baseline table instead of failing. It is old data, not a measurement of the current design.")
    parser.add_argument("--log", type=str, help="Parse results from existing Ngspice log file.")
    parser.add_argument("--md", type=str, help="Save Markdown table to file.")
    parser.add_argument("--csv", type=str, help="Save CSV table to file.")
    args = parser.parse_args()

    root_dir = os.path.dirname(os.path.dirname(os.path.abspath(__file__)))
    measured = {}

    # Detect active PDK environment
    pdk_env = detect_pdk_environment(root_dir, target_env=args.env)
    print("=" * 70)
    print("                ACTIVE PDK ENVIRONMENT DIAGNOSTICS")
    print("=" * 70)
    print(f"  PDK:               {pdk_env['pdk']}")
    print(f"  PDK_ROOT:          {pdk_env['pdk_root']}")
    print(f"  PDKPATH:           {pdk_env['pdk_path']}")
    print(f"  STD_CELL_LIBRARY:  {pdk_env['std_cell_lib']}")
    print(f"  STD_CELL_SPICE:    {pdk_env['std_cell_spice']}")
    print(f"  MODELS_DIR:        {pdk_env['models_dir']}")
    print("=" * 70)

    if args.log:
        if os.path.isfile(args.log):
            print(f"[*] Reading log file: {args.log}")
            with open(args.log, "r") as f:
                measured = parse_log(f.read())
        else:
            print(f"[!] Log file not found: {args.log}")
            sys.exit(1)
    elif not args.no_sim:
        try:
            # Netlist directly from the schematic testbench (which embeds pgia_top.sch)
            tb_spice = netlist_schematic_testbench(root_dir, pdk_env)
            # Run simulation directly on the netlisted schematic testbench
            log_text = run_simulation(tb_spice, pdk_env)
            measured = parse_log(log_text)
        except Exception as e:
            print(f"[!] Simulation pipeline notice: {e}")

    # No measurement: do NOT silently show old numbers as if they were a result of the current design
    if not measured:
        if args.allow_baseline or args.no_sim:
            print("[!] NO MEASUREMENT of the current design - the table below is the STORED BASELINE (old result), not a simulation.")
            measured = BASELINE_MEASURED_DB
        else:
            print("[!] No gain data could be extracted from the simulation. Not falling back to the stored baseline "
                  "(use --allow-baseline to print it explicitly).", file=sys.stderr)
            sys.exit(2)

    records = analyze_gains(measured)
    table_text = format_terminal_table(records)
    print(table_text)

    if args.md:
        md_text = format_markdown_table(records)
        with open(args.md, "w") as f:
            f.write(md_text)
        print(f"[+] Saved Markdown report to: {args.md}")

    if args.csv:
        csv_text = format_csv(records)
        with open(args.csv, "w") as f:
            f.write(csv_text)
        print(f"[+] Saved CSV data to: {args.csv}")

if __name__ == "__main__":
    main()
