orpheus016/sg13cmos5l_spma_ip__instramp/scripts/lvs_tools.py

#!/usr/bin/env python3
"""Helpers for the SG13CMOS5L KLayout LVS flow (used by scripts/run_lvs.sh, usable on their own).

  lvs_tools.py netlist-fix <in.spice> <out.spice> [--gds <layout.gds> --top <cell>]
      xschem LVS netlist -> netlist the KLayout reader accepts (.param hoisted into the .subckt, .save dropped,
      cap_cmomi/cap_cmomf with m=N written as N single caps, see expand_mom_caps)
  lvs_tools.py labels <layout.gds> <topcell> <netlist.spice> [--write <out.gds>]
      check that every subckt port has a label on a text layer the LVS deck reads (<metal>/25);
      with --write also save a scratch copy of the GDS where the missing ones are copied from the pin/drawing layer
  lvs_tools.py report <file.lvsdb>
      human readable result: per device and per net, with layout coordinates; exit 0 only on a full match

Run with `python3 -I` (needs the `klayout` python module, which ships with the KLayout of the tool image).
"""
import argparse
import re
import sys


# ----------------------------------------------------------------------------- netlist
def subckt_ports(text, name=None):
    """(name, ports) of the `.subckt` called `name` (default: the first one)."""
    for line in text.splitlines():
        if line.lower().startswith(".subckt"):
            toks = line.split()
            if name and toks[1].lower() != name.lower():
                continue
            ports = []
            for t in toks[2:]:
                if "=" in t:
                    break
                ports.append(t)
            return toks[1], ports
    return None, []


# MoM caps. The LVS deck ignores `m` on cap_cmomi/cap_cmomf (custom_reader.lvs only reads it when the model name
# contains "mim"), and its cap combiner only merges parallel caps whose terminals are on the same nets in the same
# order, while the extractor orders the two terminals by geometry. So the layout shows one device per orientation group
# (e.g. m=5 and m=4) and the schematic must be written as the same number of single caps. The deck declares the two
# terminals interchangeable, so the order is only bookkeeping; the total is checked against the schematic's m.
MOM_MARKER = {"cap_cmomi": (99, 39), "cap_cmomf": (99, 40)}
PIN_LAYERS = (8, 10, 30, 50, 67)  # Metal1..5 pin purpose (dt 2): the extractor's terminal ports


def mom_orientation_groups(gds, top, model):
    """{local first-port key: count} for every `model` cap in the layout, following CapMomExtractor's port order."""
    import klayout.db as db

    ly = db.Layout()
    ly.read(gds)
    topc = ly.cell(top) or next((c for c in ly.each_cell() if c.name.lower() == top.lower()), None)
    if topc is None:
        return None
    mk = ly.find_layer(*MOM_MARKER[model])
    if mk is None:
        return {}
    groups = {}
    it = db.RecursiveShapeIterator(ly, topc, mk)
    while not it.at_end():
        sh = it.shape()
        trans = it.trans()
        box = sh.bbox().transformed(trans)
        ports = []
        for layer in PIN_LAYERS:
            li = ly.find_layer(layer, 2)
            if li is None:
                continue
            pit = db.RecursiveShapeIterator(ly, topc, li, box)
            while not pit.at_end():
                c = pit.shape().bbox().transformed(pit.trans()).center()
                if box.contains(c):
                    ports.append((c.x, c.y, layer))
                pit.next()
        if len(ports) != 2:
            sys.exit(f"netlist-fix: a {model} marker at {box} has {len(ports)} port shapes under it, expected 2")
        first = sorted(ports)[0]
        local = trans.inverted() * db.Point(first[0], first[1])
        key = (local.x, local.y)
        groups[key] = groups.get(key, 0) + 1
        it.next()
    return groups


def expand_mom_caps(lines, gds, top):
    caps = []  # (line index, tokens, n)
    for i, line in enumerate(lines):
        tok = line.split()
        if len(tok) >= 4 and tok[0][0] in "Cc" and tok[3].lower() in MOM_MARKER:
            m = [t for t in tok[4:] if t.lower().startswith("m=")]
            caps.append((i, tok, int(float(m[0].split("=", 1)[1])) if m else 1))
    if not caps:
        return lines

    # per model: the layout's orientation groups, biggest first (at most two: the cap has two ends)
    plan = {}  # line index -> [(count, swapped)]
    for model in sorted({tok[3].lower() for _, tok, _ in caps}):
        mine = sorted([c for c in caps if c[1][3].lower() == model], key=lambda c: -c[2])
        total = sum(c[2] for c in mine)
        if not gds:
            for i, _, n in mine:
                plan[i] = [(n, False)]
            continue
        groups = mom_orientation_groups(gds, top, model)
        if groups is None:
            print(f"netlist-fix: WARNING no layout cell '{top}' for the {model} in this subckt; "
                  "keeping the orientation split of the schematic lines (m is still expanded)")
            for k, (i, _, n) in enumerate(mine):
                plan[i] = [(n, k % 2 == 1)]
            continue
        g = sorted(groups.items(), key=lambda kv: (-kv[1], kv[0]))
        counts = [c for _, c in g]
        if sum(counts) != total:
            sys.exit(f"netlist-fix: schematic has {total} x {model} (sum of m) but the layout has {sum(counts)}")
        if len(mine) == 1:
            plan[mine[0][0]] = [(c, k % 2 == 1) for k, c in enumerate(counts)]
        elif sorted(counts, reverse=True) == [c[2] for c in mine]:
            # the schematic already split the cap like the layout (e.g. m=5 and m=4): line k <-> group k
            for k, (i, _, n) in enumerate(mine):
                plan[i] = [(n, k % 2 == 1)]
        else:
            sys.exit(f"netlist-fix: {model} lines in the schematic have m={[c[2] for c in mine]} but the layout caps "
                     f"fall into orientation groups of {counts}. Make the schematic m values match the groups, or use one line.")
    out = list(lines)
    for i, tok, n in caps:
        rest = [t for t in tok[4:] if not t.lower().startswith("m=")]
        new, idx = [], 0
        for cnt, swapped in plan[i]:
            a, b = (tok[2], tok[1]) if swapped else (tok[1], tok[2])
            for _ in range(cnt):
                idx += 1
                new.append(" ".join([f"{tok[0]}_{idx}", a, b, tok[3]] + rest + ["m=1"]))
        out[i] = "\n".join(new)
        desc = "+".join(f"{c}{'(terminals swapped)' if s else ''}" for c, s in plan[i])
        print(f"netlist-fix: {tok[0]} {tok[3]} m={n} -> {n} single caps ({desc})")
    return "\n".join(out).split("\n")


def cmd_netlist_fix(args):
    text = open(args.inp).read()
    name, _ = subckt_ports(text)
    if name is None:
        sys.exit("netlist-fix: no '.subckt' line. The netlist was not generated with lvs_netlist=1 "
                 "(a simulation netlist has '**.subckt' commented out).")
    # Walk the file subckt by subckt: `.param` lines (user code block, usually after the devices) move to just
    # below their own `.subckt` line, `.save`/stray `.end` are dropped, MoM caps are expanded per subckt.
    out, block, nparam, nsub, opened = [], None, 0, 0, False
    for line in text.splitlines():
        low = line.lower()
        if low.startswith(".subckt") and block is None:
            block = {"head": line, "params": [], "body": [], "cell": line.split()[1]}
            nsub += 1
            continue
        if block is None:
            if not (low.startswith(".save") or low.startswith(".end") and not low.startswith(".ends")):
                out.append(line)
            continue
        if low.startswith(".ends"):
            body = expand_mom_caps(block["body"], args.gds, block["cell"] if args.gds else None)
            out += [block["head"]] + block["params"] + body + [line]
            nparam += len(block["params"])
            block = None
        elif low.startswith(".param"):
            block["params"].append(line)
        elif not low.startswith(".save"):
            block["body"].append(line)
    open(args.out, "w").write("\n".join(out) + "\n")
    print(f"netlist-fix: {args.out}  ({nsub} subckt(s), {nparam} .param lines moved inside)")


# ----------------------------------------------------------------------------- labels
# layer -> name; the LVS deck reads net names from (layer, 25); people usually label on (layer, 2) pin or (layer, 0)
TEXT_LAYERS = {8: "Metal1", 10: "Metal2", 30: "Metal3", 50: "Metal4", 67: "Metal5", 126: "TopMetal1", 134: "TopMetal2"}


def cmd_labels(args):
    import klayout.db as db

    _, ports = subckt_ports(open(args.netlist).read(), args.topcell)
    if not ports:
        sys.exit("labels: no subckt ports found in " + args.netlist)
    ly = db.Layout()
    ly.read(args.gds)
    top = ly.cell(args.topcell)
    if top is None:
        sys.exit(f"labels: cell '{args.topcell}' not in {args.gds}")

    found = {}  # port -> {(layer, dt): [(x_um, y_um)]}
    for layer in TEXT_LAYERS:
        for dt in (0, 2, 25):
            li = ly.find_layer(layer, dt)
            if li is None:
                continue
            it = db.RecursiveShapeIterator(ly, top, li)
            while not it.at_end():
                sh = it.shape()
                if sh.is_text():
                    p = it.trans() * sh.text.trans.disp
                    found.setdefault(sh.text.string, {}).setdefault((layer, dt), []).append((p.x, p.y))
                it.next()

    ok, missing, add = [], [], []
    for p in ports:
        where = found.get(p, {})
        if any(dt == 25 for (_, dt) in where):
            ok.append(p)
            continue
        missing.append(p)
        src = [(k, v) for k, v in where.items()]
        if src:
            (layer, dt), pts = src[0]
            for x, y in pts:
                add.append((layer, p, x, y))
            print(f"  {p:10s} NOT visible to LVS: label is on {layer}/{dt} ({TEXT_LAYERS[layer]}), needs {layer}/25")
        else:
            near = [k for k in found if k.lower() == p.lower()]
            print(f"  {p:10s} NO label at all" + (f" (found with other case: {near})" if near else ""))
    print(f"labels: {len(ok)}/{len(ports)} ports have a /25 text label"
          + (f"; missing: {', '.join(missing)}" if missing else ""))

    if args.write and add:
        for layer, txt, x, y in add:
            ly.cell(args.topcell).shapes(ly.layer(layer, 25)).insert(db.Text(txt, db.Trans(x, y)))
        ly.write(args.write)
        print(f"labels: wrote scratch copy with {len(add)} added /25 labels -> {args.write}")
    sys.exit(0 if not missing else 3)


# ----------------------------------------------------------------------------- report
def cmd_report(args):
    import klayout.db as db

    X = db.NetlistCrossReference
    names = {getattr(X, n): n for n in ("Match", "NoMatch", "Mismatch", "Skipped", "MatchWithWarning") if hasattr(X, n)}
    st = lambda s: names.get(s, "None")
    good = {X.Match}

    l = db.LayoutVsSchematic()
    l.read(args.lvsdb)
    x = l.xref()
    all_ok = True

    def loc(d):
        try:
            t = d.trans
            return f"({t.disp.x:.2f},{t.disp.y:.2f}) um"
        except Exception:
            return ""

    for cp in x.each_circuit_pair():
        lay, sch = cp.first(), cp.second()
        print(f"circuit  layout={lay.name if lay else None}  schematic={sch.name if sch else None}  -> {st(cp.status())}")
        if not (lay and sch):
            print("  one side has no counterpart: top cell name differs from the schematic .subckt name")
            all_ok = False
            continue
        if cp.status() not in good:
            all_ok = False
        lp = [p.name() for p in lay.each_pin()]
        sp = [p.name() for p in sch.each_pin()]
        print(f"  ports layout   : {' '.join(lp) or '(none: no label on a /25 text layer?)'}")
        print(f"  ports schematic: {' '.join(sp)}")
        print("  devices (layout <-> schematic):")
        for dp in x.each_device_pair(cp):
            a, b = dp.first(), dp.second()
            tag = "ok " if dp.status() in good else "!! "
            cls = (a or b).device_class().name
            print(f"   {tag}{(a.expanded_name() if a else '-'):6s} {cls:14s} <-> {(b.expanded_name() if b else '-'):6s} {st(dp.status()):16s} {loc(a) if a else ''}")
        lnet = l.netlist().circuit_by_name(lay.name) or lay   # the xref's circuit handle does not resolve nets
        caps = [d for d in lnet.each_device() if "cmom" in d.device_class().name.lower()]
        if caps:
            tot = sum(d.parameter("m") for d in caps)
            def nn(d, tname):
                net = d.net_for_terminal(d.device_class().terminal_id(tname))
                return net.expanded_name() if net is not None else "-"
            parts = ", ".join(f"m={d.parameter('m'):g} {nn(d, 'mim_top')}/{nn(d, 'mim_btm')}" for d in caps)
            print(f"  MoM caps in layout: {len(caps)} device(s), total m={tot:g}  [{parts}]")
        bad_nets = []
        for n in x.each_net_pair(cp):
            a, b = n.first(), n.second()
            if n.status() not in good:
                bad_nets.append((a.expanded_name() if a else None, b.expanded_name() if b else None, st(n.status())))
        if bad_nets:
            print("  nets that do not match (layout <-> schematic):")
            for a, b, s in bad_nets:
                hint = ""
                if a is None:
                    hint = "  <- only in schematic: merged with another net (short) or open in layout"
                elif b is None:
                    hint = "  <- only in layout: extra/unlabelled net (open in layout?)"
                print(f"   !! {str(a):10s} <-> {str(b):10s} {s}{hint}")
    print("RESULT:", "MATCH" if all_ok else "MISMATCH")
    sys.exit(0 if all_ok else 1)


def main():
    ap = argparse.ArgumentParser(description=__doc__, formatter_class=argparse.RawDescriptionHelpFormatter)
    sub = ap.add_subparsers(dest="cmd", required=True)
    p = sub.add_parser("netlist-fix"); p.add_argument("inp"); p.add_argument("out")
    p.add_argument("--gds"); p.add_argument("--top"); p.set_defaults(f=cmd_netlist_fix)
    p = sub.add_parser("labels"); p.add_argument("gds"); p.add_argument("topcell"); p.add_argument("netlist")
    p.add_argument("--write"); p.set_defaults(f=cmd_labels)
    p = sub.add_parser("report"); p.add_argument("lvsdb"); p.set_defaults(f=cmd_report)
    a = ap.parse_args()
    a.f(a)


if __name__ == "__main__":
    main()
