orpheus016/sg13cmos5l_spma_ip__instramp/(commit log)

2026-10-06 fix: ota layout
    [instramp_cmos5l.sch]
2026-10-06 fix: connectivity
    [tb_ota_cmos5l_integrated.sch]
2026-10-06 fix: simulation and instramp
    [instramp_cmos5l.sch, tb_instramp_cmos5l_ac.sch, tb_instramp_cmos5l_dc.sch, tb_ota_cmos5l_noise.sch, tb_ota_cmos5l_psrr.sch]
2026-10-08 add: gain margin meas
    [tb_ota_cmos5l_ac.sch]
2026-10-08 add: output buffer layout
    [output_buffer_tb.sch]
2026-10-10 Revise coarse-gain stage to gain stage terminology
    Updated coarse-gain stage documentation to reflect changes in gain settings and architecture details.
2026-10-10 Update coarse gain stage to be a five digital controlled gain stages with the same OTA
    [cg_network.sch, tb_cg_network.sch]
2026-10-11 Update -3dB BW units from Hz to MHz in gain stage
2026-10-11 Gain stage routing attempt about 60% done
2026-10-12 Add recent changes for gain stage OTA
2026-10-12 Routing all done for gain stage OTA, but haven't done any DRC or LVS yet
2026-10-14 add: flow glue script and report html
2026-10-14 fix: slot layout
2026-10-15 feat(digital): implement and sign off 65x45um DRC/LVS-clean gain_decoder_4b macro with West-East pin topology on IHP-SG13CMOS5L
2026-10-15 Modify gain-stage ota with cap_cmomi + multipliers (Paralel caps)
2026-10-16 Modify gain stage directory name (From coarse-gain) for xschem because the gain levels become 10, not 1024 or 2^10
2026-10-20 LVS and DRC clean of gain stage OTA and repository management again
2026-10-21 feat: adjust gain stage interface (map s1/s2 to s0...s5)
2026-10-21 feat: assemble top-level schematic
2026-10-21 Did pre-layout CACE simulation, LVS, DRC, PEX (R and RC), and post-layout CACE simulation to gain stage OTA with passed as the status and changes regarding automated scripts
2026-10-21 Rerun flow scripts of gain OTA for CACE pre-layout simulation, DRC, LVS, PEX (C and RC), and post-layout C and RC with recent pull of IHP-Open-PDK and initiate gain network layouting
2026-10-22 Gain stage done (Pre-layout simulation, gds, drc, lvs, pex with C and RC, and post-layout simulation), but with some poor performance metrics
2026-10-23 feat: implement environment & automated assembly tooling setup for pgia_top
2026-10-23 feat: implement power & ground grid distribution on pgia_top
2026-10-23 feat: top-level layout assembly drc sign-off
2026-10-28 feat: better interconnvectivity to padframe slot
2026-10-29 Modify top-level to have pseudo-resistors as input resistors that has resistance over GOhms and simulation scripts to check input resistance, narrow dc sweeps, and overall CACE simulation based on CA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
2026-10-29 feat: add xschem schematics for programmable instrumentation amplifier IP and top-level wrapper
2026-10-29 Revert pgia_top simulations to the final one with pseudo-resistors
2026-10-30 Add final pgia_top and gain_network schematics, but without the simulation results
2026-10-31 Gain network layout has been placed without any DRC issues, but top-level & slot wrapper routing hasn't been completed yet and LVS hasn't been done for top-level inside the slot wrapper
2026-11-02 fix: gds slot
2026-11-03 Sync again gain_network schematic with the right version
2026-11-03 Sync gain network schematic changes to the right vesion
2026-11-03 Fix and generate spice of gain stage and its testbench schematic
2026-11-03 Gain stage and gain network DRC clean (except density checks) and LVS clean with an additional dantenna on gain network to solve antenna DRC issues
2026-11-03 Checkout new modified files for gain network and gain stage from origin/james because they are newer
2026-11-04 slot9_wrapper gds is left behind on branch origin/james, so I retrieved files again
2026-11-04 M1: harness integration - gds/slot_9.gds, harness trial, harness-style DRC
    The Chipalooza harness clones this repo as dependencies/slot_9 and only
    accepts slot_9.gds with a top cell named slot_9 (get_project_gds.sh);
    this repo had only slot9_wrapper.gds -> the project would not have been
    picked up.
    - scripts/export_slot_gds.py: gds/slot_9.gds = slot9_wrapper.gds with the
    top cell renamed; checks frame size, golden frame polygons/labels,
    XOR identity, a single slot_9.gds* in the repo; --check = staleness
    - scripts/harness_trial.sh: runs the harness's own get_project_gds.sh on
    a sandbox copy, reads the file with Magic as the generated Tcl does
    and verifies the written geometry is iden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
2026-11-04 M2: layout audits - tap/latch-up audit and LVS canary
    - scripts/tap_audit.py: checks what neither LVS nor the PDK DRC deck
    checks. LU.a (p+ Activ in NWell to n-tie) and LU.b (n+ Activ to p-tie;
    the PDK deck names LU.b but implements nothing) within 20 um, every
    NWell with p+ Activ has a tie, and p+/n+ Activ abutment outside
    standard cells against an accepted baseline. Applied to the
    pre-fix pgia_top layout it flags exactly the four bridge boxes of the
    pseudo-resistor bug (x=495.47 um).
    - docs/<cell>/audit_baseline.json: accepted designed abutted ties of the
    LVS-clean cells (pgia_top, slot9_wrapper, ota, instramp, buffer).
    - scripts/lvs_canary.py: scratch-copy mutations (W x1.5,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
2026-11-04 M3: scripts/build_all.sh - build and verify everything with one command
    - build_all.sh [--fast] [--cells] [--profile] [--no-mc] [--skip] [--open]:
    registry check -> slot_9.gds export -> flow.sh of every cell (leaves
    first) -> LVS canary -> pictures/README blocks -> HTML reports ->
    docs/build_summary.{md,json}; exit 0 ok / 1 check failed / 2 error
    - flow.sh: new stages audit, drc_harness, deliver (+ status ordering);
    cellinfo.py: harness_gds key
    - build_chip_report.py: static HTML for cells without CACE datasheet and
    docs/index.html for all cells with the last build summary
    - cells.yaml: audit for all layout cells; slot9_wrapper additionally
    drc_harness + deliver (harness_gds gds/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
2026-11-04 M4: pgia_top CACE on the current 13-pin top level; honest chip-level sim
    The friend's pgia_top CACE (16 pins, IBIAS_G1/G2/BUF, 6-pin buffer) is
    adapted and now runs on the current design:
    - templates/manifest/datasheet without the three removed bias pins; DUT
    std-cell and decoder .include at testbench top level (the includes
    inside the DUT netlist are nested in .subckt pgia_top and invisible to
    the sub-blocks); cells.yaml: pgia_top cace + stages
    cace drc audit lvs pex post
    - tb_pgia_top.sch: bias sources of the removed pins removed, diode model
    lib added (the gain network now contains an antenna diode)
    - audit_gain_steps.py: pins ihp-sg13cmos5l (the container default PDK
    ihp-sg13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
2026-11-05 S3: instramp CACE with the pseudo-resistor input network (input_network)
    The instramp CACE drives VINN/VINP/CM with ideal sources, but in pgia_top
    the four PMOS pseudo-resistors sit on the inputs outside the cell. New
    parameter input_network: the network (generated from the LVS netlist of
    pgia_top by scripts/make_instramp_inbias_template.py, so it cannot drift)
    and a source impedance Rs (default 100 kOhm) in front of both inputs.
    Measured (typ / min..max over PVT, no MC): R_IN 17.5 GOhm (5.1..46.9),
    gain 18.061 dB (identical to the ideal-input run), THD -63.52 dB and HD3
    identical, offset identical, input noise @1 kHz 359.1 vs 354.6 nV/rtHz
    (+1.3 %, the thermal noise of the 2 x 100 kOhm sou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
2026-11-05 S1: output buffer polarity - schematic and layout (VOUT latched at the supply)
    The 5-pin output_buffer had its input on the OTA's inverting pin and
    VOUT fed to the non-inverting pin: positive feedback. LVS matched (the
    layout was drawn to the same wrong netlist); chip simulation showed
    VOUT = 1.15 V and ~-100 dB gain.
    - output_buffer.sch: input -> VINP, VOUT feedback -> VINN
    - fix_buffer_polarity.py (backup + exact-shape guard, idempotent): in the
    buffer's top cell only (the OTA cell is shared with the instramp) the
    upper input stub is tied to the lower OTA pad, the feedback strap is
    cut and carried over the stub by a Via3 / Metal4 jumper to a landing
    pad on the OTA VINN pad; one pg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
2026-11-05 S2a: central_bias schematic - four pgia_top bias currents from the one harness pin
    pgia_top ties one net (IBIAS_IA) to blocks that need opposite bias
    polarities (IA/buffer OTA pins are sunk, gain_ota pins are sourced) and
    different values. central_bias (7 transistors, NMOS reference + sink
    mirrors, one NMOS tap into a PMOS reference + two source mirrors) makes
    IA 4.4 / buffer 1.47 / stages 1.08 + 1.08 uA from 1.0 uA sourced.
    scripts/verify_central_bias.py (also step 'bias' of build_all.sh) builds
    the chip testbench from the current schematics with central_bias in place
    and checks currents, VOUT, power and all 11 gain codes against commit
    0777ca0: VOUT 0.5991 V, 277 uW, every code within 0.0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
2026-11-05 S2b: central_bias layout generated from PDK PCells (DRC 0, tap audit, LVS MATCH)
    scripts/make_central_bias_layout.py builds gds/central_bias/central_bias.gds
    (99 x 26 um): 62 NMOS unit devices (W=1u L=2u) and 28 PMOS (W=2u L=2u),
    two staggered rows per block with a shared poly gate bus, source bus and
    taps (one per 12 um), one Metal2 drain track per mirror group, pins as
    labels (signals M3, supplies M4). LVS: the layout sums to W 33/11/10/8 u
    and 20/18/18 u, matching the schematic multipliers. Idempotent (--check).
    Not done: end dummies and exact common-centroid order. Not instantiated in
    pgia_top yet.
2026-11-05 S2c: central_bias integrated in pgia_top (schematic + layout); the chip runs from the one harness bias pin
    Schematic: pgia_top.sch splits the shared IBIAS_IA net into ib_ia / ib_g1 /
    ib_g2 / ib_buf made by x_bias (central_bias) from the IBIAS_IA pin; the
    pin list is unchanged. The chip testbench and the CACE templates now source
    1.0 uA into the pin (ibias0 of the harness) instead of sinking 4.2 uA.
    Layout: scripts/integrate_central_bias.py (backup + exact-shape guard,
    idempotent) places the cell above stage 1, cuts the old bias tree into
    five pieces and joins them to the cell with a small maze router on
    Metal2-4; AVSS to the M4 landing of the TopMetal1 AVSS rail, AVDD to the
    AVDD M4 line. A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
2026-11-05 Fix the post-layout chain: antenna diodes in pex_netlist, std cells in gain_stage/gain_network CACE
    - pex_netlist.py: kpex diode lines (D$n a b dantenna A=.. P=.. m=1) become
    Xd.. a b dantenna w= l= (w, l solved from area and perimeter); this made
    the extraction of gain_network / gain_stage / pgia_top stop with
    "unhandled line".
    - cace/gain_stage.yaml: quote the descriptions with a colon (YAML error,
    CACE never started for gain_stage).
    - make_gain_stage_templates.py / make_gain_network_templates.py: include the
    std-cell models at the top level of the testbenches (the include inside
    the DUT netlist is invisible to sub-blocks: "unknown subckt
    sg13cmos5l_nor3_1", every simulation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
2026-11-05 CACE datasheet for central_bias (currents over corner / temperature / supply / ibias0, Monte Carlo mismatch)
    scripts/make_central_bias_templates.py writes the testbench: the DUT with
    the bias references of the blocks as loads (PMOS diode m=3 for the
    instrumentation amplifier, m=1 for the buffer, NMOS diode for each gain
    stage) behind zero-volt sense sources, ibias0 sourced into IB_IN.
    cace/central_bias.params.yaml -> cace/central_bias.yaml: parameters
    `currents` (5 corners x 3 vdd x 3 temperatures x ibias0 0.7/1.0/1.3 uA) and
    `mc_currents` (50 mismatch seeds). Nominal: 4.44 / 1.48 / 1.08 / 1.08 uA,
    ratios within 3.5..5.7 / 1.2..1.9 / 0.9..1.3 over all conditions.
    flow.sh runs scripts/make_<c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
2026-11-05 Post-layout of the integrated chip: substrate and floating-node handling, per-gain-code table; full characterization with Monte Carlo
    - pex_netlist.py: the substrate (VSUBS) is tied to the cell's ground port
    when there is no VSS port (pgia_top: AVSS); metal islands that carry only
    coupling capacitors get a 1 TOhm leak (singular matrix at the operating
    point otherwise). Both for the kpex C netlist and the Magic RC netlist.
    - make_central_bias_layout.py: pin-purpose shapes under the labels (Magic
    only makes ports from them) -> RC extraction of central_bias works.
    - run_postlayout.sh: the typ profile keeps gain_code fully swept.
    - gain_code_table.py -> docs/pgia_top/cace/gain_codes.md: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
2026-11-05 Expose the intentional input offset: CACE condition vin_off (0 / -334.7 / -903.7 uV) for pgia_top
    The chip has a systematic input-referred offset (~0.33 mV in the schematic,
    ~0.90 mV in the extracted layout). Without compensation it rails the output
    at gain codes 8-10. tb_pgia_top hides it with V_INP = -334.7 uV; the CACE
    testbenches used 0 V.
    - make_pgia_top_templates.py / pgia_top.params.yaml / pgia_top.yaml: new
    condition vin_off (ac_gain, dc_op, tran), enumerate 0, -334.7 (schematic
    null), -903.7 uV (extracted-layout null, bisected on code 10; C and RC
    netlist agree).
    - run_postlayout.sh keeps gain_code and vin_off swept; gain_code_table.py
    prints gain per code for every offset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
2026-11-06 Add real EEG/EMG/ECG excerpts from PhysioNet and a fetch script
    Short windows of public recordings to use as realistic chip inputs:
    - EEG: eegmmidb S001R02 (eyes closed), channel Oz, 4 s, 160 Hz (54 % of power in alpha band)
    - EMG: emgdb healthy needle EMG, tibialis anterior, 1 s, 4 kHz
    - ECG: MIT-BIH record 100, MLII, 4 s, 360 Hz
    fetch_data.py parses EDF / WFDB-16 / WFDB-212 with numpy only (no wfdb) and
    regenerates the CSVs; ATTRIBUTION.md gives citations and the ODC-By licence.
2026-11-06 Add slot9_wrapper biosignal testbenches (schematic + extracted layout) and results
    gen_tb.py writes an ngspice deck that drives slot9_wrapper (VCM = 0.6 V, 1.2 V, 1 uA bias,
    15 pF / 100 kOhm load) with a recorded biosignal as a differential PWL source, on three DUTs:
    the schematic netlist, the kpex C-only netlist and the Magic R+C netlist (the latter two wrapped
    in a slot9_wrapper subckt; the wrapper is a pure pin pass-through). The intentional input offset
    vin_off is applied on VINP: -334.7 uV (schematic null) / -903.7 uV (extracted-layout null).
    run_biosignal.py runs the matrix (one thread per ngspice process - several threads per process
    oversubscribed the machine) and computes fitted ga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
2026-11-06 Add interactive biosignal report (self-contained HTML)
    docs/biosignal/report.html: one file, inline CSS/JS/SVG, no external requests, light/dark aware.
    Pick EEG / EMG / ECG, schematic / layout C / layout RC and gain code; views for input vs output,
    output zoomed and overlay of VOUT / ideal gain on the recorded input; drag to zoom, hover values,
    metrics cards and a table of every simulated case (selectable). State is also set through the
    URL hash, e.g. report.html#sig=eeg&net=pex_rc&code=8&view=overlay. The page states its scope:
    ideal offset null only, typical corner, short windows. Built by build_report.py from
    sim/biosignal/results.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
2026-11-06 Document the real-biosignal demo and link it from the root README
    docs/biosignal/README.md: sources of the EEG/EMG/ECG recordings, slot9_wrapper pin map and test
    setup, the vin_off input-offset quirk (-334.7 uV schematic / -903.7 uV layout), results table for
    schematic, layout C and layout RC, gain-code sweep, limitations, how to reproduce, and what is
    scheduled for the complete run (unnulled case, corners, longer windows, noise). The results are
    for the ideal offset null only and short windows, and the doc says so.
    Root README: new 'Real usage' group in Shortcuts.
